eyazaoun/BeeWarm/Progress/Photos/PCB_SCHEMATIC.jpeg

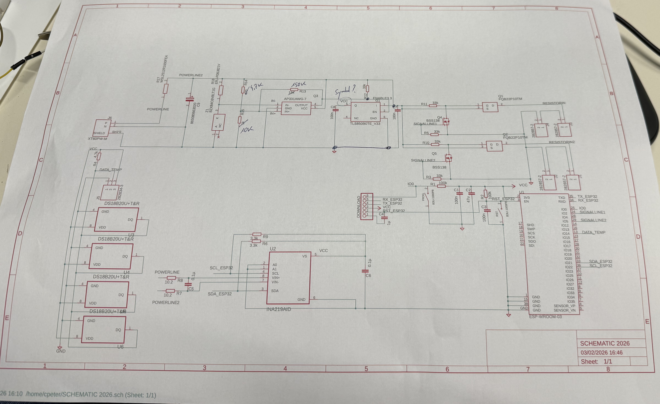
Progress/Photos/PCB_SCHEMATIC.jpeg
