eyazaoun/BeeWarm/Progress/Photos/IMG_8524.jpeg

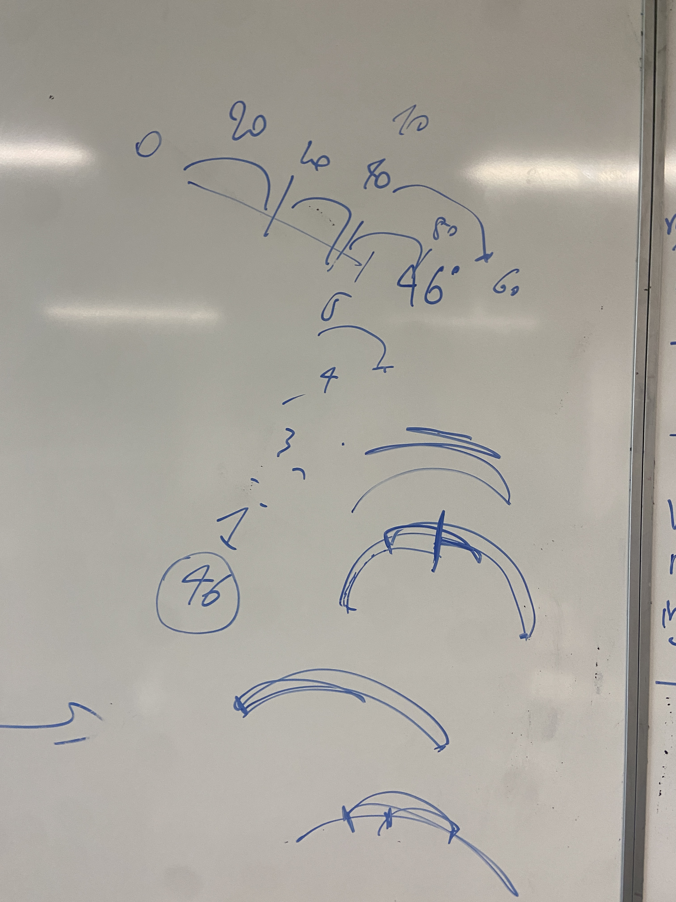
Progress/Photos/IMG_8524.jpeg
