eyazaoun/BeeWarm/doc/SOUTENANCE S7 PROJET ELECTRONIQUE BEEWARM.pptx

## PROJET ELECTRONIQUE :

BEEWARM

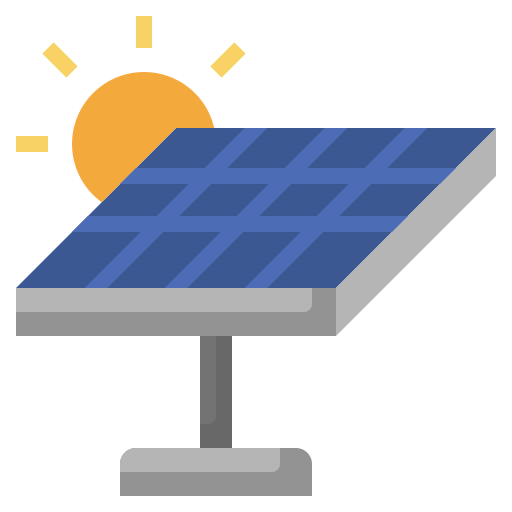
[picture p18: figure]
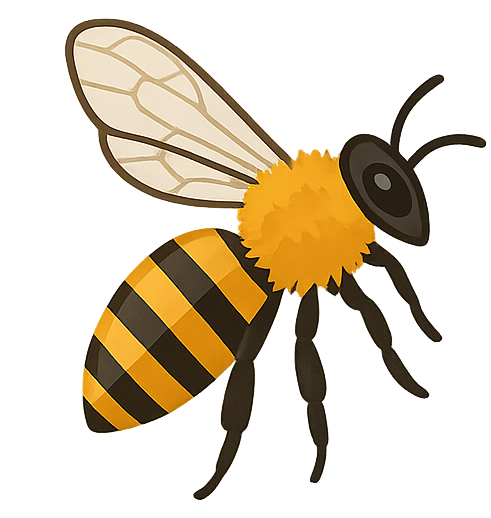
[picture p19: figure]
ChatGPT Image 25 oct. 2025, 20_07_55

Eya ZAOUN
Valentin GIROD-ROUX
Hussein ELSOUDA
Anas ESSALIMI
Électronique et Systèmes Embarqués - 2025/2026

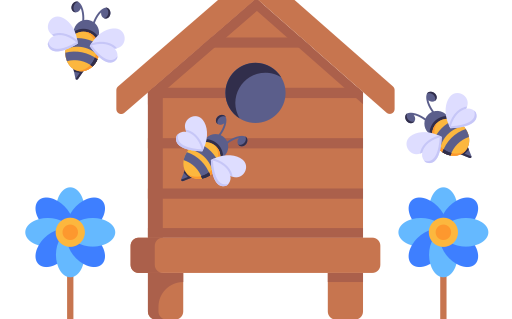
[picture p20: figure]
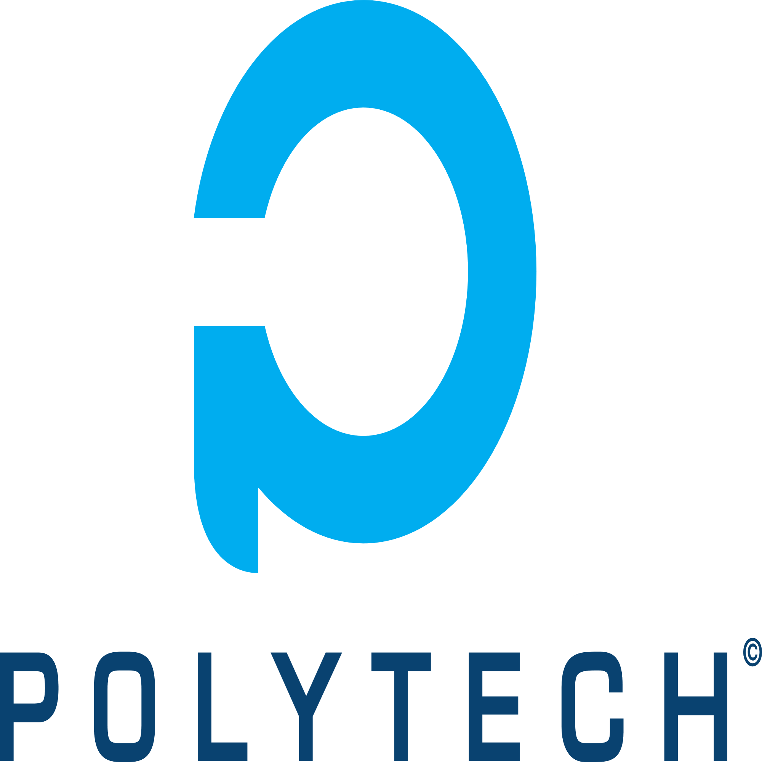
[picture p21: figure]
Logo_Reseau_Polytech
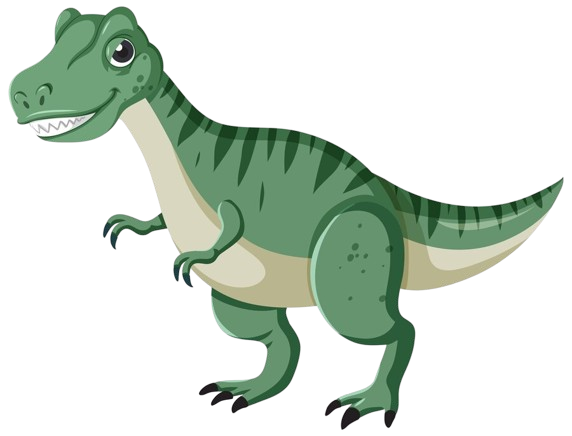
[picture p22: figure]
dino_poly-removebg-preview

## Contexte et problématique

- Système de chauffage utilisant l'énergie solaire facilitant le développement d'essaim
- Sensibilité des abeilles aux variations de température
- Besoin de maintien thermique en hiver
- Système autonome (sans réseau électrique / sans batterie)
- Suivi et réglage à distance

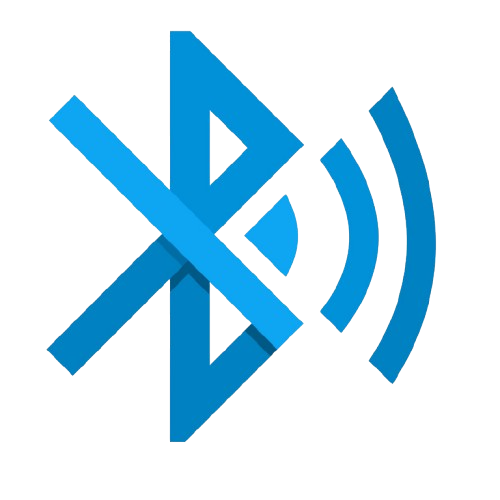
[picture p23: figure]

1

## EXIGENCES DU SYSTèME

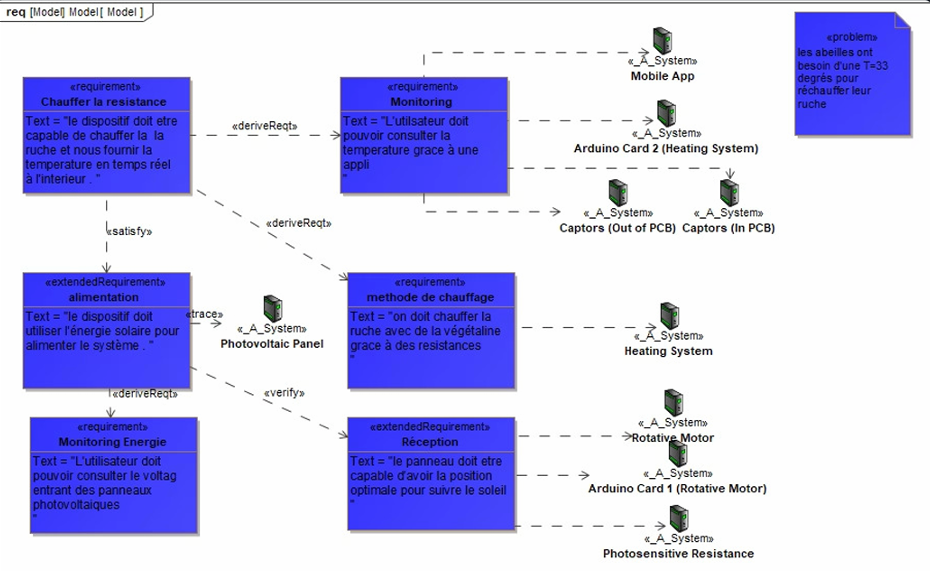
[picture p24: figure]

2

## Suivi solaire et alimentation

- Panneau solaire orientable
- Photo-résistances (détection du soleil)
- Moteur pas à pas

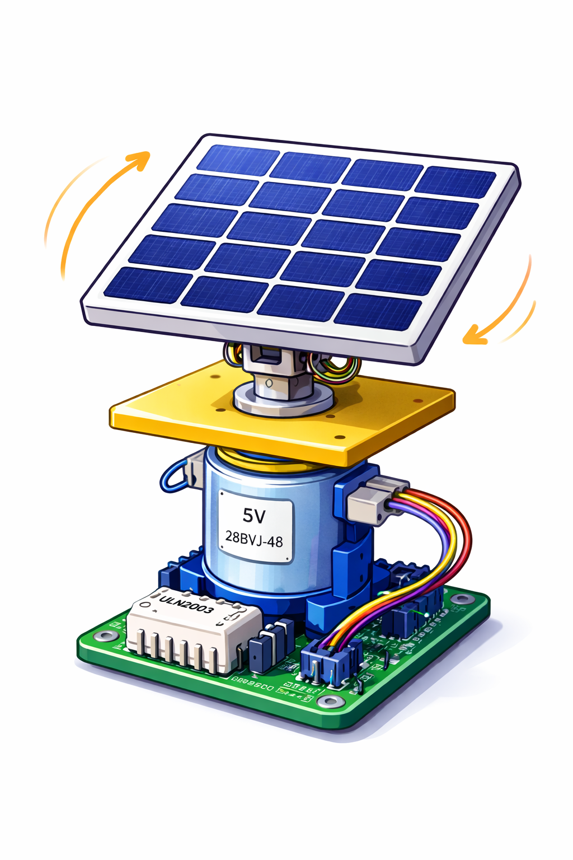
[picture p25: figure]
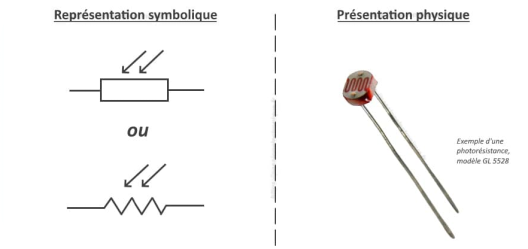
[picture p26: figure]

3

## Fonctionnement d’UNE photorésistance

- Composant créé à partir d’un semi-conducteur
- Résistance diminue lorsque c’est éclairé

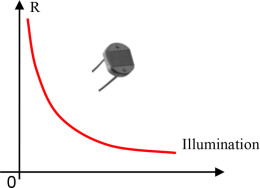
[picture p27: figure]

4

## PILOTAGE AUTOMATIQUE DU MOTEUR

- Moteur pas à pas 28BYJ-48 avec driver ULN2003
- Commande basée sur la différence de tension entre les photorésistances

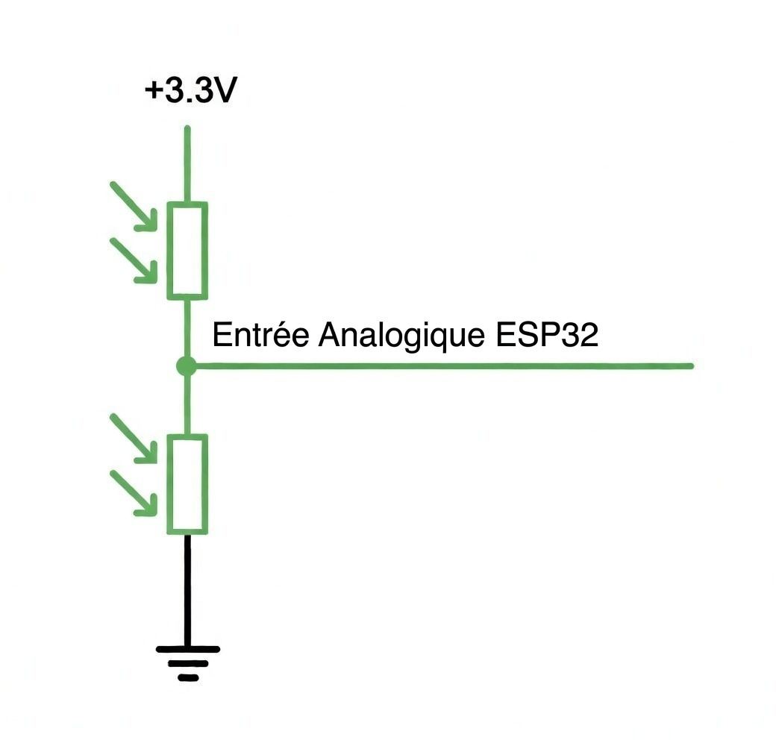
[picture p28: figure]

5

## PILOTAGE AUTOMATIQUE DU MOTEUR

- On peut distinguer trois cas :

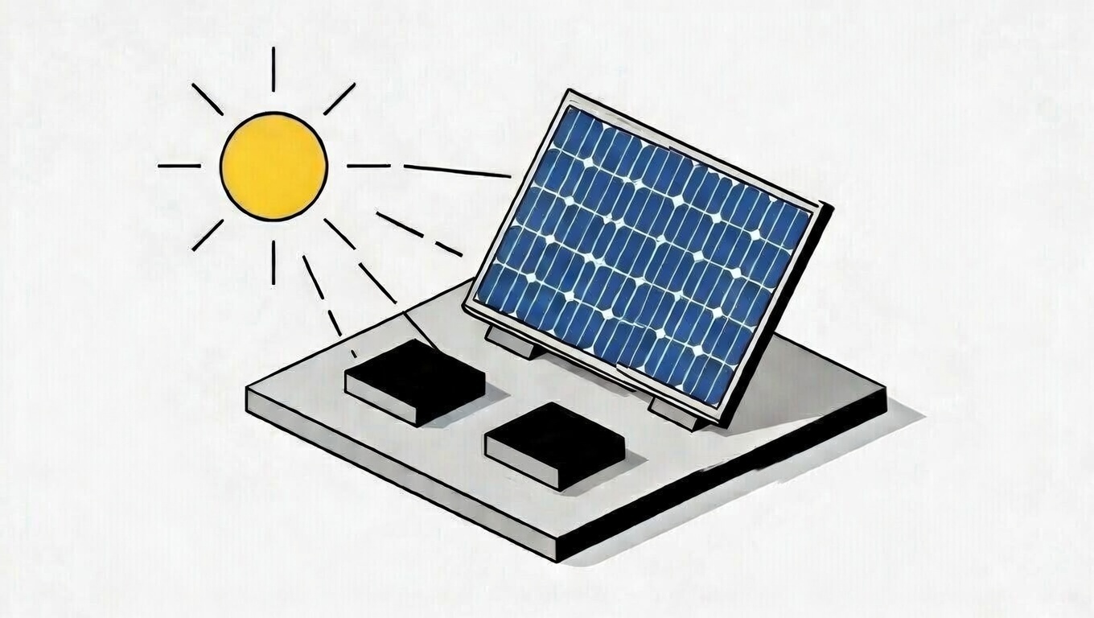
[picture p29: figure]
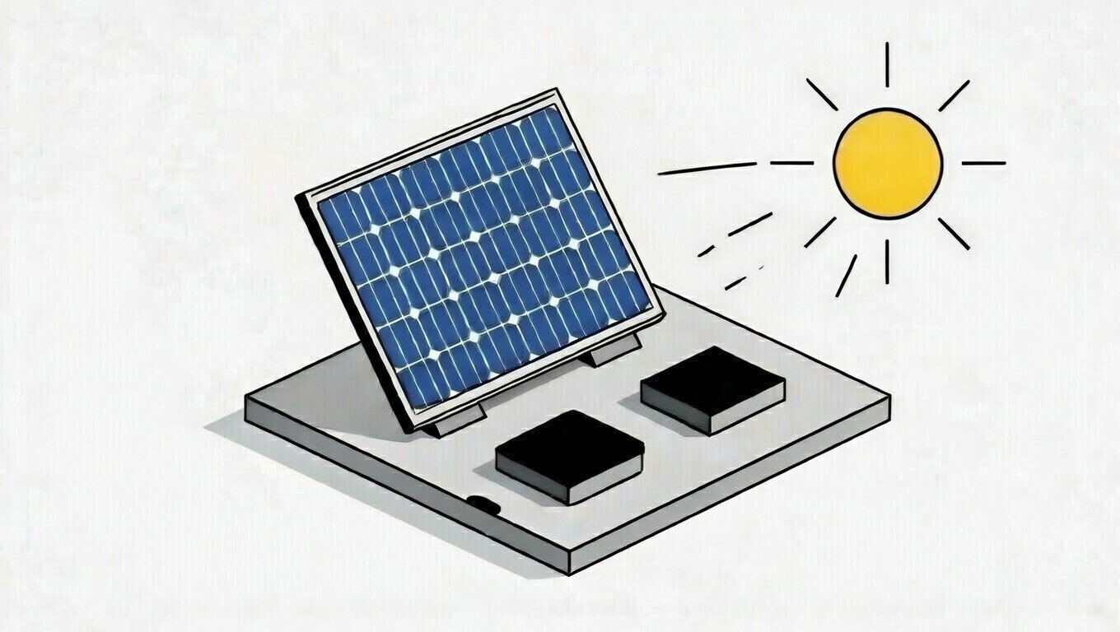
[picture p30: figure]
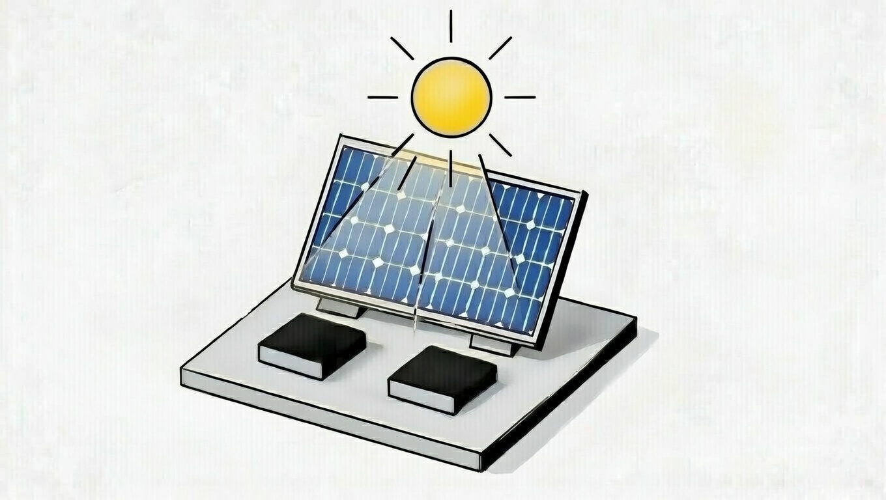
[picture p31: figure]

6

## PILOTAGE AUTOMATIQUE DU MOTEUR

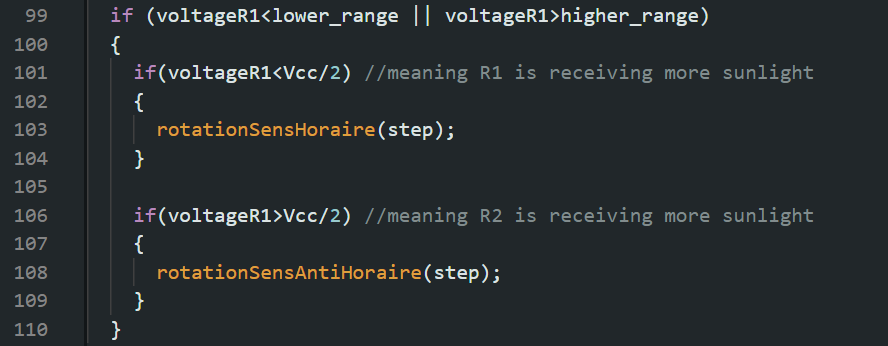
[picture p32: figure]

7

## Chauffage et régulation de température

- Capteurs DS18B20
- Température ruche / végétaline
- Température de consigne
- Chauffage par résistances
- Adaptation de la puissance de chauffe via PWM en fonction de la puissance solaire

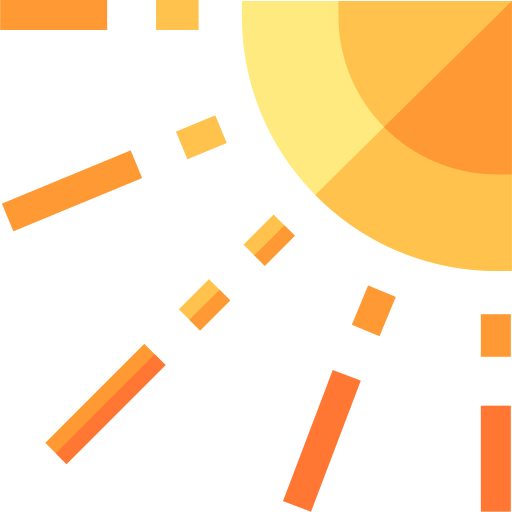
[picture p33: figure]
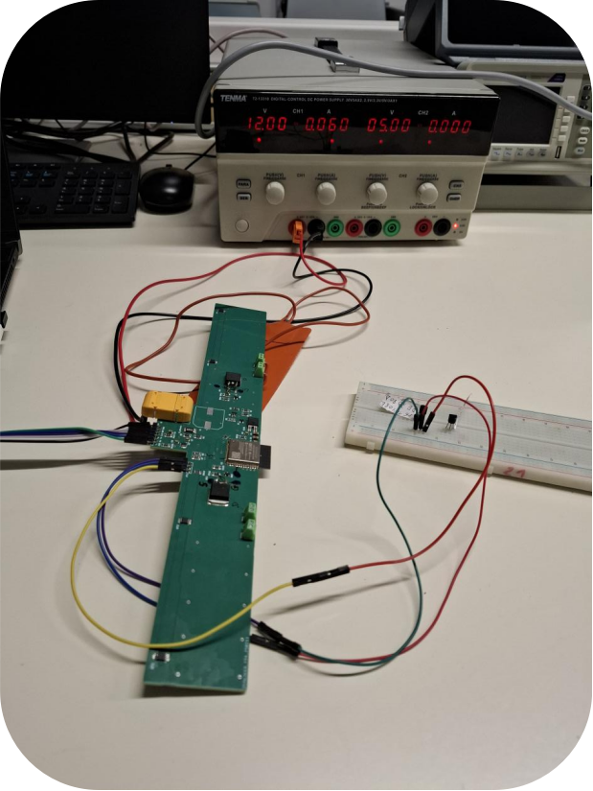
[picture p34: figure]

8

## Communication Bluetooth

- Bluetooth classique ESP32
- Échange de données bidirectionnel
- Monitoring + réglage consigne
- Choix Bluetooth :
  - Faible consommation
  - Pas d’infrastructure réseau

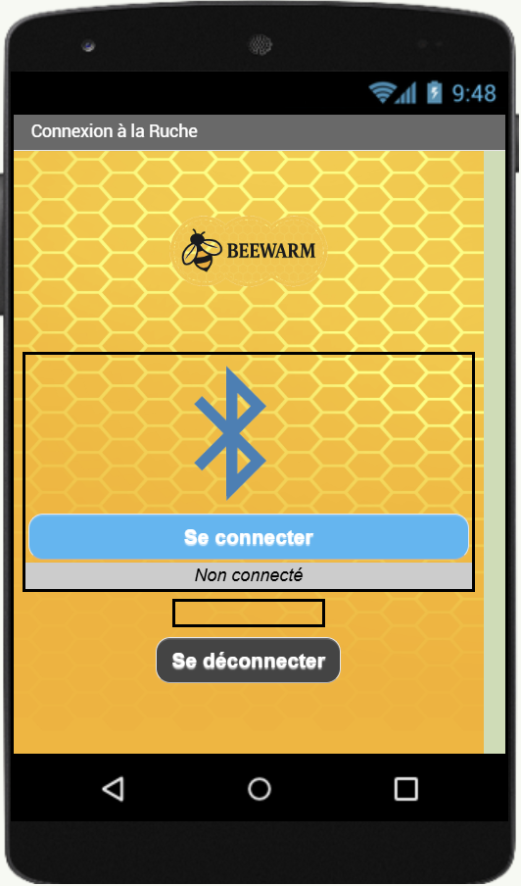
[picture p35: figure]
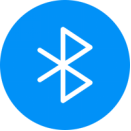
[picture p36: figure]
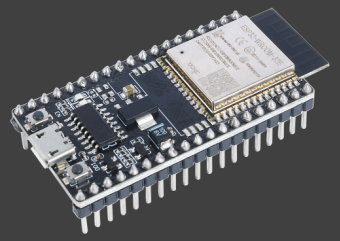
[picture p37: figure]

9

## Protocole de communication

- Message ESP32 → Smartphone :
DATA;tVeg°C;tRuche°C
- Message Smartphone → ESP32 :
SET:SP=32
- Format simple et robuste
- Facile à parser

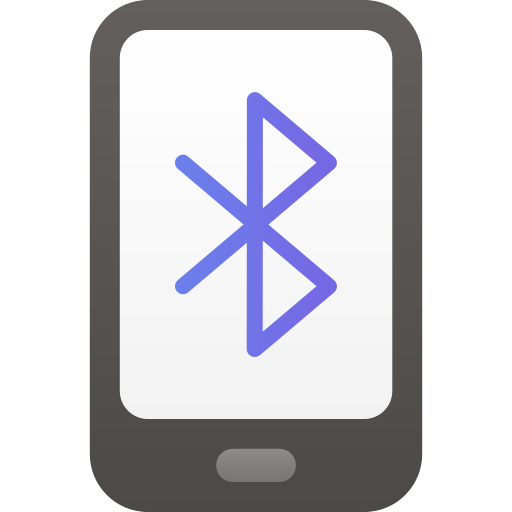
[picture p38: figure]
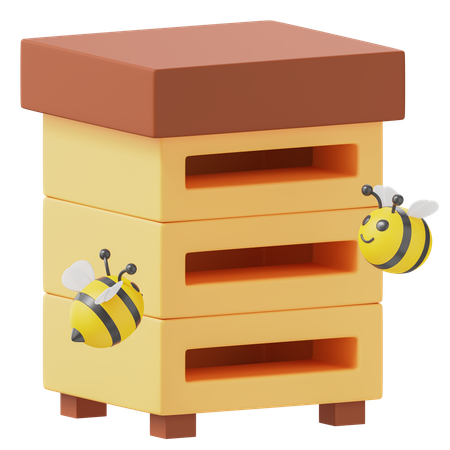
[picture p39: figure]

10

## Slide 12

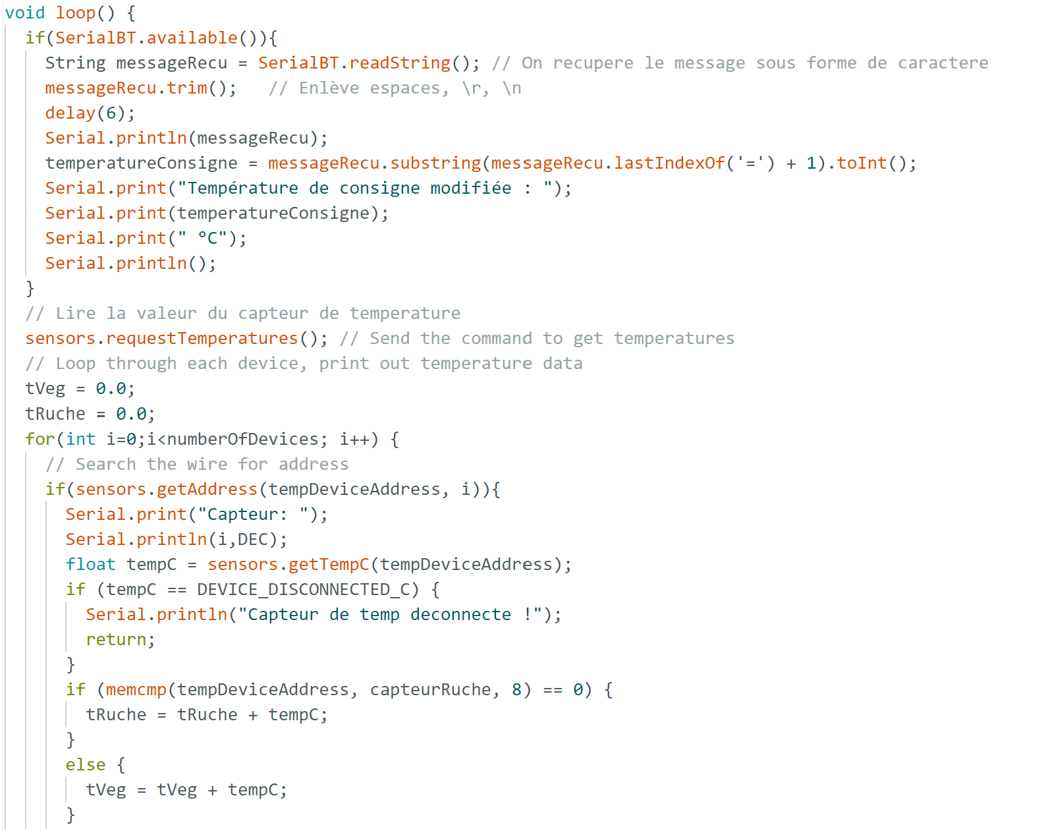
[picture p40: figure]

Détection des Capteurs et mise à jour des températures

Modification de consigne

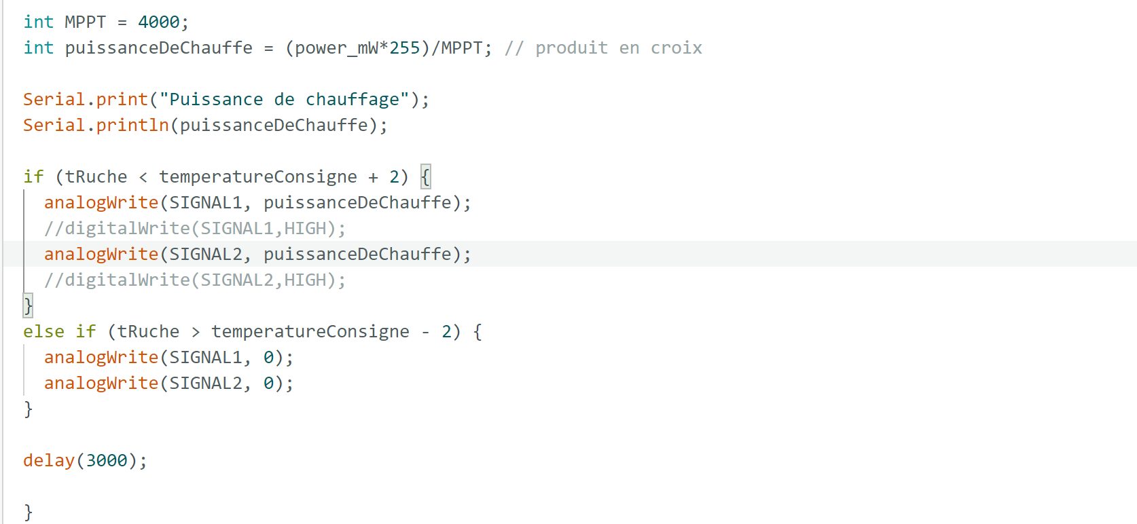
[picture p41: figure]

Control de chauffage

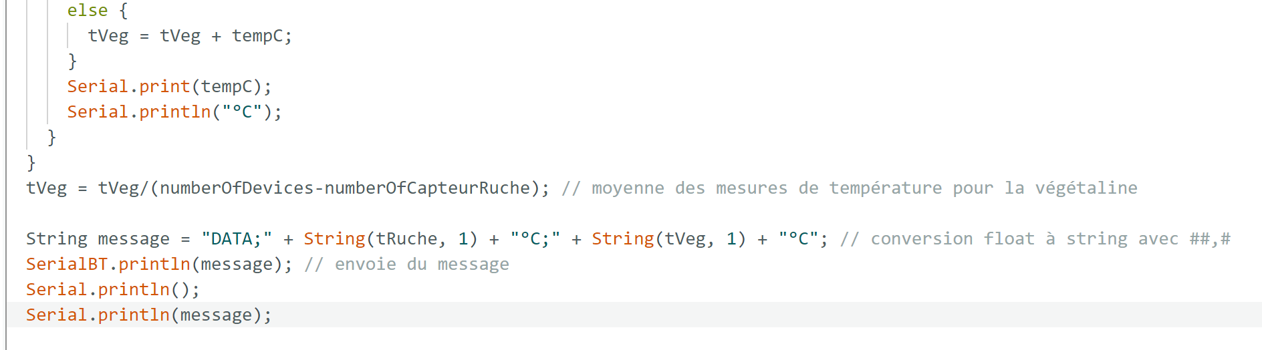
[picture p42: figure]

Affichage et envoie des données

Calcul de tVeg

11

## Application Android

- Développée sous MIT App Inventor
- Plusieurs écrans :
  - Connexion Bluetooth
  - Menu
  - Monitoring température
  - Réglage consigne

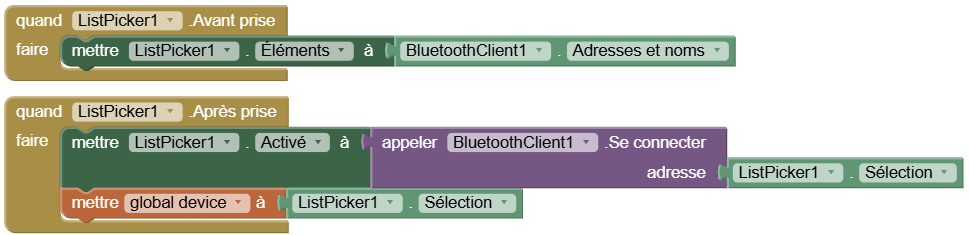
[picture p43: figure]
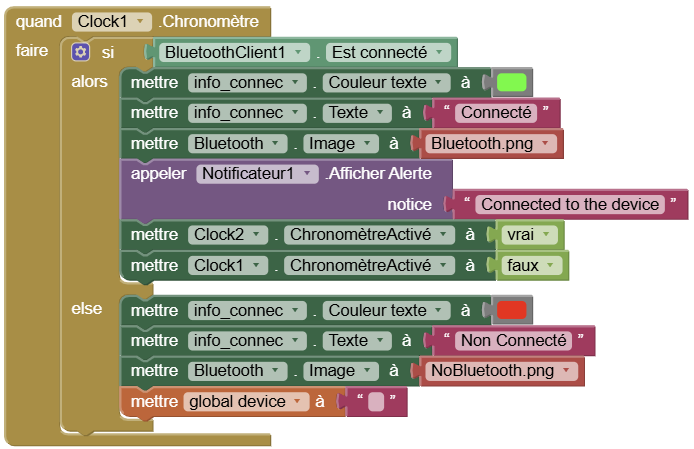
[picture p44: figure]

12

## Application Android

- Développée sous MIT App Inventor
- Plusieurs écrans :
  - Connexion Bluetooth
  - Menu
  - Monitoring température
  - Réglage consigne

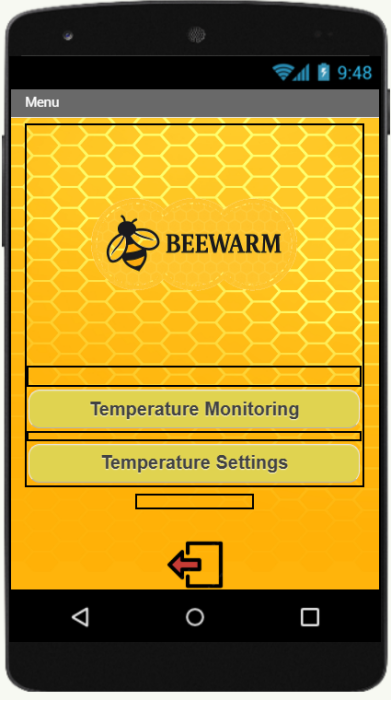
[picture p45: figure]
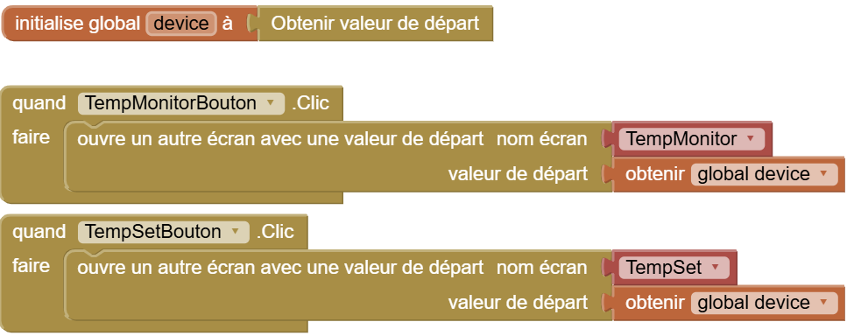
[picture p46: figure]

13

## Application Android

- Développée sous MIT App Inventor
- Plusieurs écrans :
  - Connexion Bluetooth
  - Menu
  - Monitoring température
  - Réglage consigne
- Graphiques en temps réel

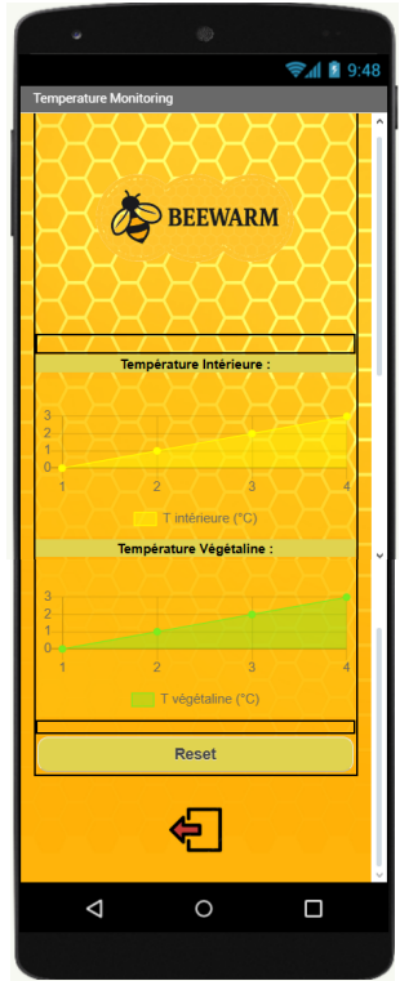
[picture p47: figure]
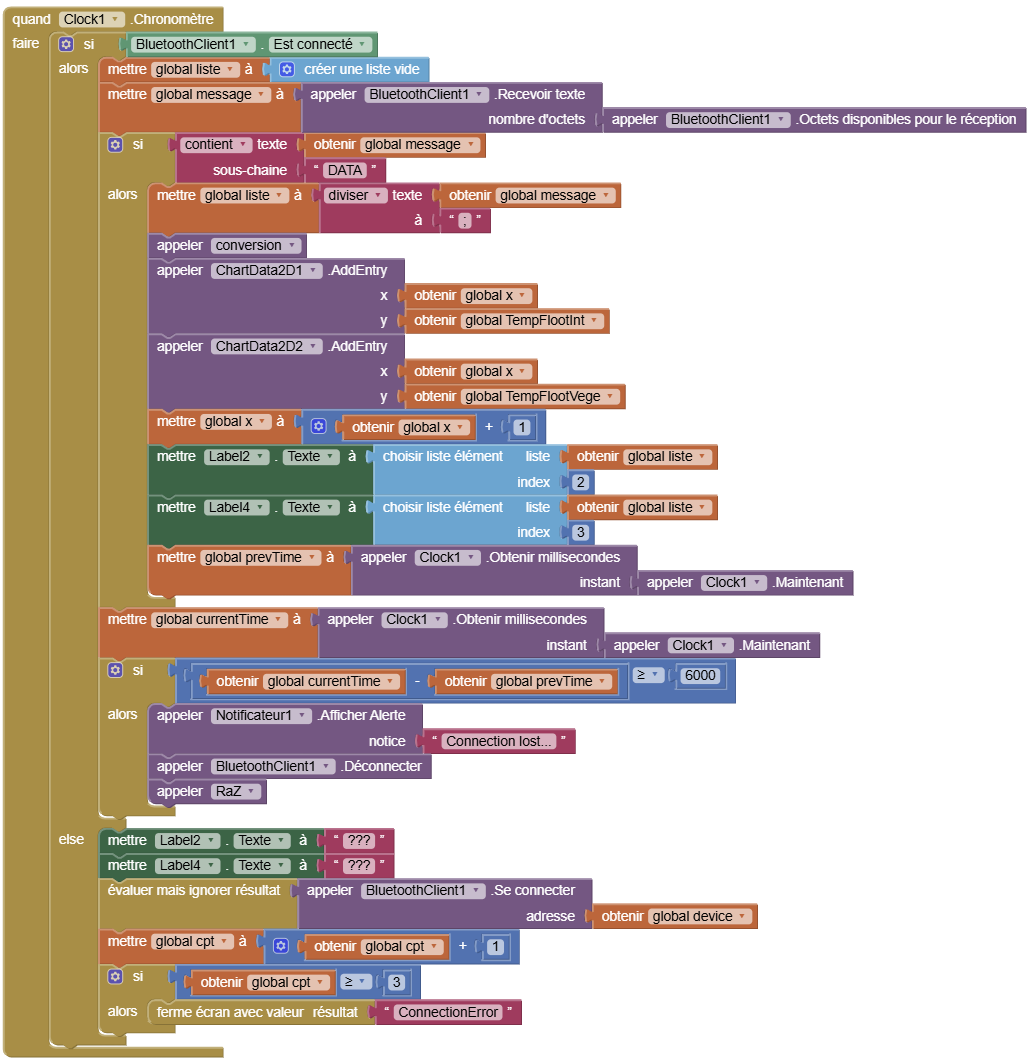
[picture p48: figure]
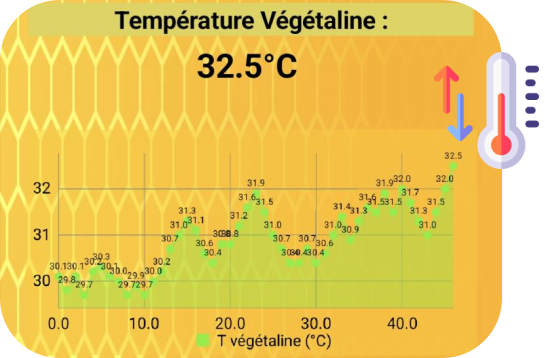
[picture p49: figure]

14

## Application Android

- Développée sous MIT App Inventor
- Plusieurs écrans :
  - Connexion Bluetooth
  - Menu
  - Monitoring température
  - Réglage consigne

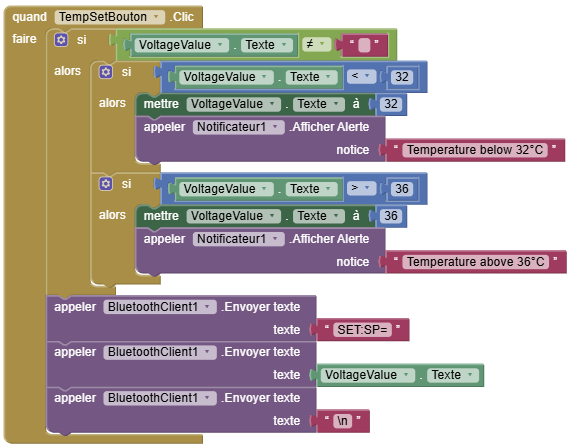
[picture p50: figure]
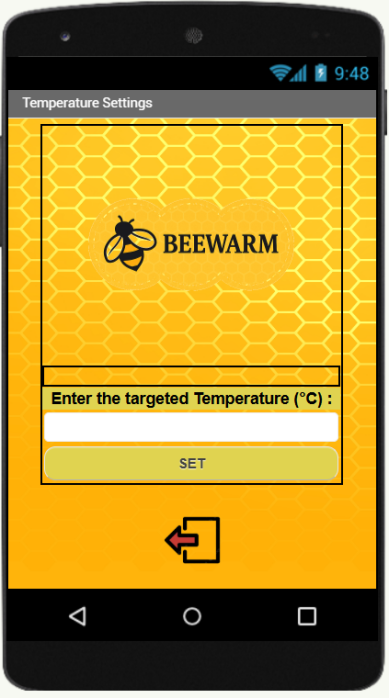
[picture p51: figure]

15

## Robustesse de la communication

- Surveillance du temps entre messages
- Détection de perte Bluetooth (> 5 s)
- Reconnexion automatique (2 tentatives)
- Retour à l’écran de connexion

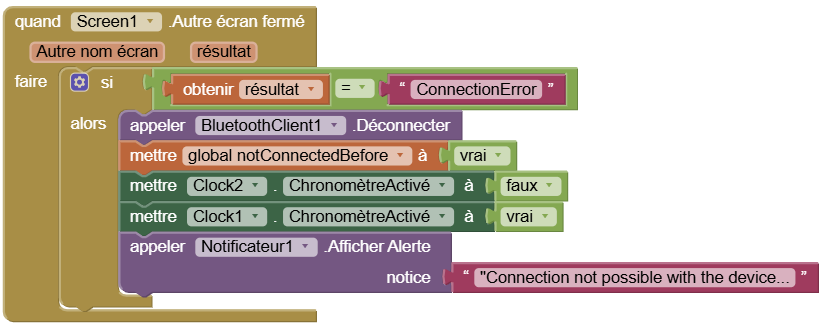
[picture p52: figure]
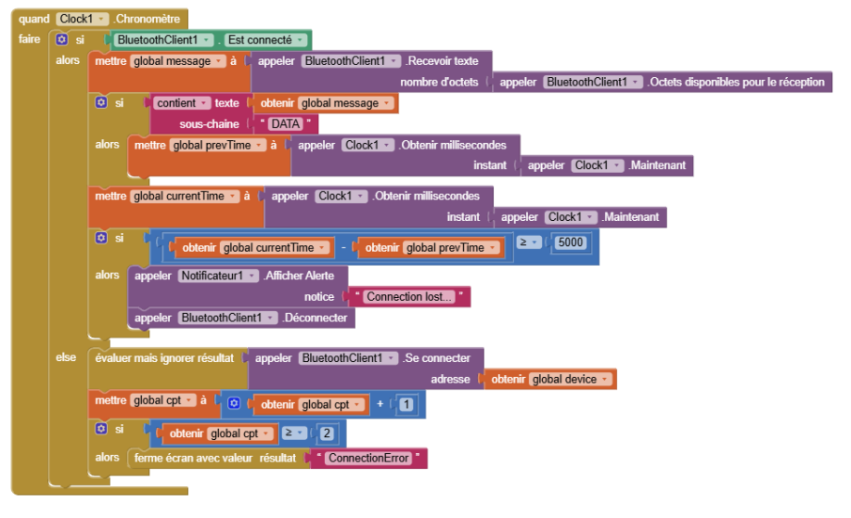
[picture p53: figure]

16

## Architecture du système

- Panneau solaire orientable
- Carte électronique (ESP32)
- Capteurs de température
- Résistances chauffantes
- Communication Bluetooth
→ Smartphone

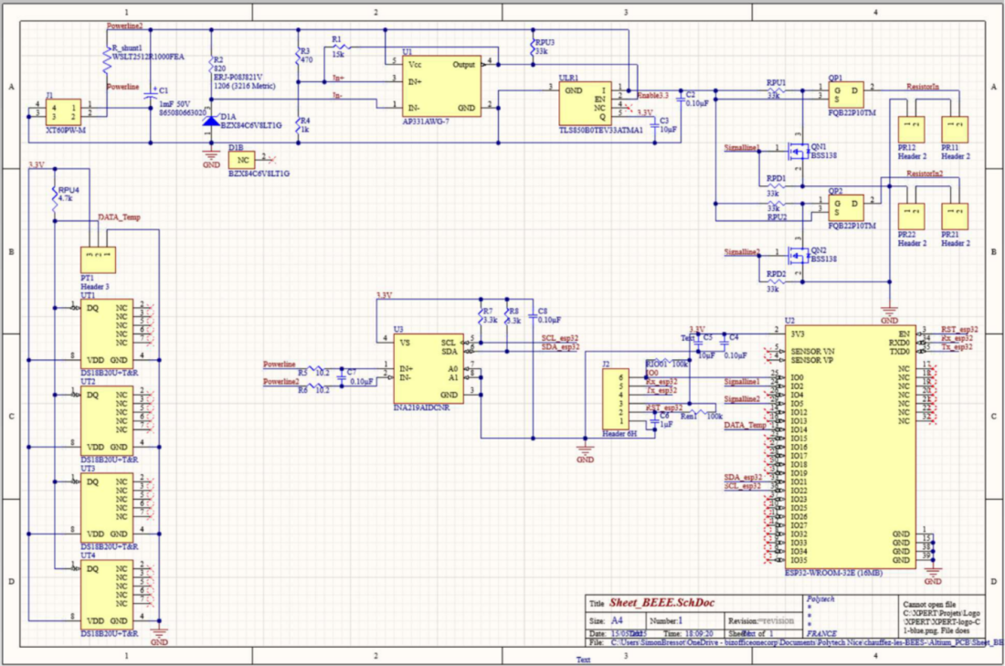
[picture p54: figure]

17

## PARTIE PCB sur eagle

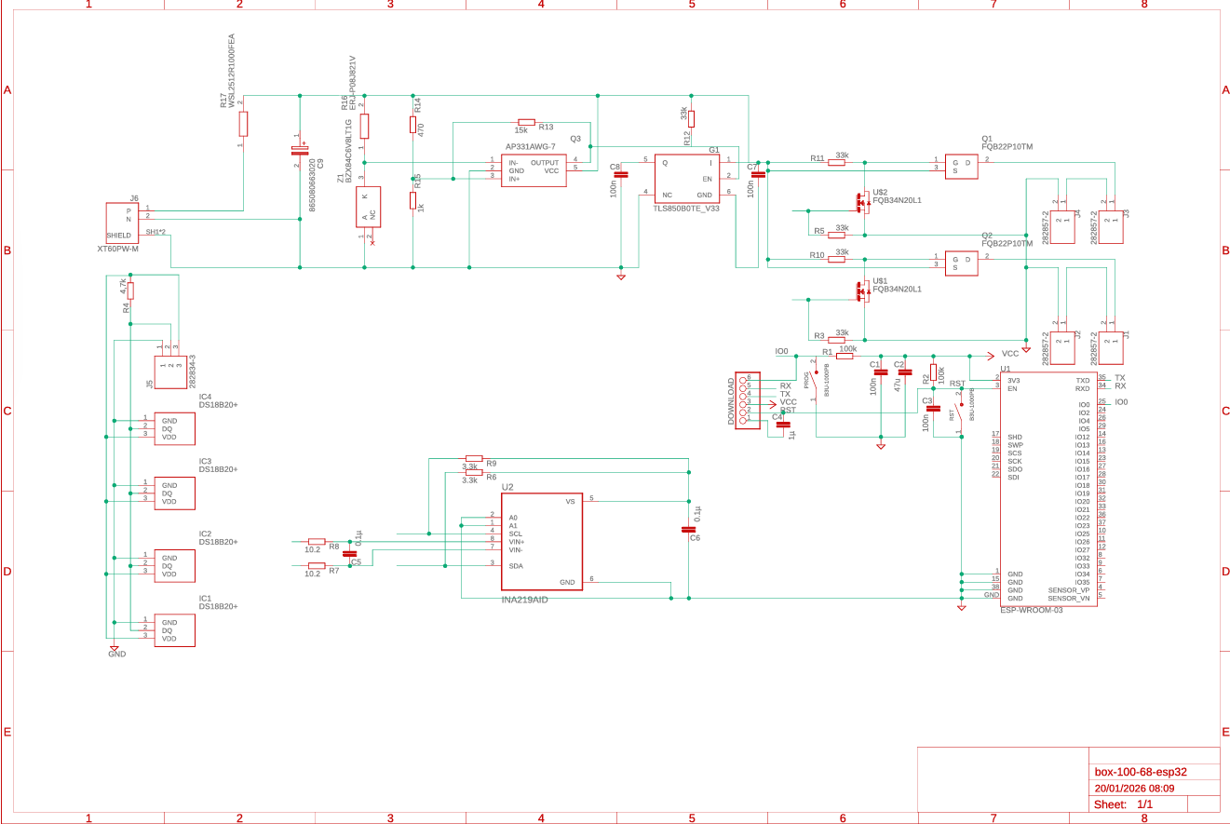
[picture p55: figure]

- Retranscription du PCB de Altium sur EAGLE avec les librairies SnapEDA

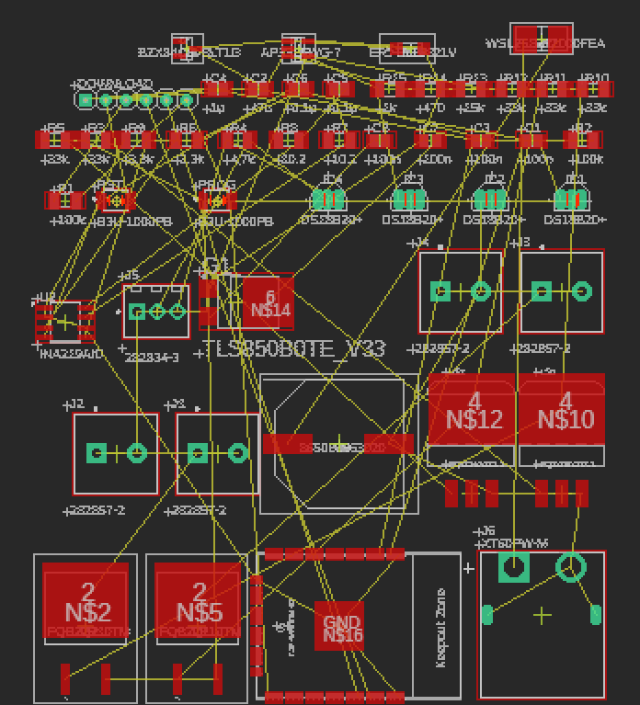
[picture p56: figure]

Layout du PCB

18

8

## PARTIE PCB sur eagle : ALIMENTATION

- PARTIE

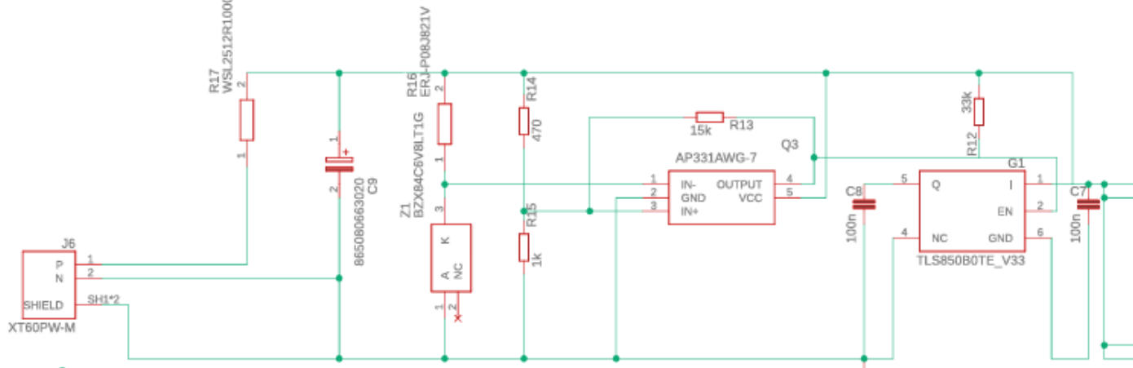
[picture p57: figure]

19

8

## PARTIE PCB sur eagle : BLOC ESP32

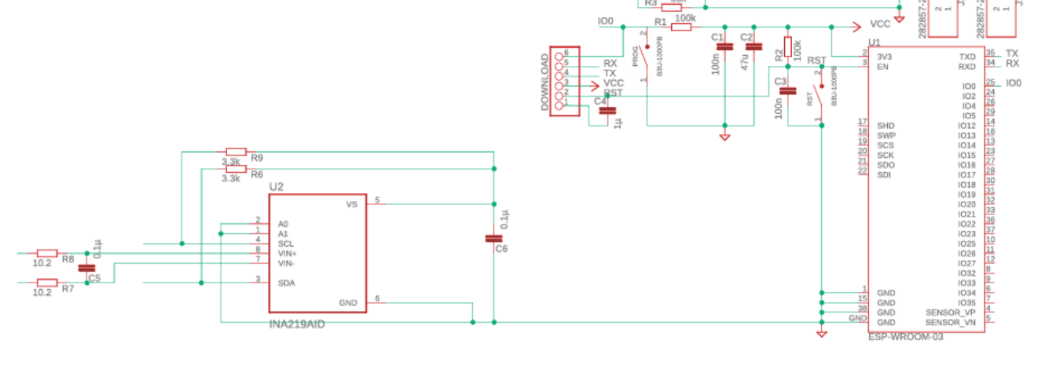
[picture p58: figure]

- PARTIE

20

8

## PARTIE PCB sur eagle

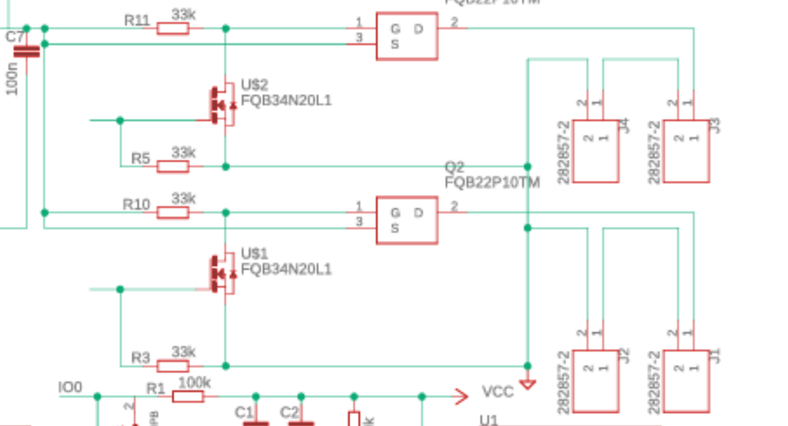
[picture p59: figure]

- PARTIE

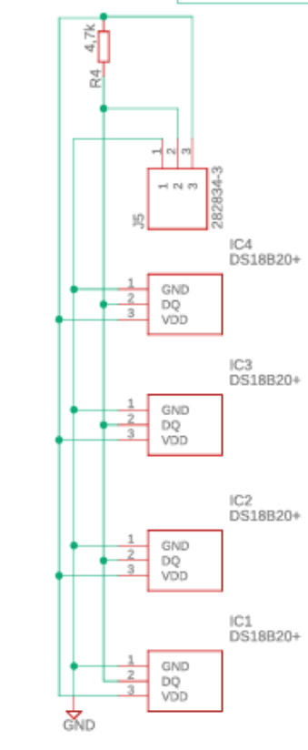
[picture p60: figure]

21

8

## Avancement du projet & Problèmes rencontrés

- Communication Bluetooth fonctionnelle
- Application opérationnelle
- Lecture réelle des capteurs
Mais :
- Problèmes PCB identifiés
- Défaut PCB (ligne SignalLine1)
- Destruction régulateur + ESP32
- Hypothèse : court-circuit de la résistance RPD1 (GND trop près du VCC)

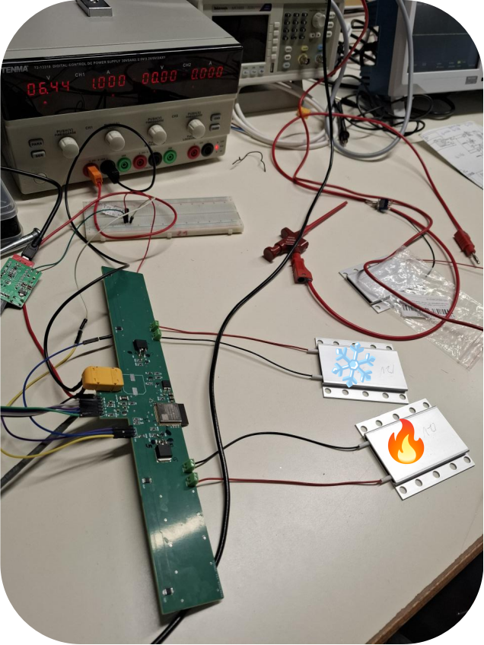
[picture p61: figure]
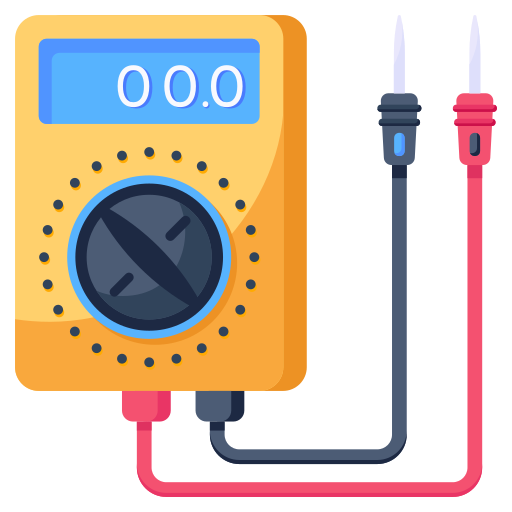
[picture p62: figure]

22

## Conclusion & Perspectives

- Communication entre l’application et l’ESP32 => monitoring et setting opérationnels
- Suivi du soleil par le panneau solaire ok
Mais :
- Layout PCB à faire / commande du PCB
- Validation complète du chauffage à faire
- Tests en conditions réelles

MERCI !

23
