eyazaoun/BeeWarm/doc/SOUTENANCE S8 PROJET ELECTRONIQUE BEEWARM.pptx

## PROJET ELECTRONIQUE :

BEEWARM

ChatGPT Image 25 oct. 2025, 20_07_55

Eya ZAOUN
Valentin GIROD-ROUX
Hussein ELSOUDA
Anas ESSALIMI
Électronique et Systèmes Embarqués - 2025/2026

Logo_Reseau_Polytech
dino_poly-removebg-preview

## SOMMAIRE

1. RAPPEL Contexte et problématique
2. Fonctionnement du PCB
3. Schématique et Layout sur EAGLE
4. Modélisation et impression 3D des pièces mécaniques
5. Assemblage des composants du PCB
6. Algorithme MPPT et optimisation de l’énergie
7. Conclusion et perspectives

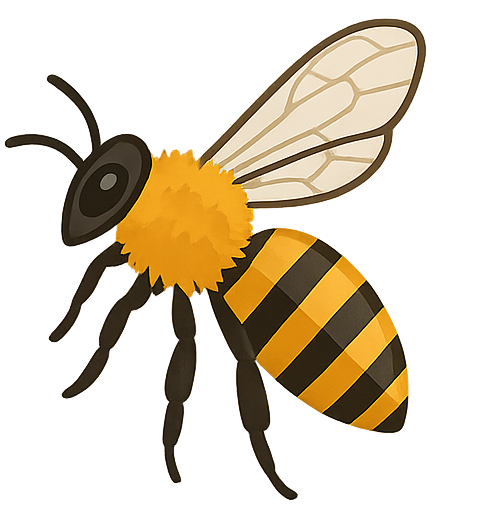
[picture p63: figure]
ChatGPT Image 25 oct. 2025, 20_07_55

1

## Contexte et problématique

-Système de chauffage utilisant l'énergie solaire facilitant le développement d'essaim
-Sensibilité des abeilles aux variations de température
-Besoin de maintien thermique en hiver
-Système autonome (sans réseau électrique / sans batterie)
-Suivi et réglage à distance

2

## FONCTIONNEMENT DU PCB

Quatres parties principales :
-Alimentation
-Contrôle
-Capteurs
-Résistances chauffantes

3

## FONCTIONNEMENT DU PCB

Alimentation :

4

## FONCTIONNEMENT DU PCB

Alimentation + Résistances Chauffantes :

5

## FONCTIONNEMENT DU PCB

Résistances Chauffantes :

6

## FONCTIONNEMENT DU PCB

Alimentation + Résistances Chauffantes + Capteurs :

7

## FONCTIONNEMENT DU PCB

Capteurs :

8

## FONCTIONNEMENT DU PCB

Alimentation + Résistances Chauffantes + Capteurs + Contrôle :

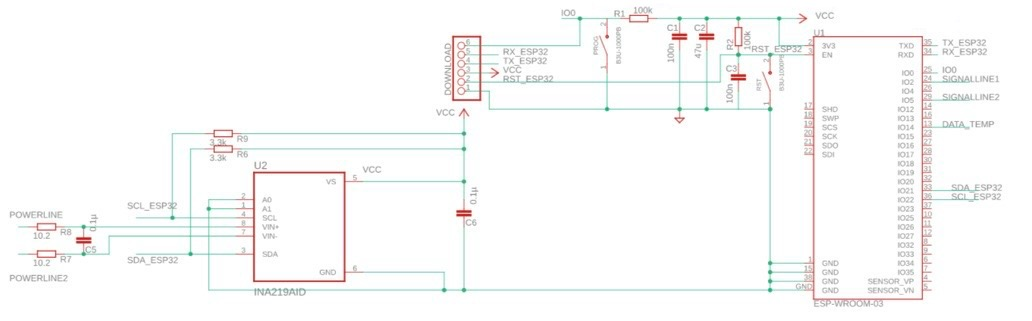
[picture p64: figure]

9

## FONCTIONNEMENT DU PCB

Contrôle :

10

## FONCTIONNEMENT DU PCB

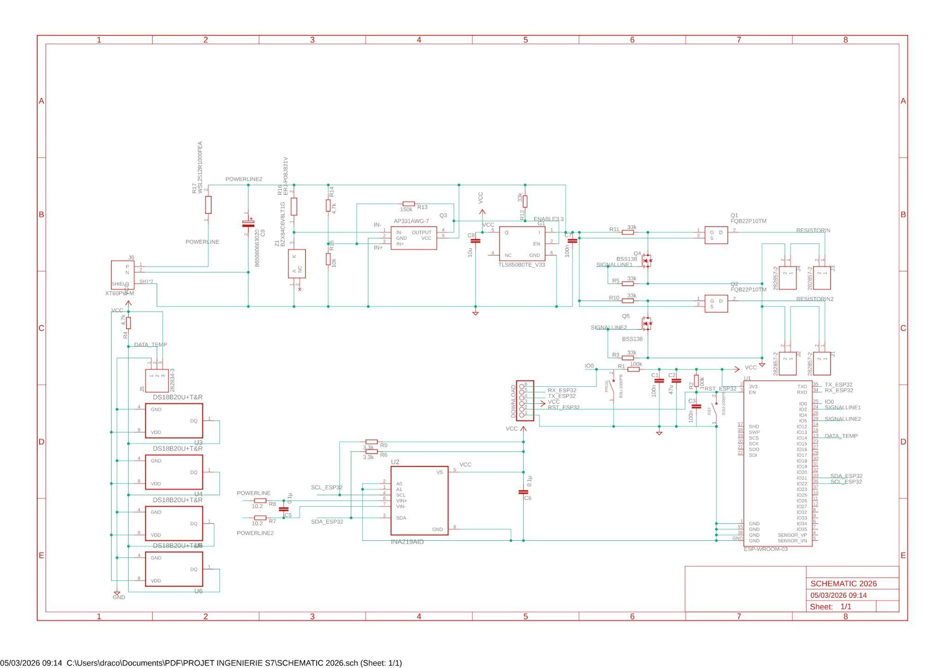
[picture p65: figure]

PCB :

11

## Slide 13

1. SCHÉMATIQUE : SÉCURISER LA BASE

18

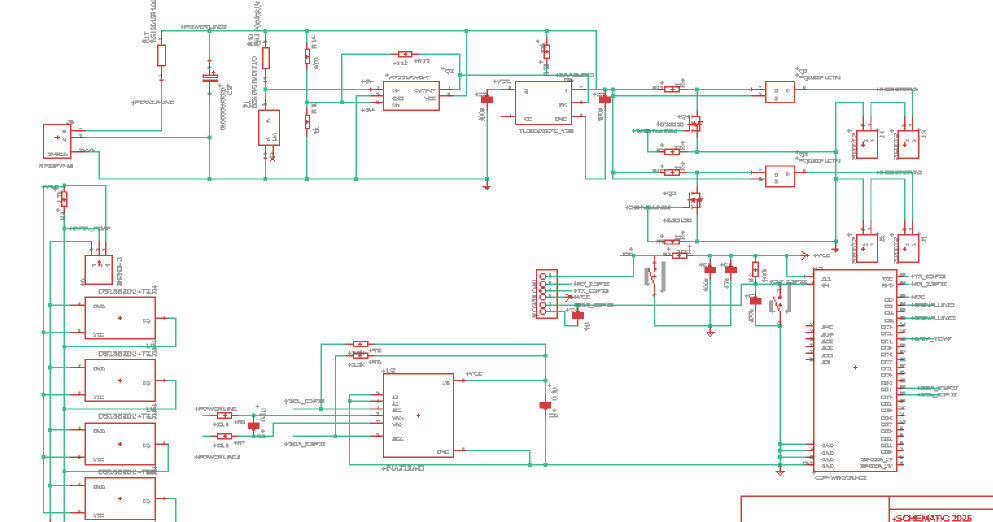
[picture p66: figure]

Schéma Eagle révisé : blocs alimentation, ESP32, capteurs et chauffage

Retranscription Altium vers Eagle.
Contrôle symbole + footprint PCB.
Vérification connectiques et références.

ACTIONS

Composant avec symbole mais sans empreinte exploitable.
Référence proche mais boîtier/pinout différent.

ERREURS À ÉVITER

Toujours valider BOM - symbole - footprint avant le layout.
Comparer avec l’ancienne version validée.

RÉFLEXE

12

Notes: Slide 1 - En soutenance : je commence par le schématique. Avant de router, on a sécurisé la base : chaque symbole doit correspondre à une empreinte PCB réelle. On a aussi comparé avec l’ancienne version Altium pour éviter une erreur de référence ou de pinout dès le départ.

## Slide 14

2. PLACEMENT : PRÉPARER UNE BONNE DISPOSITION

19

Premier placement des composants sur la board

Blocs fonctionnels : alimentation / ESP32 / capteurs / chauffage.
Connecteurs et interfaces gardés en bord de carte.

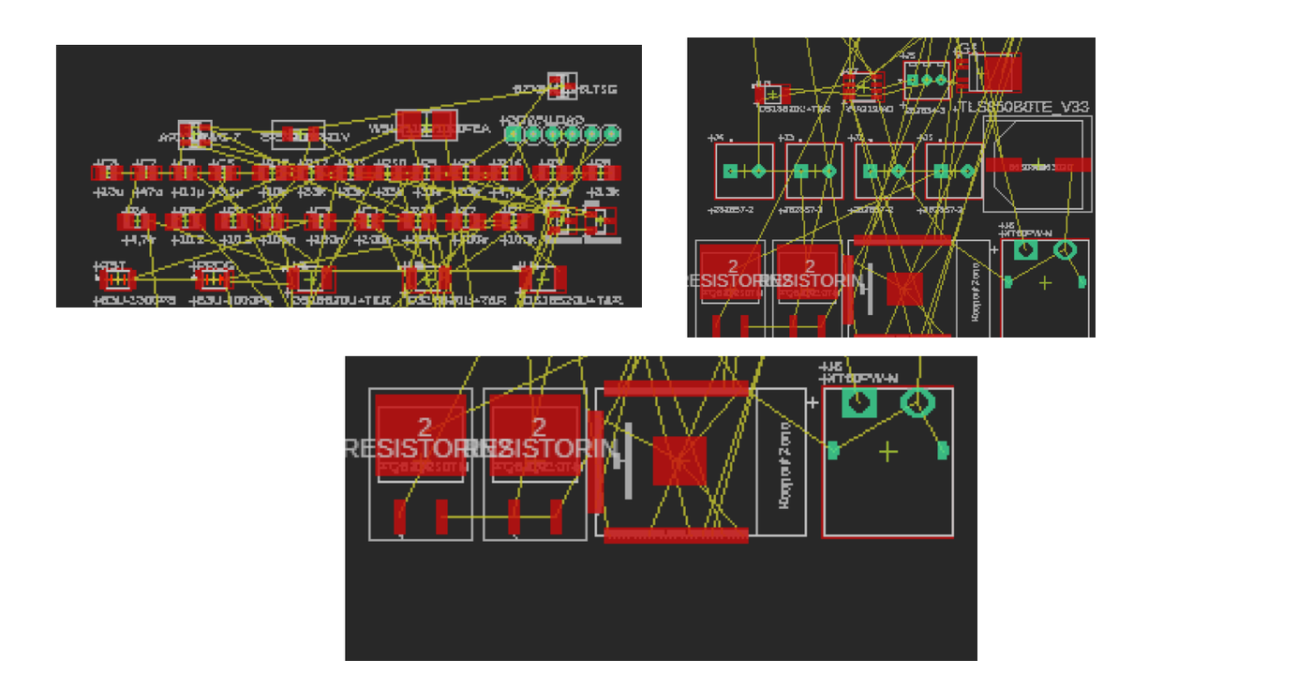
[picture p67: figure]

DÉCOUPAGE

Airwires trop croisés quand les composants sont mal orientés.
Composants trop dispersés => pistes longues et routage dense.
Contraintes mécaniques : éviter les zones exposées à la cire.

ERREURS CONSTATÉES

Tourner avant de router : réduire les croisements dès le placement.
Condensateurs proches des circuits à découpler.
Penser intégration mécanique avant la fabrication.

RÉFLEXES

13

Notes: Slide 2 - Le placement est l’étape où on rend le PCB routable. L’erreur serait de commencer directement à tracer des pistes. Ici, on a regroupé les composants par blocs, placé les interfaces en bord de carte, et utilisé les airwires pour voir ce qui devait être tourné ou déplacé.

## Slide 15

3. ROUTAGE : TRANSFORMER LES AIRWIRES EN PISTES

Carte routée : couches Top et Bottom

20

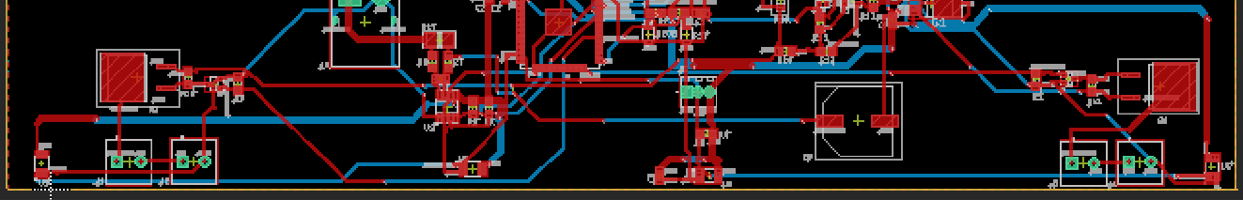
[picture p68: figure]

Routage manuel après un premier essai d’autorouter.
Vias utilisés seulement quand nécessaires.

CE QUI A ÉTÉ FAIT

Pistes visuellement proches mais non connectées au pad.
Espacements insuffisants entre conducteurs.
Largeur VCC à renforcer pour l’alimentation.

ERREURS DÉTECTÉES

Ne jamais se fier uniquement au visuel.
DRC/ERC jusqu’à 0 erreur bloquante.
Interpréter les warnings avant export.

RÉFLEXES

14

Notes: Slide 3 - Ensuite, les airwires deviennent des pistes réelles. On a utilisé les deux couches, avec des vias quand une piste devait changer de face. Après le routage, plusieurs erreurs ont été trouvées : des pistes semblaient connectées mais ne l’étaient pas, certains espacements étaient trop faibles et la piste VCC devait être plus robuste. Le réflexe est donc de vérifier avec les outils Eagle, pas seulement à l’œil.

## Slide 16

4. FABRICATION : VALIDER AVANT D’ALIMENTER

21

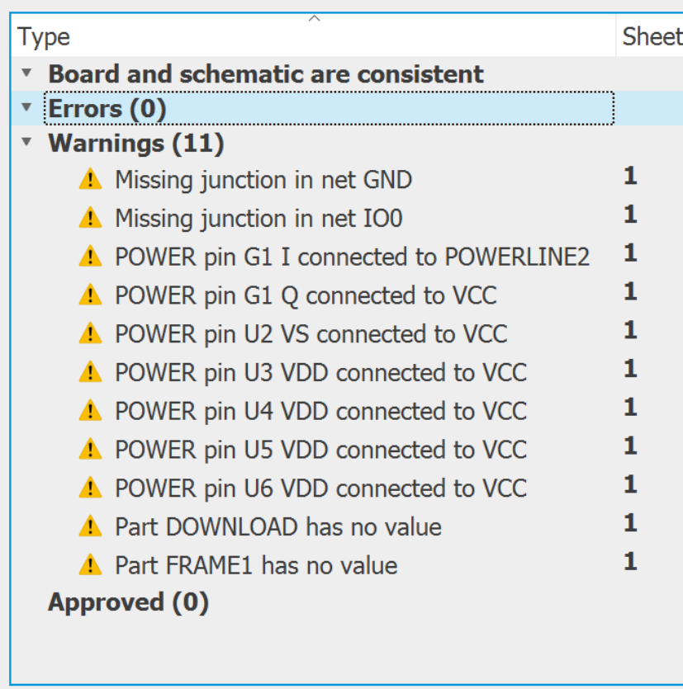
[picture p69: figure]

Vérification : 0 erreur bloquante

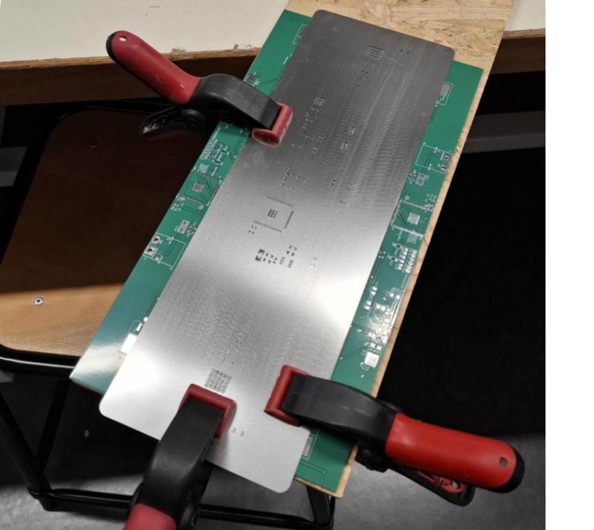
[picture p70: figure]

Pochoir + pâte à braser

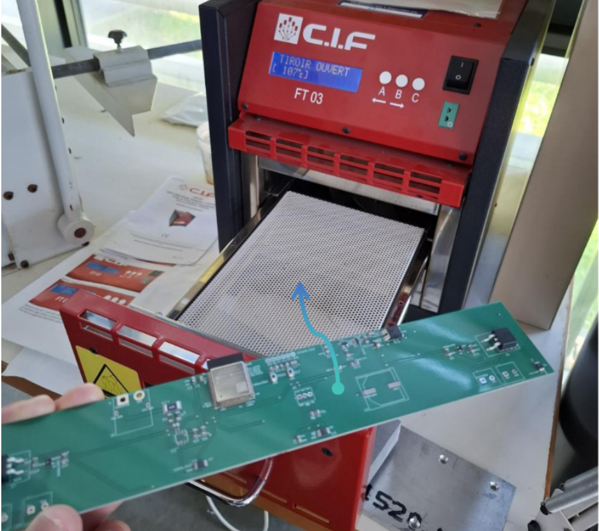
[picture p71: figure]

Four de refusion CMS

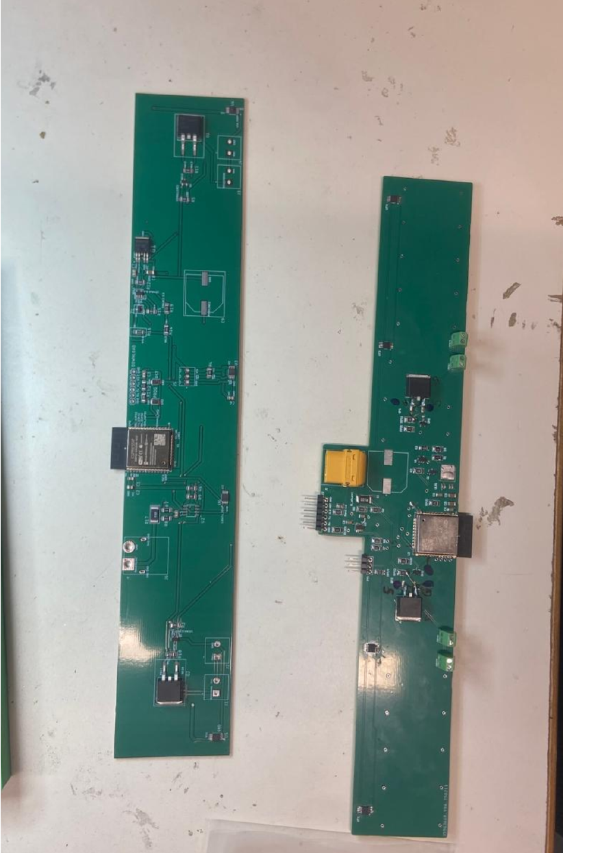
[picture p72: figure]

Cartes assemblées

PROBLÈMES APRÈS TESTS

Défaut PCB : ligne SignalLine1.

ERREUR COMPOSANT

Référence INA différente.
Brochage non compatible avec l’empreinte PCB.
Composant à remplacer avant finalisation.

BOM + footprint vérifiés avant commande.

RÉFLEXES À GARDER

15

Notes: Slide 4 - Une fois les fichiers Gerber exportés, la carte passe à la fabrication : réception de la PCB, pochoir, pâte à braser, placement CMS puis refusion. Mais les tests ont montré que la validation ne s’arrête pas à l’assemblage : on a identifié un problème SignalLine1, la destruction du régulateur et de l’ESP32, probablement liée à une zone GND trop proche du VCC. Le bon réflexe est de faire des tests de continuité et un premier démarrage avec limitation de courant.

## Modélisation 3D des pièces mécaniques

VAL

Conception des pièces sur Onshape :
- Prise de mesures des composants au pied à coulisse
- Réalisation des esquisses des différentes pièces
- Création des volumes par extrusion
- Ajustement des dimensions et assemblages
- Vérification de l’emboîtement des pièces avant impression (assemblage)
- Préparation des fichiers pour l’impression 3D (STL)

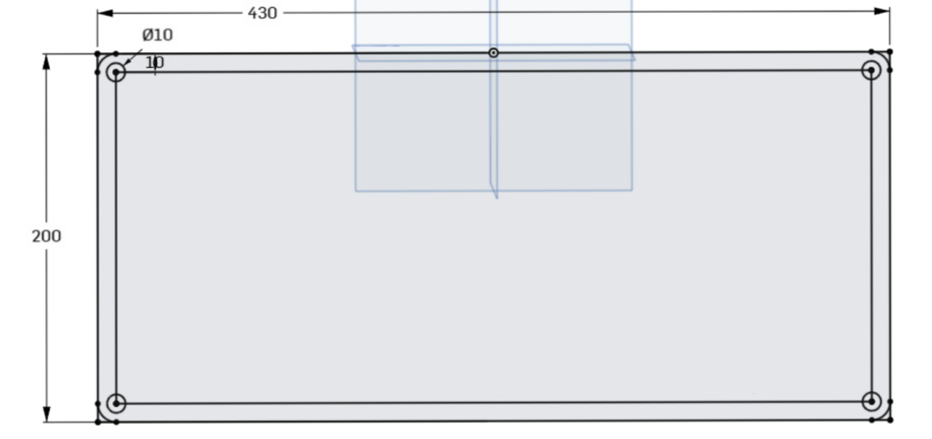
[picture p73: figure]
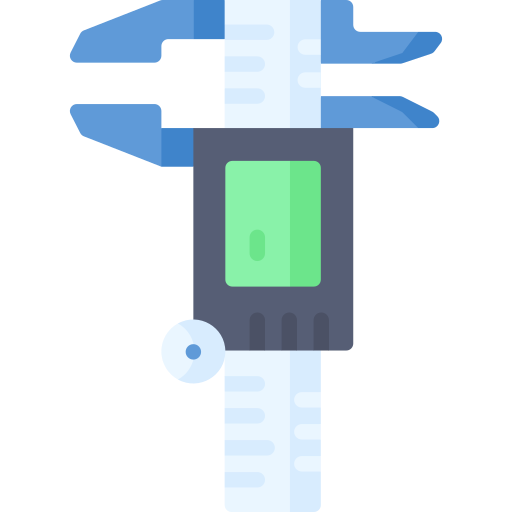
[picture p74: figure]
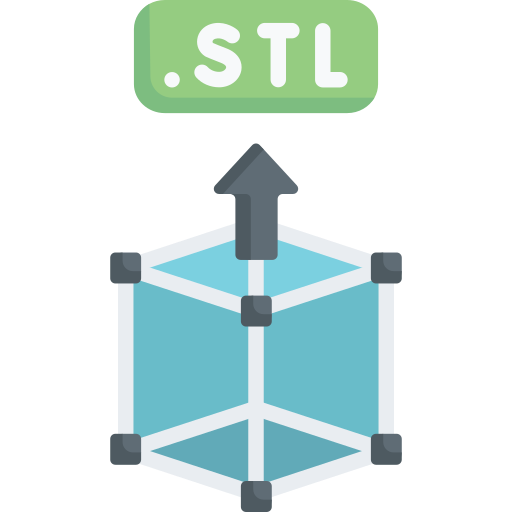
[picture p75: figure]
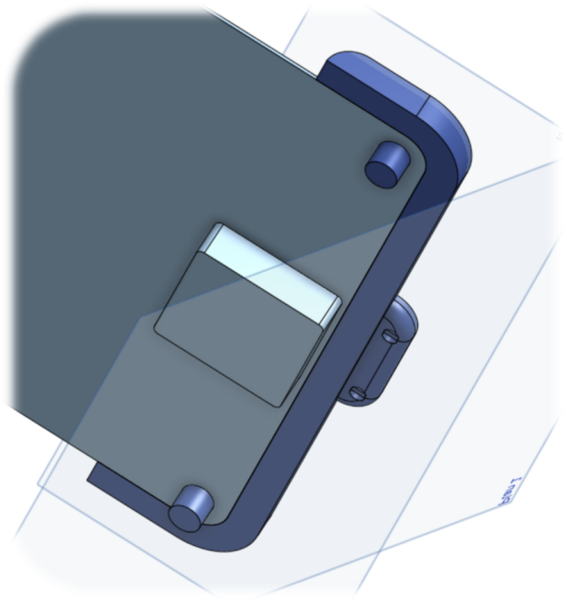
[picture p76: figure]
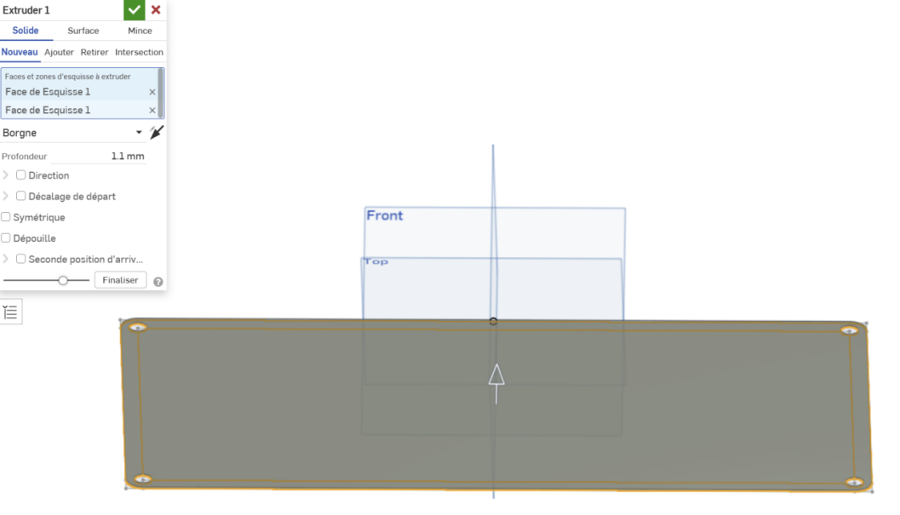
[picture p77: figure]
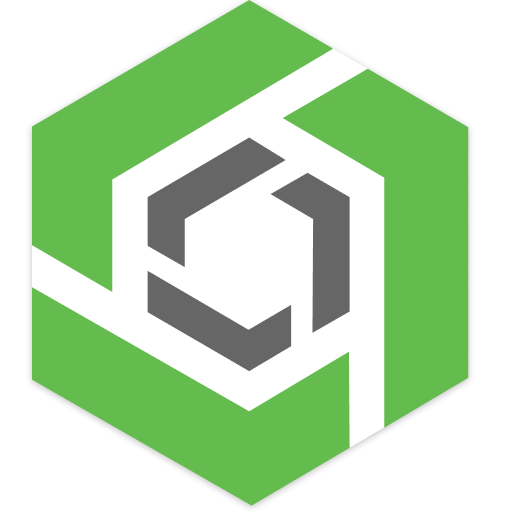
[picture p78: figure]
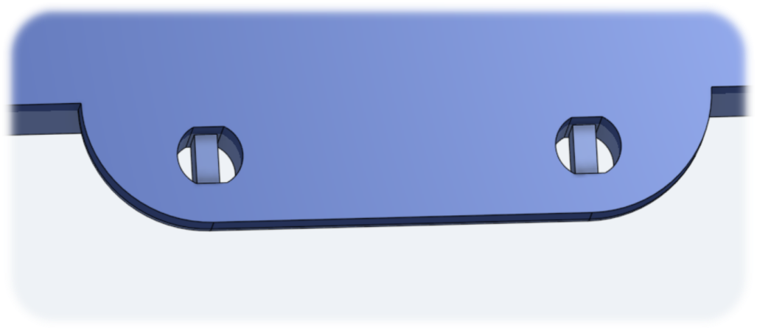
[picture p79: figure]
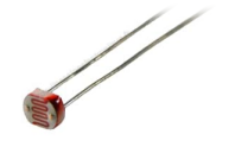
[picture p80: figure]

16

## Impressions 3D – Pièces mécaniques

VAL

Pièces imprimées :
  - Support panneau solaire et photorésistances (2 pièces clipsées)
  - Engrenage panneau solaire (collé avec le support)
  - Engrenage moteur pas à pas
  - Bac principal : logement axe (tige métal et roulements) + moteur
  - Paroi séparatrice des photorésistances (différence d’ensoleillement marquée)
  - Matériau : PETG – Résistance aux UV et intempéries

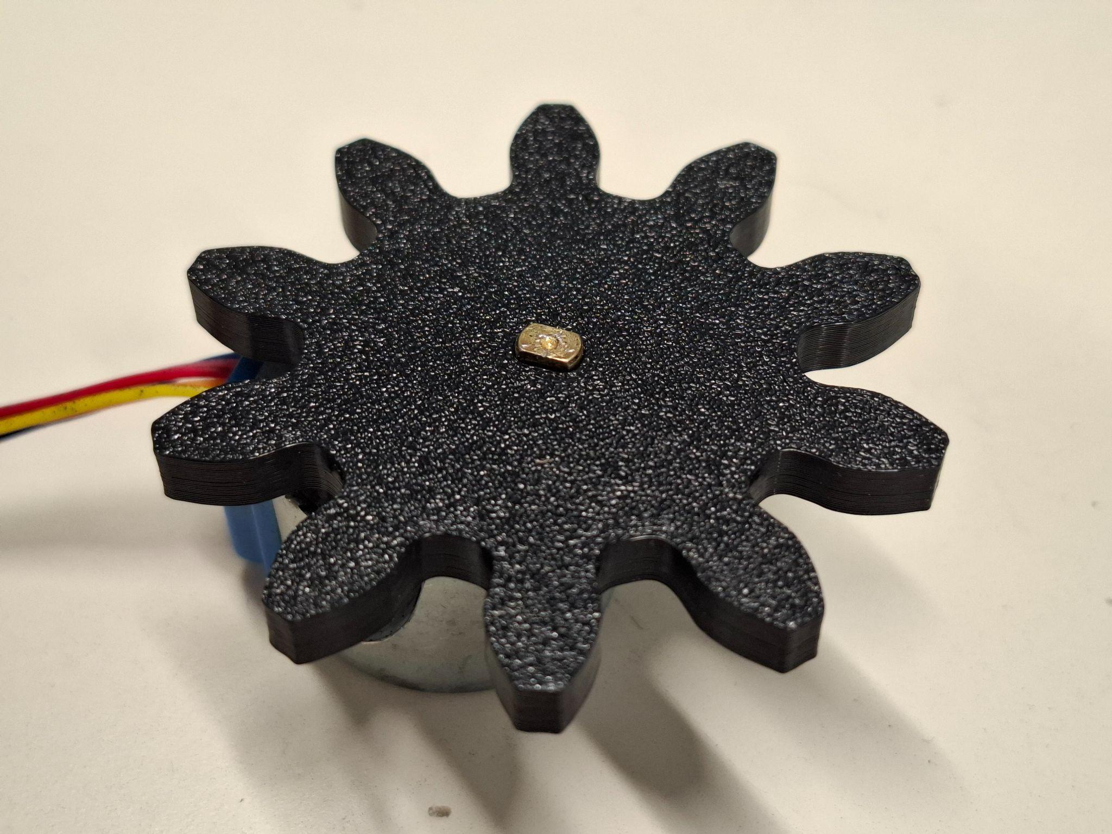
[picture p81: figure]
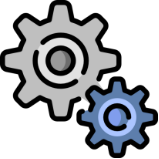
[picture p82: figure]
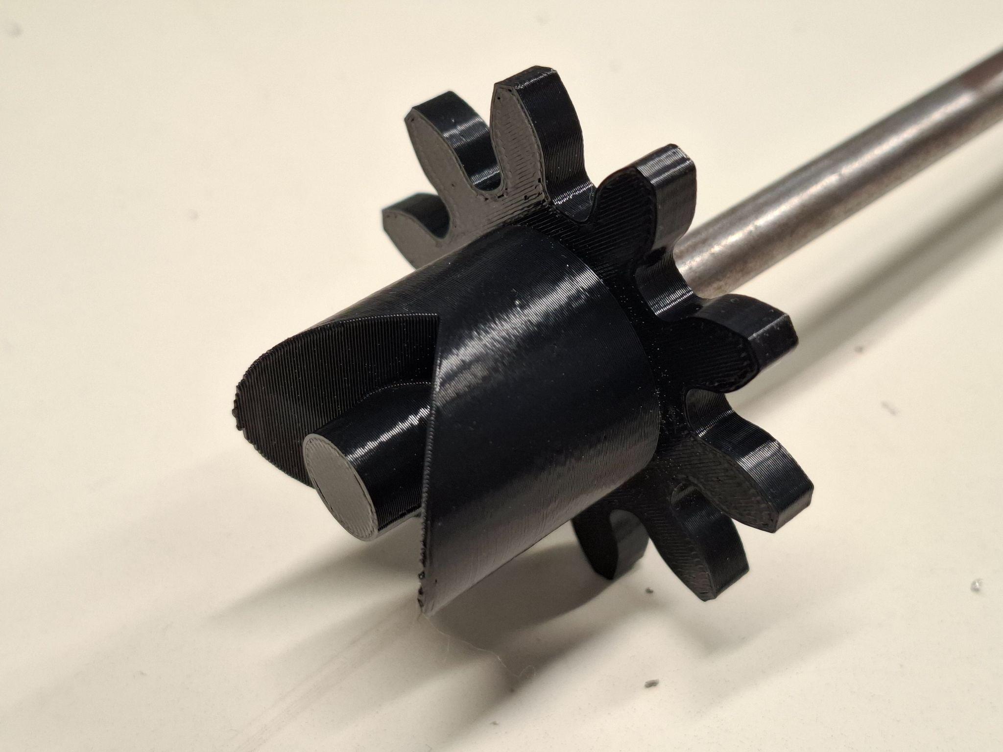
[picture p83: figure]
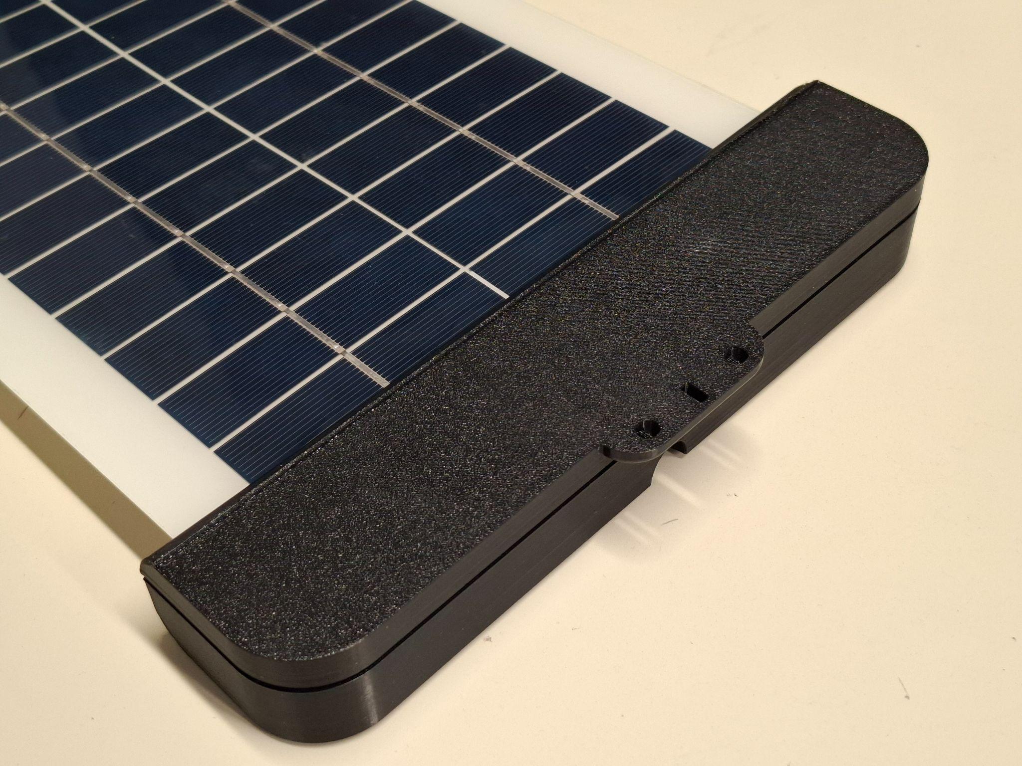
[picture p84: figure]
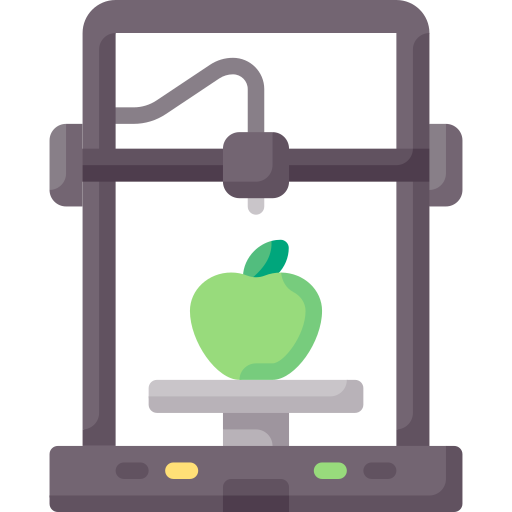
[picture p85: figure]

17

## Impressions 3D – Pièces mécaniques

VAL

Choix du design actuel :
  - Moteur ne pouvant pas supporter le poids et maintenir le panneau solaire avec son support
  - Placement du moteur sur le côté avec des engrenages pour faire tourner
  - Support du panneau solaire situé sur une tige en métal avec des roulements à billes => rotation stable et fiable

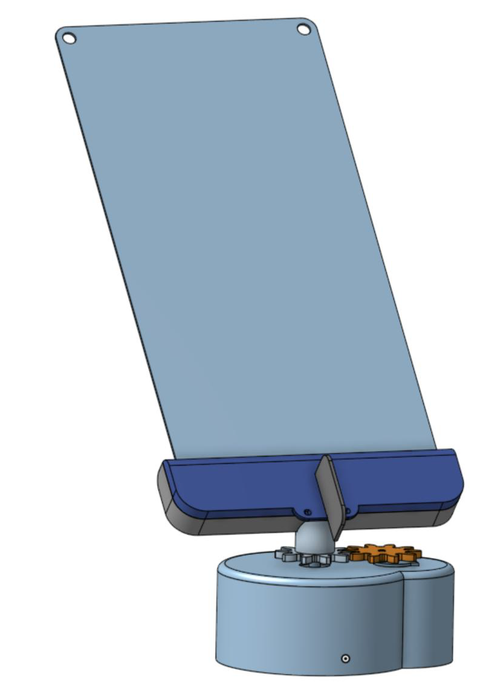
[picture p86: figure]
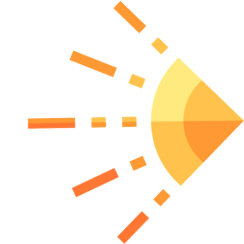
[picture p87: figure]
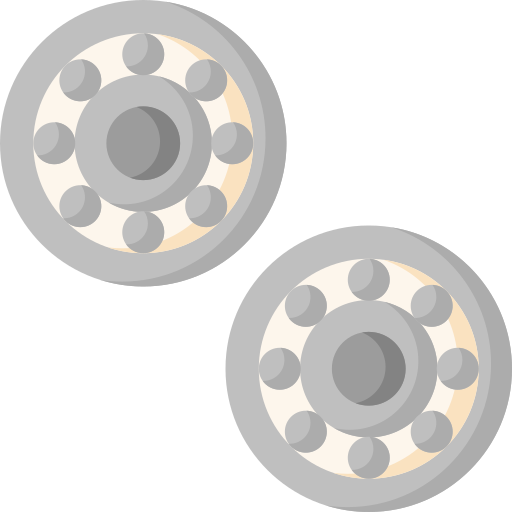
[picture p88: figure]
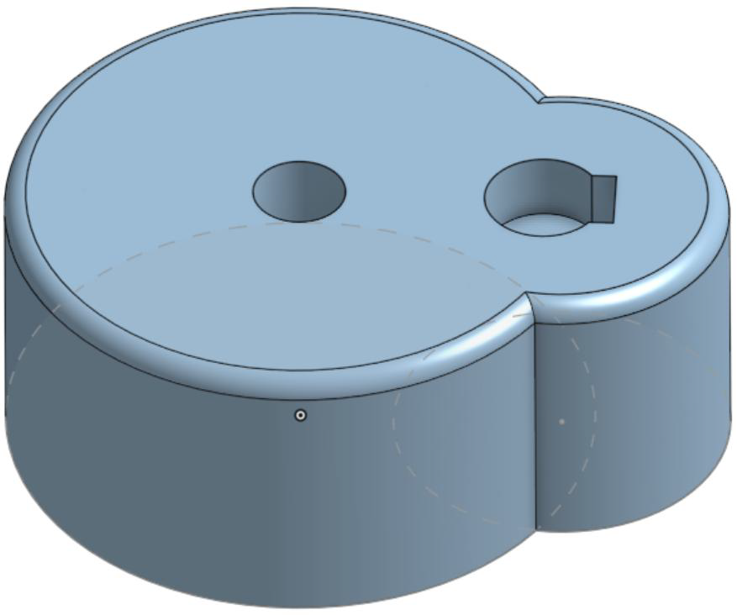
[picture p89: figure]
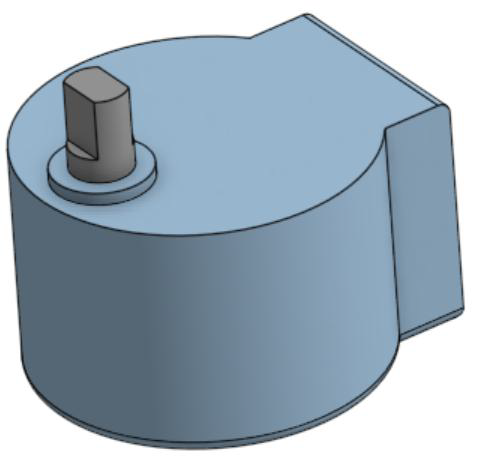
[picture p90: figure]

18

## PCB – assemblage des composants électroniques

VAL

Placement des composants sur la carte :
  - Résistances
  - Capteurs de température (végétaline)
  - Transistors PMOS
  - ESP32

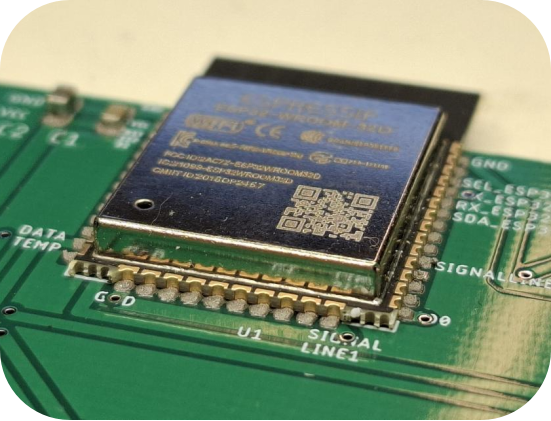
[picture p91: figure]
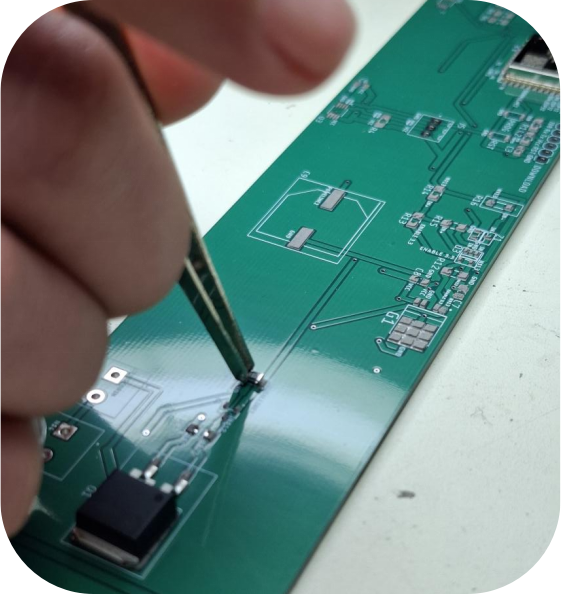
[picture p92: figure]
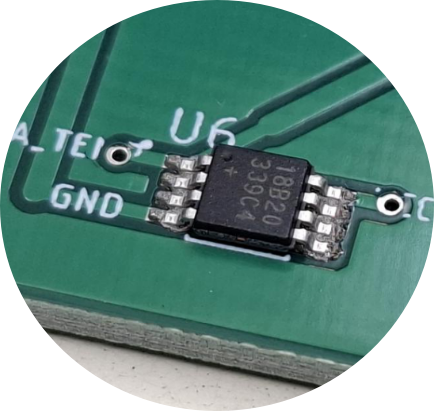
[picture p93: figure]
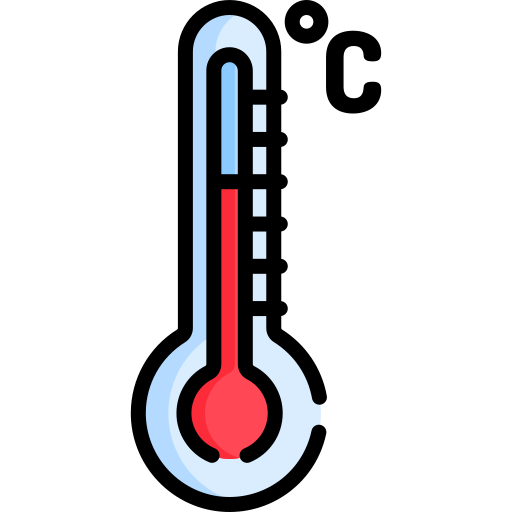
[picture p94: figure]
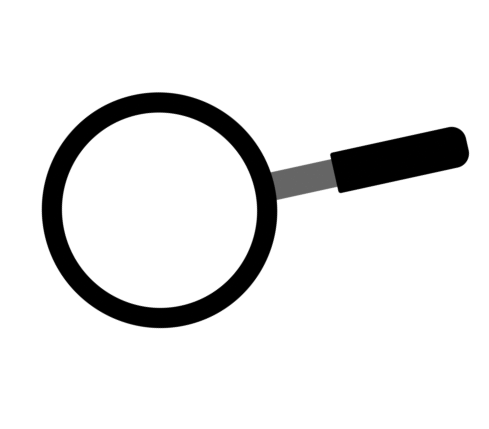
[picture p95: figure]
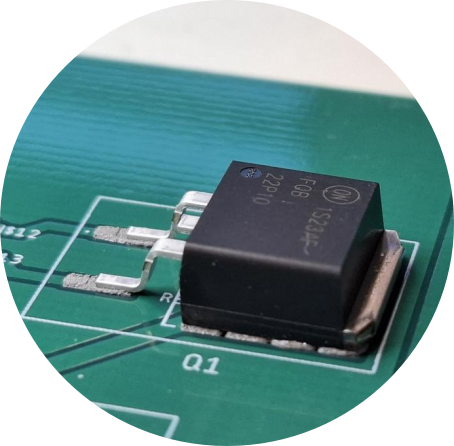
[picture p96: figure]
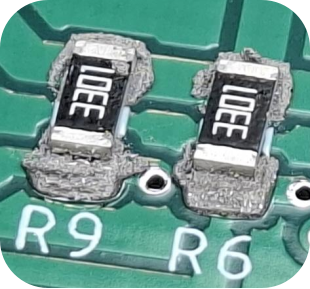
[picture p97: figure]
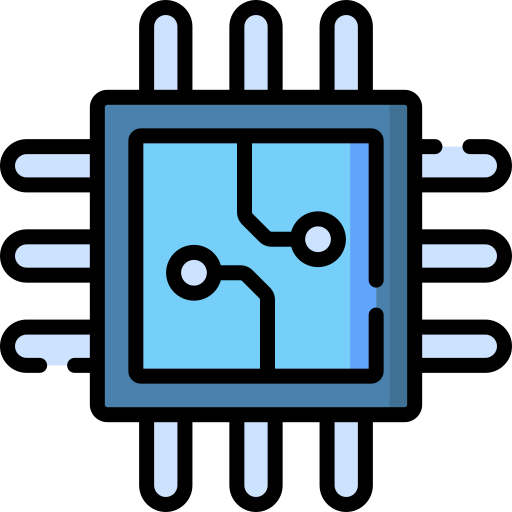
[picture p98: figure]

19

## PCB – assemblage des composants électroniques

VAL

Placement des composants sur la carte :
  - Condensateurs
  - Régulateur de tension
  - Diode Zener
  - Comparateur
  - Boutons programmation & reset
  - INA219 (mesure tension/courant)
  - Connectique du panneau solaire
  - Connectiques des résistances chauffantes

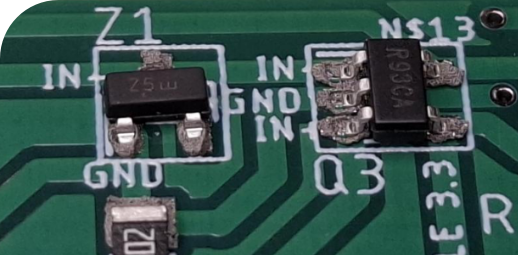
[picture p99: figure]
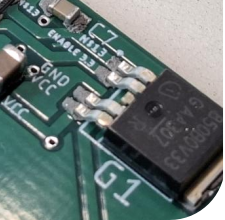
[picture p100: figure]
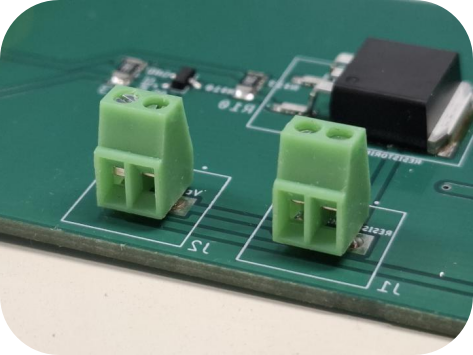
[picture p101: figure]
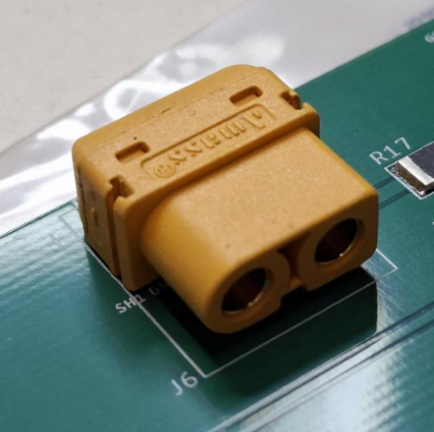
[picture p102: figure]
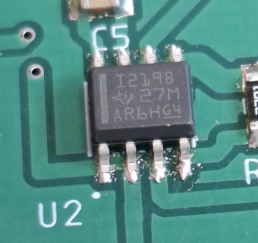
[picture p103: figure]
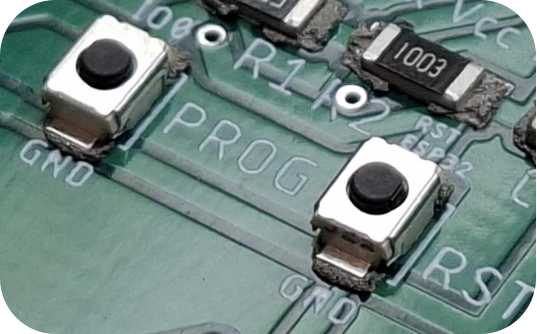
[picture p104: figure]

20

## Optimisation Énergie – MPPT

EYA

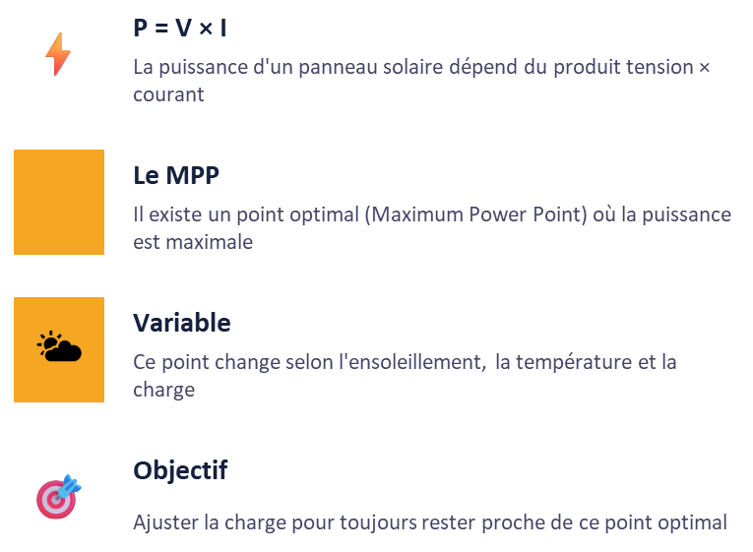
[picture p105: figure]
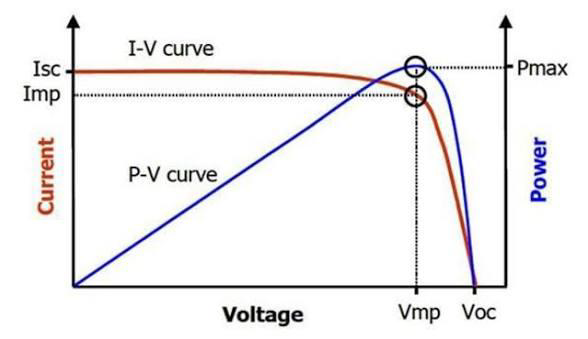
[picture p106: figure]

⚡

📈

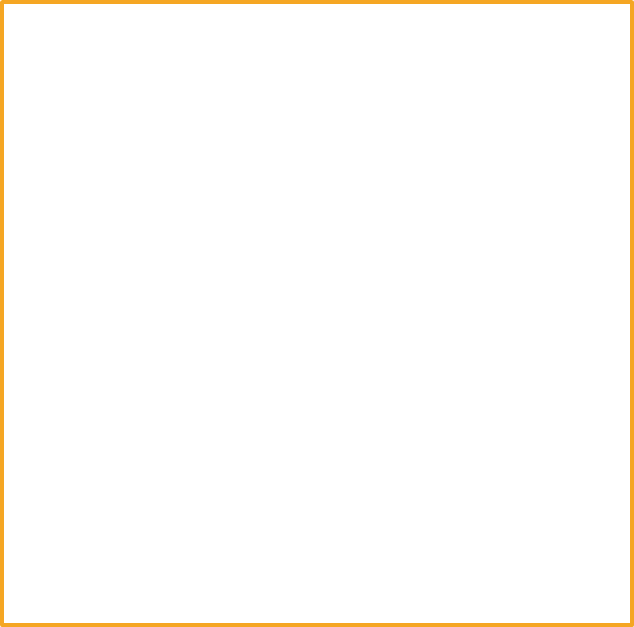
[picture p107: figure]
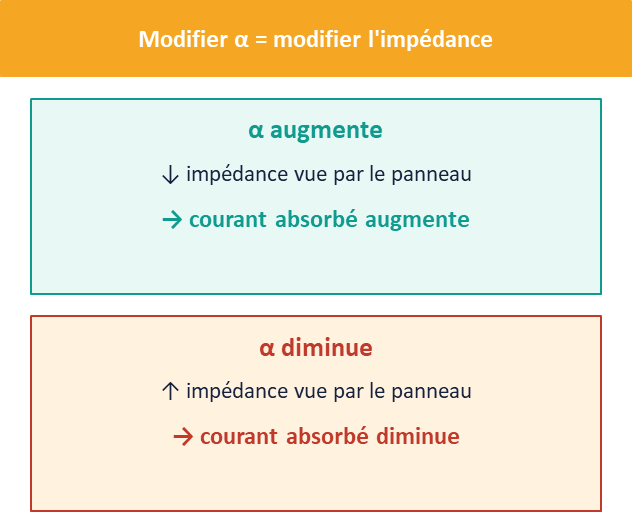
[picture p108: figure]

21

## Optimisation Énergie – MPPT

EYA

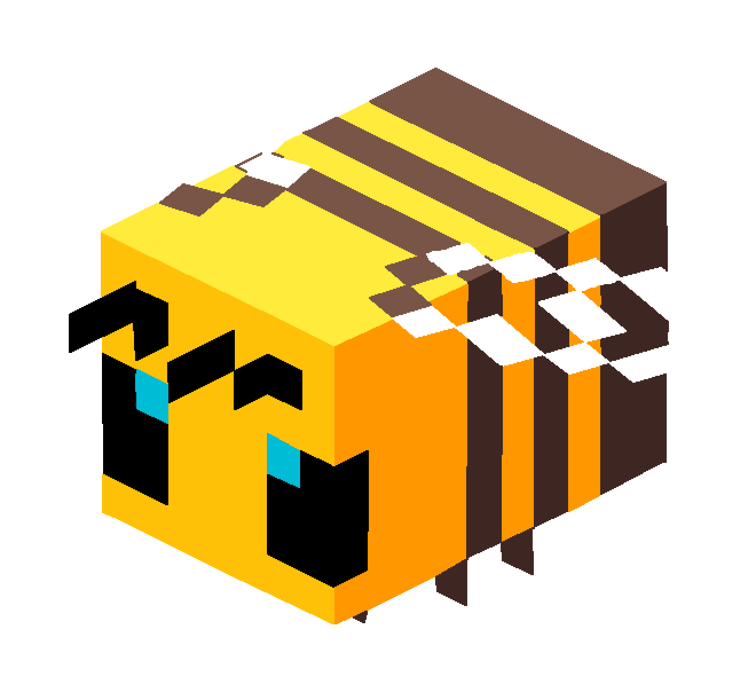
[picture p109: figure]
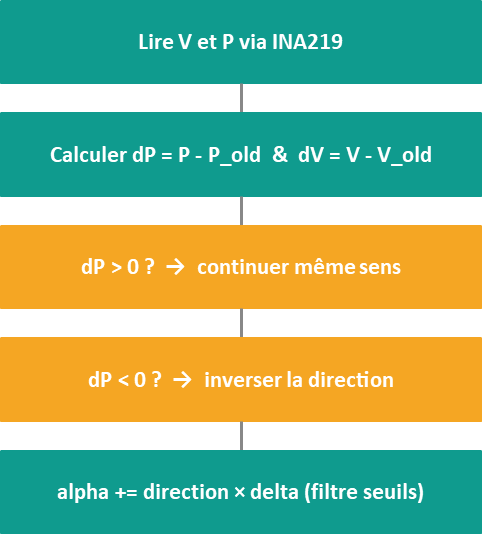
[picture p110: figure]
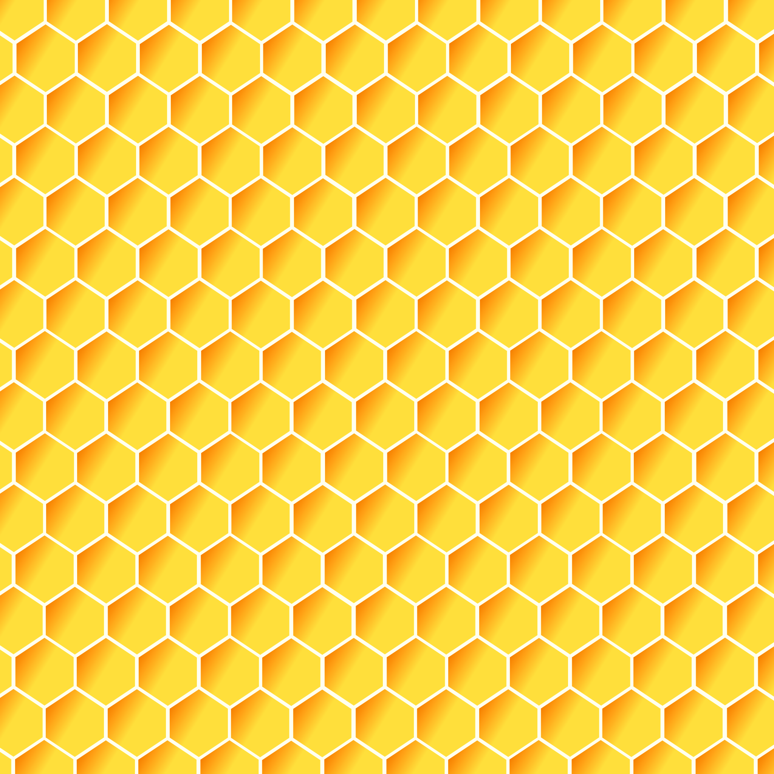
[picture p111: figure]

=> Cycle toutes les 3 secondes
=> Filtre seuils : |dP| > 50 mW ET |dV| > 10 mV
=> alpha limité entre 0.05 et 0.95 (jamais 0% ni 100%)
=> delta = 0.02 → convergence progressive et stable
=> Évite les faux mouvements dus au bruit de mesure

22

## Optimisation Énergie – MPPT

EYA

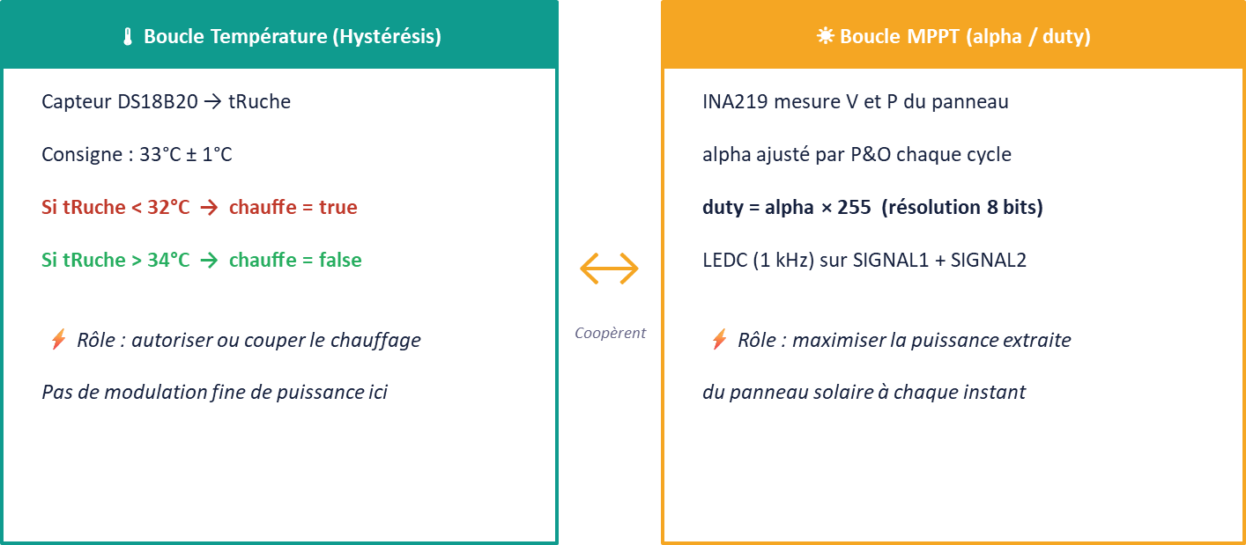
[picture p112: figure]
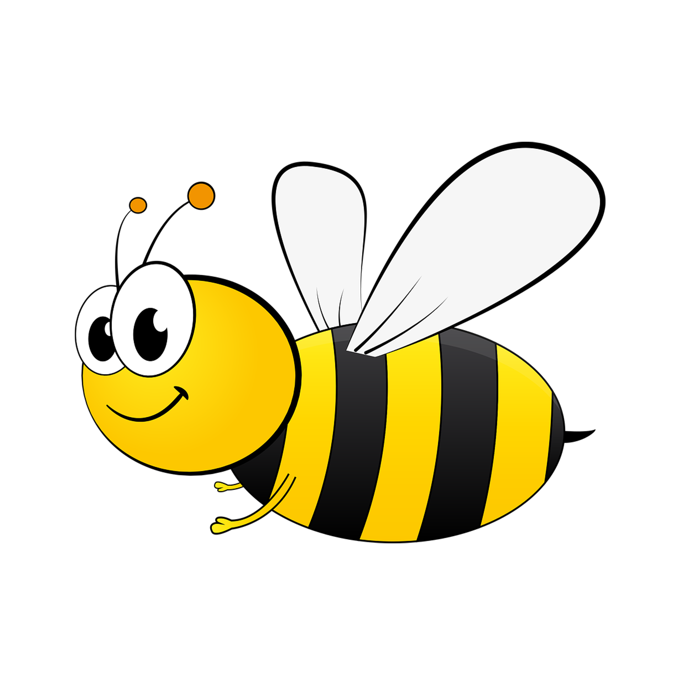
[picture p113: figure]
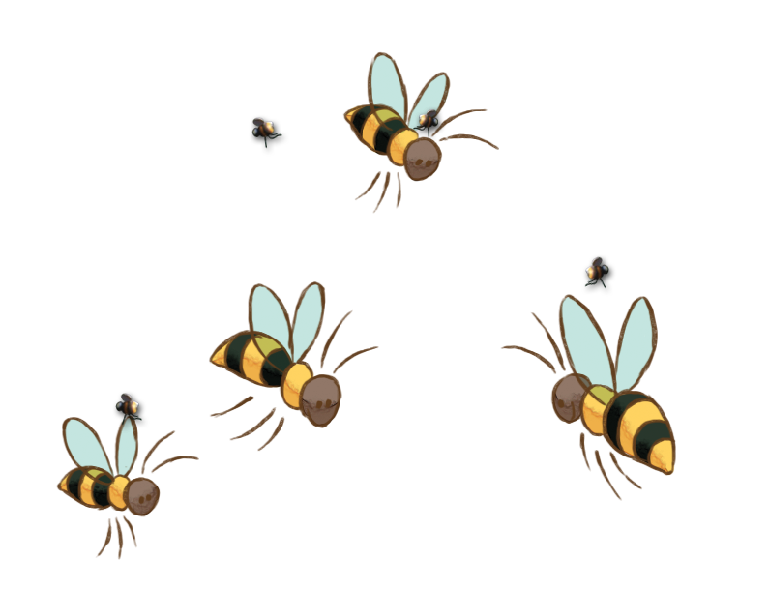
[picture p114: figure]
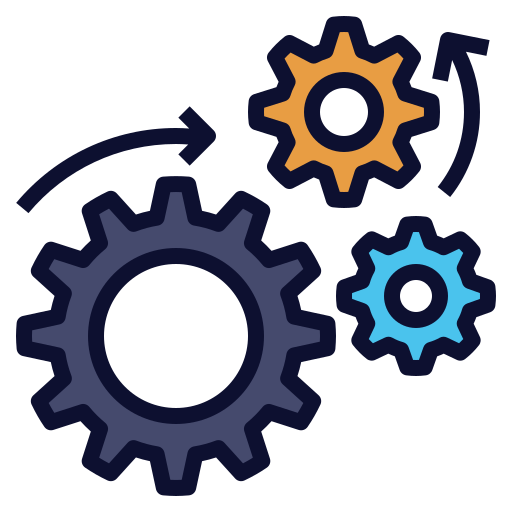
[picture p115: figure]
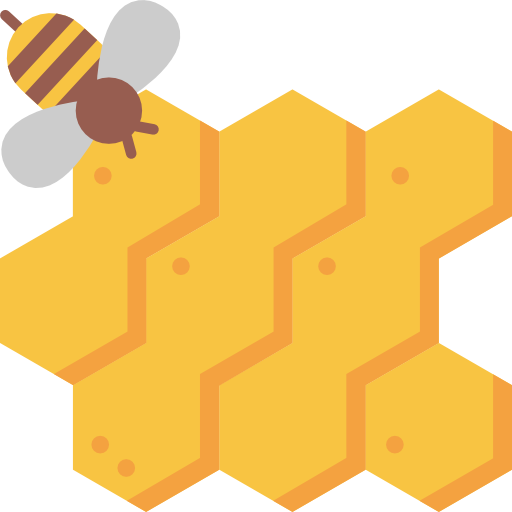
[picture p116: figure]
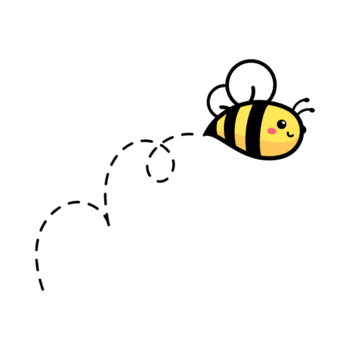
[picture p117: figure]
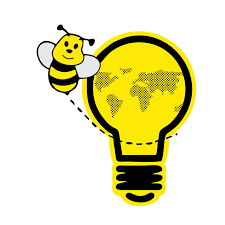
[picture p118: figure]
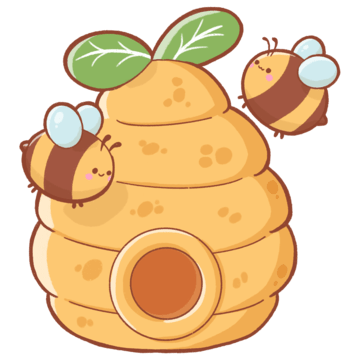
[picture p119: figure]

23

## Optimisation Énergie – MPPT

EYA

- Utilisation des fonctions LEDC (LED Controller) natives du microcontrôleur.

ledcAttach(SIGNAL1, 1000, 8); ledcWrite(SIGNAL1, duty); // duty = alpha × 255

Critère | analogWrite() | ledcWrite() ✓
Disponibilité ESP32 | Limitée / non officielle | Native et officielle
Fréquence | Fixe (non configurable) | 1 000 Hz (choisi)
Résolution | Variable selon core | 8 bits → 0..255
Canaux indépendants | Non | Oui : SIGNAL1 + SIGNAL2
Usage MPPT | Trop imprécis | Idéal

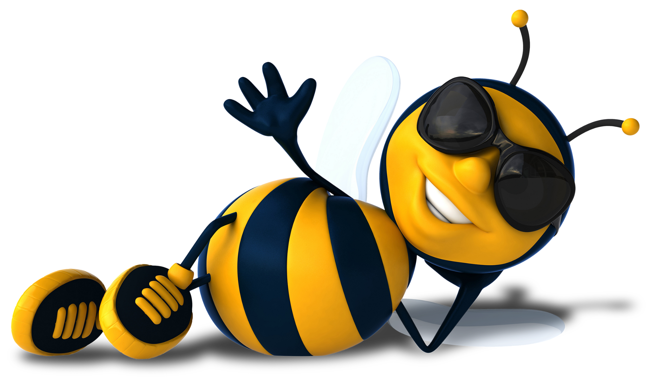
[picture p120: figure]

24

## Conclusion & Perspectives

✅ Réalisations
- Communication entre l’application et l’ESP32 => monitoring et setting opérationnels
- Suivi du soleil par le panneau solaire ok
- PCB assemblée et testée
- Structure imprimé et assemblée
🔧 Prochaines étapes
- Test chauffage + régulation température
- Tests en conditions réelles à effectuer

MERCI !

25
