eyazaoun/BeeWarm/ecoconception/rapport_masses_sources.pdf

## Rapport masses composants - projet écoconception

Tableau trié par source

Ce document reprend les composants du tableau OpenLCA et la source utilisée pour la masse associée. Les lignes sont triées par source pour faciliter la vérification.

Composant | Qté | Masse totale (g) | Source
Capteurs externes LM35 | 2 | 0.3 | Estimation interne / à confirmer
Panneau solaire | 1 | 2250 | Estimation interne / à confirmer
Photoresistor GL5506 | 2 | 1.14 | Estimation interne / à confirmer
Step motor 28BYJ-48 | 1 | 34 | Estimation interne / à confirmer
Support 3D | 1 | 165 | Estimation interne / à confirmer
ULN2003 | 1 | 12 | Estimation interne / à confirmer
Connecteur header 1x6 | 1 | 0.4 | https ://digipurk.ee/en/product/pin-single-row-1x6-2-54-mm
ESP32-WROOM-32E De-velopment Kit | 1 | 25.292 | https ://eu.mouser.com/ProductDetail/Espressif-Systems/ESP32-DevKitC-32E
Diode Zener | 1 | 0.02 | https ://eu.mouser.com/ProductDetail/onsemi/BZX84C6V8LT1G
Condensateurs céramiques CMS C0805 | 7 | 0.056 | https ://ifuturetech.org/product/0-1uf-0805-package/
| | | esp-wroom-32-esp32-wifi-bt-ble-module
Capteurs DS18B20 | 4 | 0.8 | https ://nz.mouser.com/ProductDetail/Analog-Devices-Maxim-Integrated/DS18B20%2BTR
| | | tls850b0te-v33-datasheet-en.pdf | 5-1-2_Rev004s_E2%28MSL1%29.pdf
Résistance shunt de puis-sance 2512 | 1 | 0.0405 | https ://www.mouser.co.uk/ProductDetail/Vishay-Dale/WSL2512R1000FEA
Comparateur analogique | 1 | 0.0506 | https ://www.mouser.com/ProductDetail/Diodes-Incorporated/AP331AWG-7
Boutons poussoirs tactiles | 2 | 0.044 | https ://www.mouser.com/ProductDetail/Omron-Electronics/B3U-1000P-B
Connecteurs bornier 2 voies | 4 | 38.06 | https ://www.mouser.com/ProductDetail/TE-Connectivity/1-282857-2
Connecteur bornier 3 voies | 1 | 1.012 | https ://www.mouser.com/ProductDetail/TE-Connectivity/282834-3
Capteur INA219 | 1 | 0.1 | https ://www.mouser.com/ProductDetail/Texas-Instruments/INA219AID
Condensateur électroly-tique CMS | 1 | 5.359 | https ://www.mouser.com/ProductDetail/Wurth-Elektronik/865080663020
Module ESP-WROOM-03 | 1 | 3 | https ://maldives.desertcart.com/products/49543933-
Régulateur linéaire 3,3 V | 1 | 0.3 | https ://www.infineon.com/assets/row/public/documents/10/49/infineon-
| | | https ://fscdn.rohm.com/en/techdata_basic/ic/package/Jisso_TO252-
MOSFET de puissance | 2 | 7.8998 | https ://www.mouser.com/ProductDetail/onsemi/FQB22P10TM
MOSFET petit signal | 2 | 0.016 | https ://www.mouser.com/datasheet/2/115/ds30144-
| | | 1164515.pdf
Résistances CMS 1206 | 16 | 0.1344 | https ://www.resistor.com/assets/pdf/1206std.pdf
Connecteur XT60 | 1 | 4.104 | https ://www.tme.eu/en/details/xt60pw-m/dc-power-connectors/amass/

1
