eyazaoun/BeeWarm/doc/Hussein ELSOUDA/RapportSéance16_ELSOUDA.pdf

ELSOUDA Hussein
ELSE4-FISA

## Séance du 10/04/2026

1- Introduction
L’objectif de cette séance était d’avancer sur la partie matérielle en soudant les composants restants : les connecteurs, les pins, l’INA219 et le condensateur de 1000 µF. Le but est de finaliser la carte pour pouvoir lancer les tests réels dès la séance suivante.

2- Soudure des connecteurs et de l'INA219
On a réussi à souder les connecteurs ainsi que les pins sur la carte. Pour la partie plus délicate, M. Peter nous a aidés à souder l’INA219. Nous avons également ajouté les câbles d'alimentation rouge et noir, ce qui nous permettra de tester le PCB avec une alimentation externe dans un premier temps, avant de passer aux essais avec le panneau solaire.

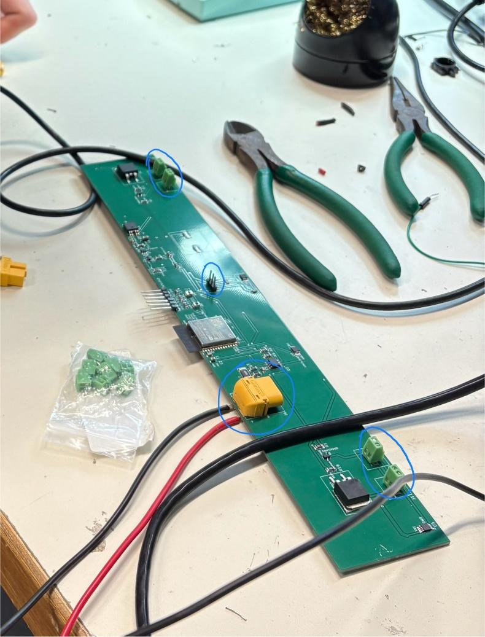
[picture p123: figure]

ELSOUDA Hussein
ELSE4-FISA

3- Conclusion :
Le PCBA est quasiment terminé. Il ne nous reste plus qu’à souder le condensateur de 1000 µF pour finaliser l'assemblage. La séance prochaine sera donc dédiée aux tests de la carte, d'abord sur alimentation externe, puis en conditions réelles avec le panneau solaire.
