eyazaoun/BeeWarm/doc/Hussein ELSOUDA/RapportSéance14_ELSOUDA.pdf

ELSOUDA Hussein
ELSE4-FISA

## Séance du 17/03/2026

1- Introduction
L'objectif de cette séance était de mieux comprendre le fonctionnement et l'intérêt des étages Push-Pull. En parallèle, on a pu vérifier le design de la PCB réalisé par mon collègue avant que l'enseignant ne lance la fabrication.

2- Montage Push-Pull CMOS
Le montage utilise deux transistors : un PMOS en haut (relié à l'alimentation) et un NMOS en bas (relié à la masse).
« Push » : Quand l'entrée est à l'état bas ('0'), le transistor PMOS devient passant et pousse la sortie vers le haut (VDD).
« Pull » : Quand l'entrée est à l'état haut ('1'), le transistor NMOS devient passant et tire la sortie vers le bas (masse).

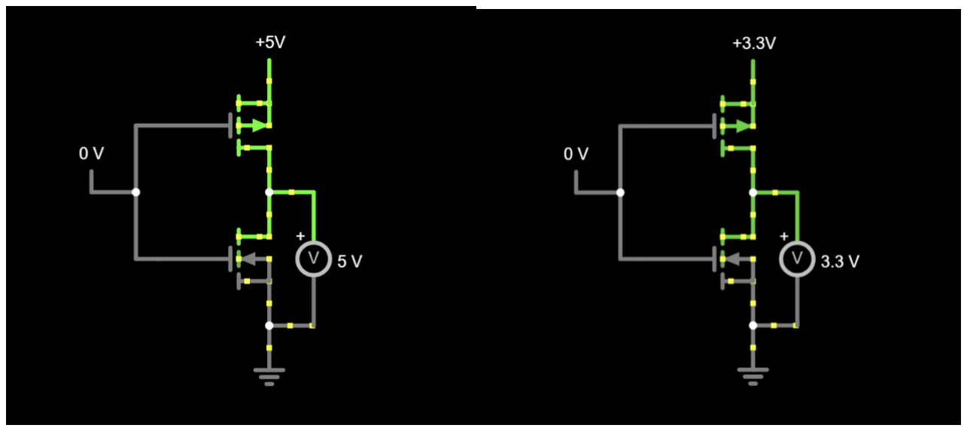
[picture p128: figure]

Intérêts du montage:
Adaptation de tension : C'est très utile pour faire communiquer des composants qui n'ont pas les mêmes plages de tension. Par exemple, un capteur qui sort du 5V ne peut pas être branché directement sur un microcontrôleur limité à 3.3V sous peine de le détruire. En alimentant l'étage Push-Pull en 3.3V, on convertit le signal proprement avec une commutation rapide.

Impédance d'entrée : Le montage a une impédance d'entrée infinie. Cela signifie qu'il ne tire pas de courant sur la source de tension, ce qui est parfait pour ne pas perturber des capteurs sensibles.
Comparaison avec le Drain Ouvert : Contrairement au montage à drain ouvert, le Push-Pull pilote activement l'état haut. Le drain ouvert a besoin d'une résistance de pull-up qui est souvent lente et consomme de l'énergie, alors que le Push-Pull offre une faible impédance de sortie. Ce type de montage se retrouve aussi bien sur PCB que directement dans les circuits intégrés.

3- Vérification de la PCB :
La deuxième partie de la séance a servi à vérifier le travail fait sur le logiciel Autodesk Eagle par mon collègue. Voici donc le schéma fait par mon collègue sur lequel on a travailler :

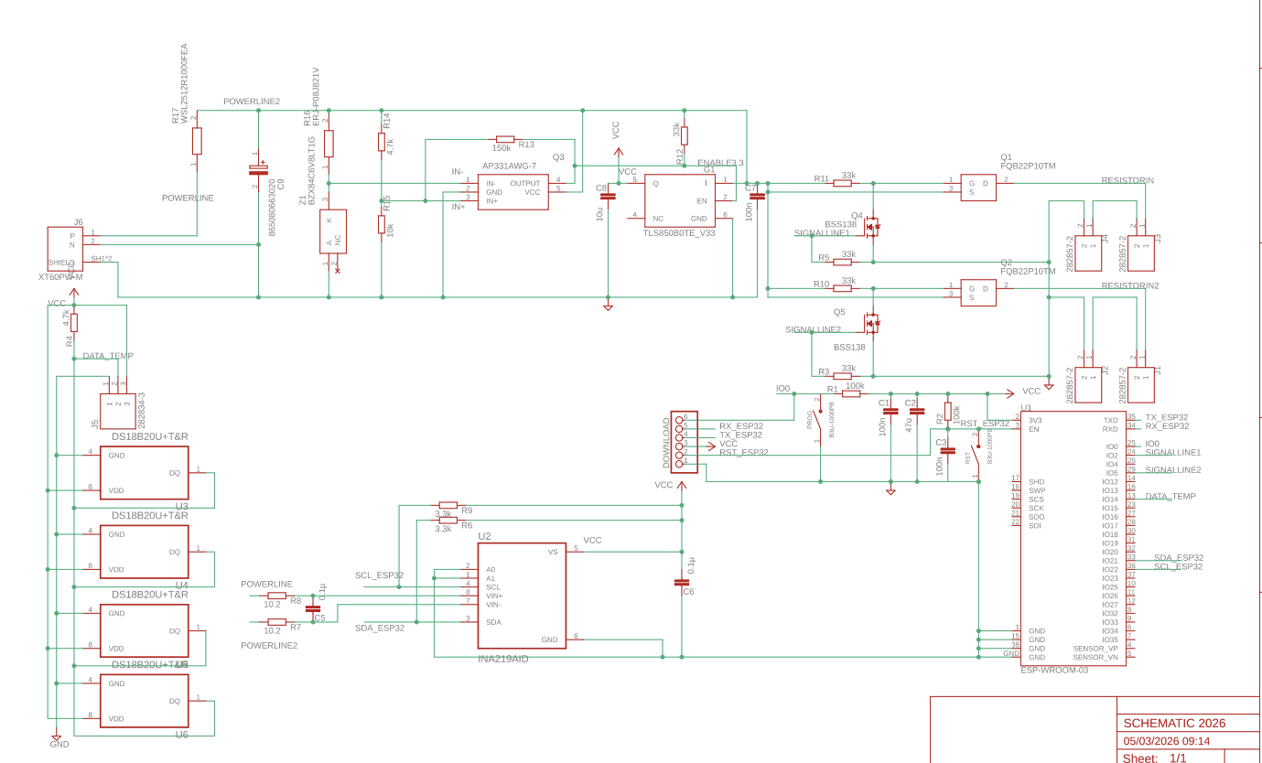
[picture p129: figure]

4- Conclusion :
Cette séance a permis de valider le fonctionnement des structures Push-Pull. Après la validation de l'enseignant, la PCB a été commandée. La prochaine étape sera de souder les composants et de passer aux tests fonctionnels dès qu'on aura la PCBA.
