eyazaoun/BeeWarm/doc/Eya ZAOUN/Séance3/Rapport_Séance_3.pdf

Eya ZAOUN – ELSE 4 FISA | Projet Electronique – Christian PETER

## Séance 3 : Chauffage d’appoint pour les abeilles

| « BeeWarm »

Introduction :
Pendant cette séance, l’objectif était de mettre en service la PCB du système de chauffage et de la rendre autonome, sans dépendre du port USB du PC. J’ai d’abord configuré la communication entre l’ESP32 et le PC en installant le driver FTDI232, puis écrit un programme de test Bluetooth pour envoyer des températures simulées vers l’application. Ensuite, nous avons travaillé sur l’alimentation externe en soudant de nouveaux fils. Enfin, nous avons alimenté le système et vérifié la bonne transmission des données.
1) Mise en place de la communication Bluetooth :
La première étape que j’ai réalisée a été l’installation du driver FTDI. Ce driver est essentiel pour assurer la communication entre l’ordinateur et le module ESP32 via le port USB. Une fois le driver correctement installé, j’ai pu établir une liaison série stable avec le microcontrôleur.
Pour vérifier que l’ESP32 répond bien, j’ai écrit un code de test qui envoie régulièrement des données simulant les températures dans la ruche et dans le corps de chauffe.

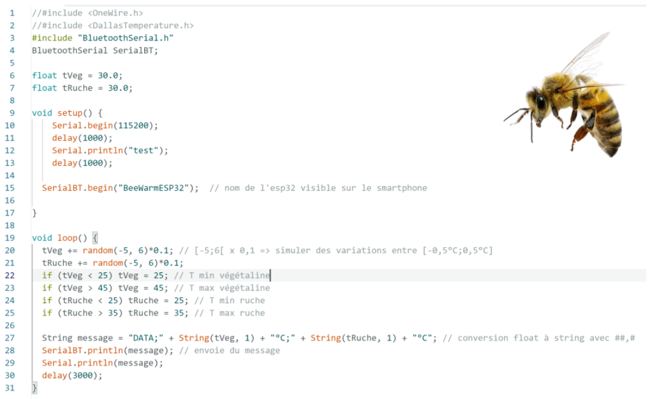
[picture p143: figure]

2) Modification de l’alimentation du circuit :
La prise normalement prévue sur la carte pour l’alimentation par panneau solaire devait initialement servir à brancher la source à une tension entre 0V et 25V.
Dans un premier temps, le système était alimenté uniquement par le port USB, ce qui n’est pas tout le temps adapté à une utilisation sur le terrain.
Et donc pour autonomiser l’alimentation du circuit, on a soudé deux fils directement sur la PCB, l’un pour l’alimentation et l’autre pour la masse. J’ai ensuite ajouté des connecteurs Wago. Et finalement, pour protéger l’ensemble, j’ai utilisé de la gaine thermorétractable, ce qui assure l’isolation thermique et électrique des contacts.

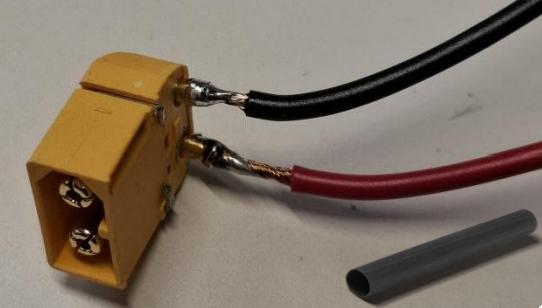
[picture p144: figure]

3) Programme de validation du fonctionnement global de l’ESP32 (à vérifier) :

J’ai écrit un programme de test permettant de simuler le comportement du système avant l’intégration des capteurs réels :

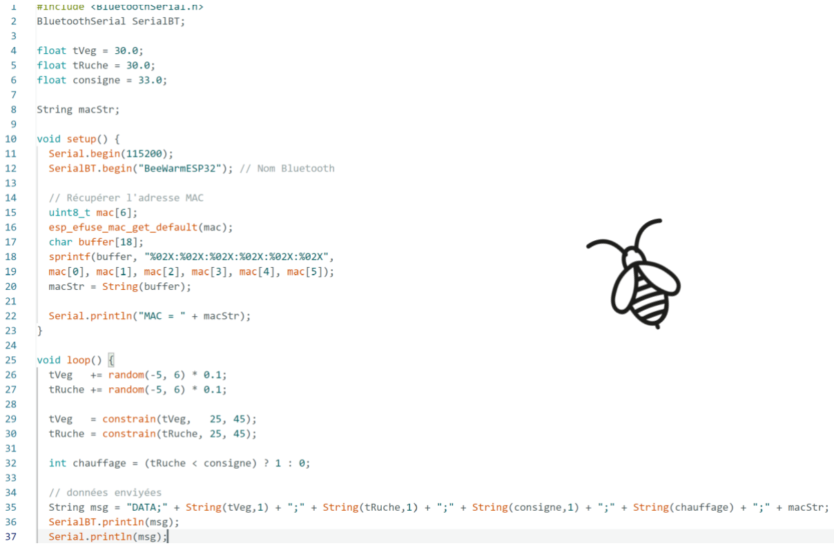
[picture p145: figure]
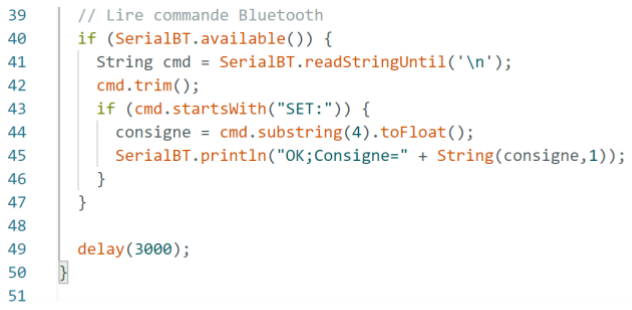
[picture p146: figure]

Ici, ce code sert principalement de version de test. Il simule deux températures : celle de la ruche et celle de l’élément chauffant, en leur faisant subir de petites variations pour imiter un fonctionnement réel. L’ESP32 active le Bluetooth et envoie régulièrement ces valeurs vers l’application, sous la forme d’un message simple à interpréter. L’adresse MAC du module est également transmise, ce qui facilite son identification lors du couplage.
Une commande envoyée depuis l’application permet aussi de modifier la température de consigne, ce qui prépare déjà le contrôle du chauffage dans la version finale.

Conclusion :

Cette séance a permis de rendre le système autonome et communicant : l’ESP32 est maintenant alimenté en tension réglable, fonctionne en Bluetooth et envoie correctement les données vers l’application. Les bases matérielles et logicielles sont donc en place.

La suite consistera à remplacer les valeurs simulées par de vrais capteurs et à intégrer le chauffage réel pour tester le système directement en conditions de ruche.
