eyazaoun/BeeWarm/doc/Valentin GIROD ROUX/11_ValentinGIROD-ROUX.pdf

## RAPPORT DE SÉANCE 11 :

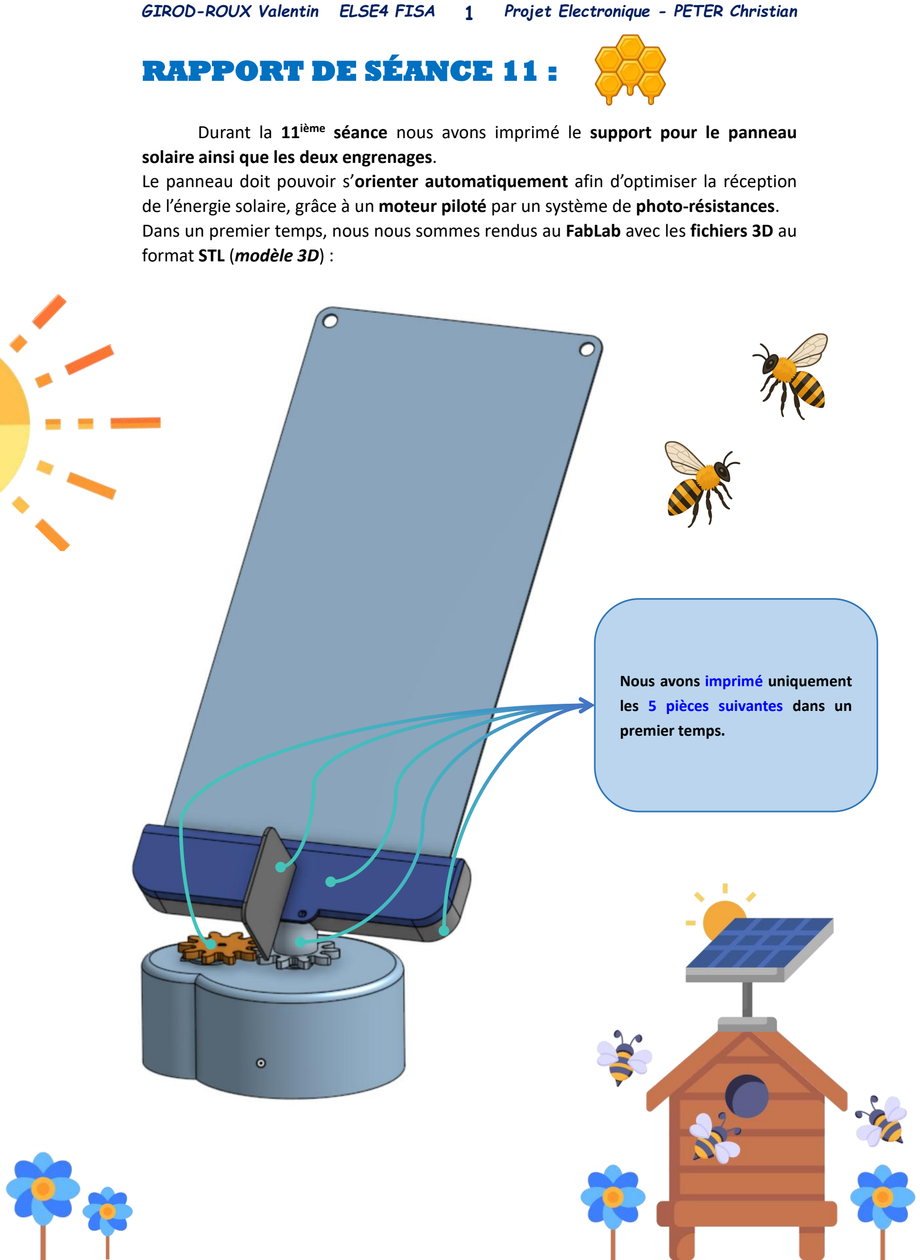
[picture p163: page 1]

GIROD-ROUX Valentin ELSE4 FISA 1 Projet Electronique - PETER Christian

Durant la 11

ième séance nous avons imprimé le support pour le panneau solaire ainsi que les deux engrenages. Le panneau doit pouvoir s’orienter automatiquement afin d’optimiser la réception

de l’énergie solaire, grâce à un moteur piloté par un système de photo-résistances. Dans un premier temps, nous nous sommes rendus au FabLab avec les fichiers 3D au

format STL (modèle 3D) :

Nous avons imprimé uniquement les 5 pièces suivantes dans un premier temps.

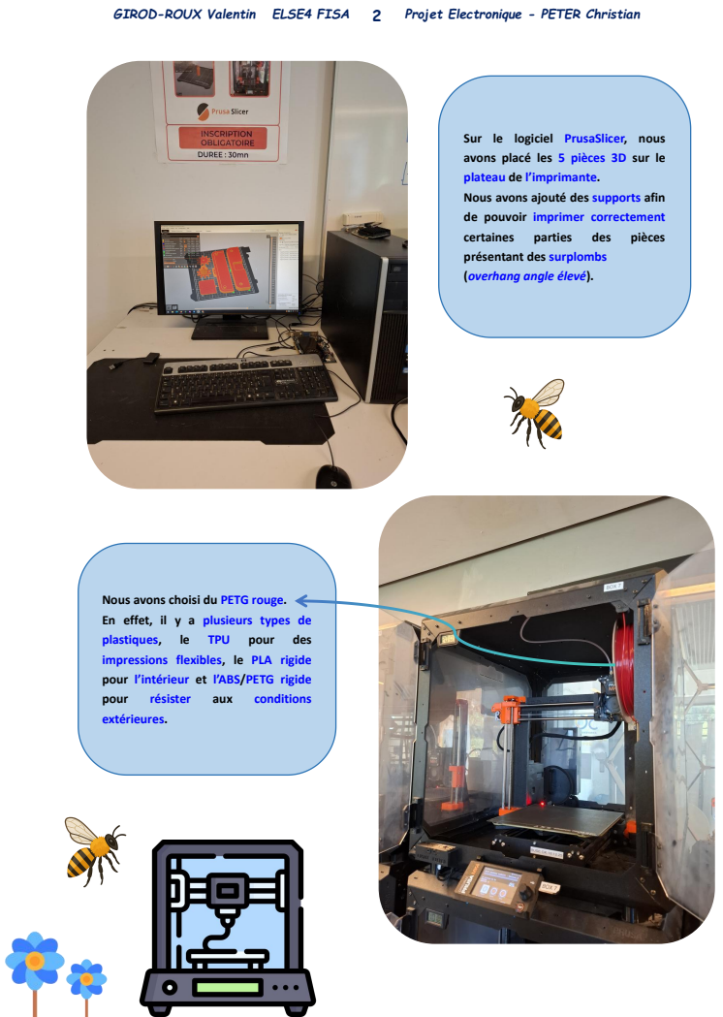
[picture p164: page 2]
GIROD-ROUX Valentin ELSE4 FISA; 2 Projet Electronique - PETER Christian

Sur le logiciel PrusaSlicer, nous
avons placé les 5 pièces 3D sur le
plateau de l’imprimante. Nous avons ajouté des supports afin

de pouvoir imprimer correctement
certaines parties des pièces
présentant des surplombs
(overhang angle élevé).

Nous avons choisi du PETG rouge. En effet, il y a plusieurs types de

plastiques, le TPU pour des
impressions flexibles, le PLA rigide
pour l’intérieur et l’ABS/PETG rigide
pour résister aux conditions
extérieures.

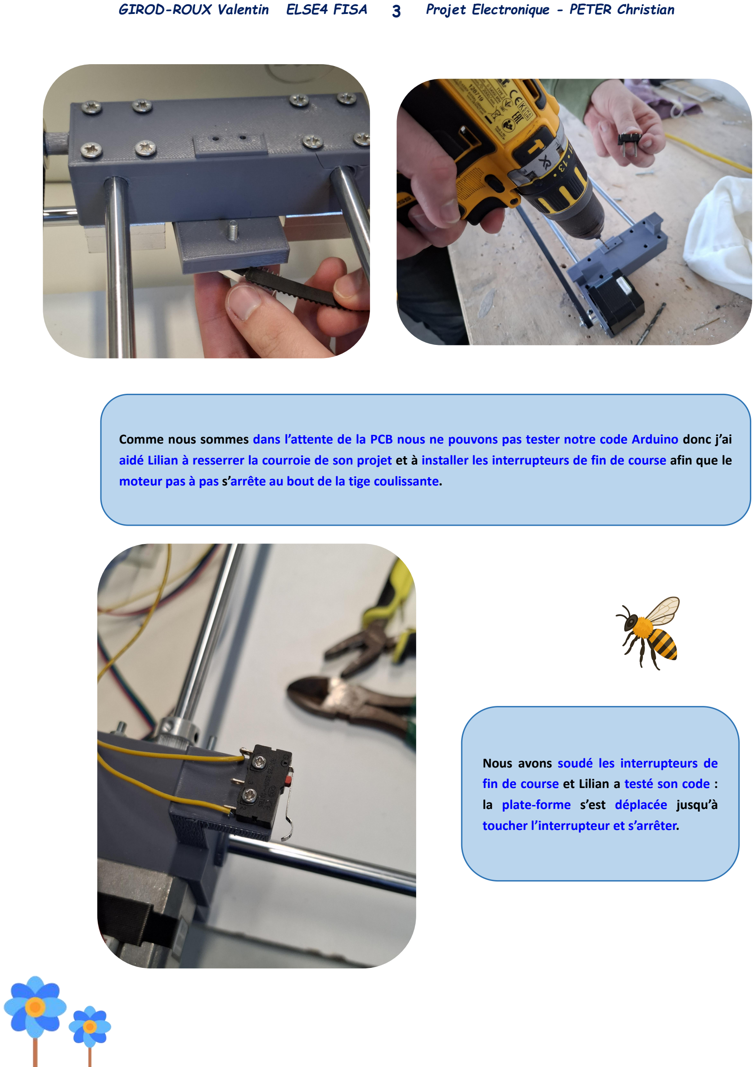
[picture p165: page 3]

GIROD-ROUX Valentin ELSE4 FISA 3 Projet Electronique - PETER Christian

Comme nous sommes dans l’attente de la PCB nous ne pouvons pas tester notre code Arduino donc j’ai aidé Lilian à resserrer la courroie de son projet et à installer les interrupteurs de fin de course afin que le moteur pas à pas s’arrête au bout de la tige coulissante.

Nous avons soudé les interrupteurs de fin de course et Lilian a testé son code : la plate-forme s’est déplacée jusqu’à toucher l’interrupteur et s’arrêter.
