eyazaoun/BeeWarm/doc/Eya ZAOUN/Séances5+6/Séances_5_et_6.pdf

Eya ZAOUN – ELSE 4 FISA | Projet Electronique – Christian PETER

## Séances 5 et 6 : Chauffage d’appoint pour les abeilles

| « BeeWarm »

Introduction :
La 5

ème et 6ème séances avaient pour objectif de remplacer les valeurs de température simulées par des mesures réelles issues des capteurs installés sur la carte électronique. Après avoir validé lors des séances précédentes la communication Bluetooth entre l’ESP32 et l’application mobile à l’aide de données fictives, il était nécessaire de mettre en œuvre la lecture effective des capteurs de température afin de rendre le système pleinement fonctionnel, ainsi que de pouvoir travailler véritablement avec la consigne modifiée.

## 1) Mise en place des capteurs de température :

La PCB intègre 4 capteurs de température DS18B20, dédiés à la mesure de la température de la végétaline, ainsi qu’un 5ème capteur spécifiquement destiné à la mesure de la température au cœur de la ruche.
Les capteurs de végétaline sont connectés entre eux sur un bus OneWire commun, ce qui leur permet de partager une ligne de données tout en conservant chacun une adresse propre. Cette ligne est reliée à l’ESP32 via la broche GPIO 14, avec une alimentation VCC en 3,3 V et une masse GND commune. Pour les tests, la carte est alimentée en 12 V, une alimentation solaire étant prévue par la suite.
Le capteur de température de la ruche est quant à lui
déporté à l’extérieur de la PCB afin de pouvoir être
placé directement dans l’environnement interne de la
ruche. Il est connecté via un connecteur à trois broches comprenant l’alimentation VCC, la ligne de données OneWire et la masse GND. L’identification des broches a été facilitée par la présence de la résistance de tirage de 4,7 kΩ caractéristique du bus OneWire.

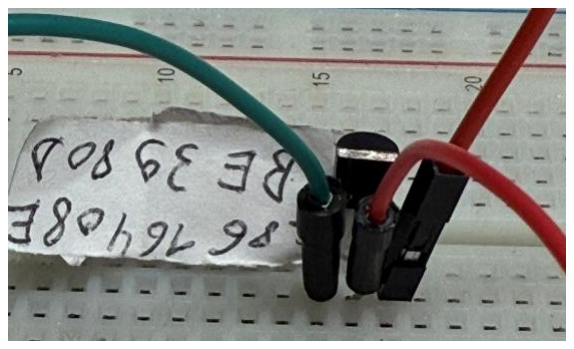
[picture p240: figure]

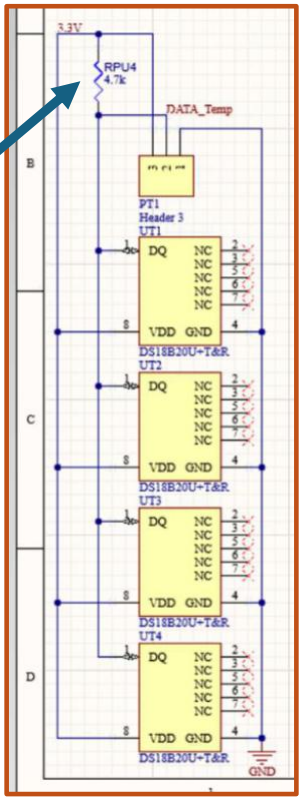
[picture p241: figure]
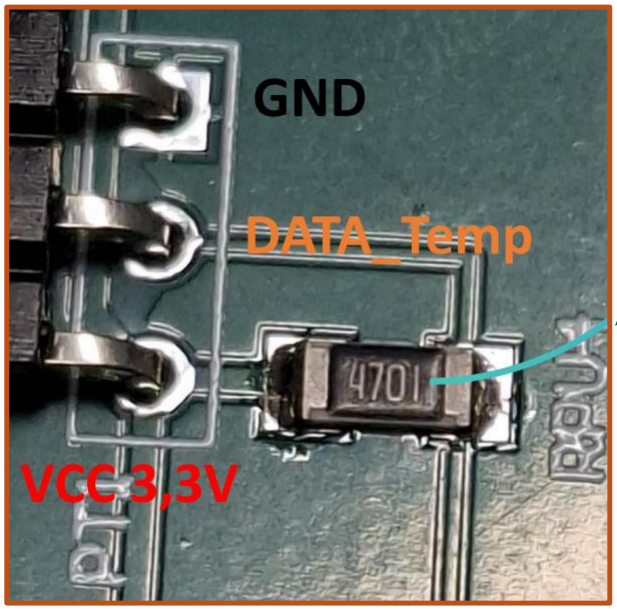
[picture p242: figure]

Le protocole OneWire permet à chaque capteur DS18B20 de disposer d’une adresse unique codée sur 8 octets. Et donc, lors du démarrage de l’ESP32, l’ensemble des capteurs présents sur le bus est automatiquement détecté.

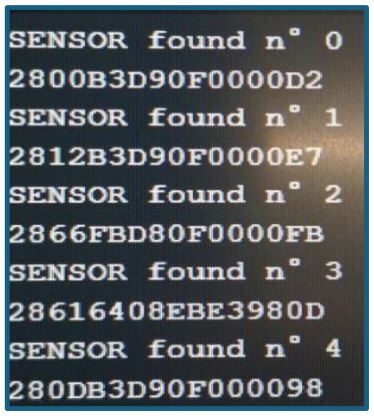
[picture p243: figure]

## 2) Adaptation du code Arduino :

Les bibliothèques OneWire et DallasTemperature ont été utilisées pour assurer la communication avec les capteurs DS18B20.
Tout d’abord, le programme commence par inclure toutes les bibliothèques nécessaires :
- OneWire et DallasTemperature : communication avec les sondes de température DS18B20 (bus OneWire).
- Wire : gestion du bus I2C, utilisé notamment pour le capteur de courant/tension de la ruche.
- BluetoothSerial : permet de créer un port série Bluetooth pour échanger des données avec l’application dans le smartphone.

- Adafruit_INA219 : bibliothèque dédiée au capteur de puissance INA219. L’objet SerialBT représente la liaison série Bluetooth de l’ESP32.

Ensuite, on définit des constantes matérielles et variables globales :
- ONE_WIRE_BUS : broche utilisée par les capteurs DS18B20 (ligne DATA du bus OneWire).
- TEMP_SENSOR_PIN : alias pour clarifier le rôle de la broche.
- tempDeviceAddress : tableau qui sert à stocker l’adresse d’un capteur détecté sur le bus.
- tVeg et tRuche : températures mesurées pour la végétaline et la ruche.
- temperatureConsigne : température cible pour le chauffage de la ruche (modifiable par Bluetooth).
- oneWire et sensors : objets qui encapsulent la communication avec les DS18B20.
- numberOfDevices : nombre total de capteurs de température présents sur le bus.
- numberOfCapteurRuche : nombre de capteurs dédiés à la ruche (ici 1).
- ina219 : objet représentant le capteur de courant/tension INA219.
- SIGNAL1 et SIGNAL2 : broches qui pilotent les résistances de chauffage via PWM.
- SDA_PIN et SCL_PIN : broches I²C pour le capteur INA219.
- capteurRuche : adresse unique (8 octets) du capteur placé dans la ruche. Elle permet de le distinguer des capteurs de végétaline.

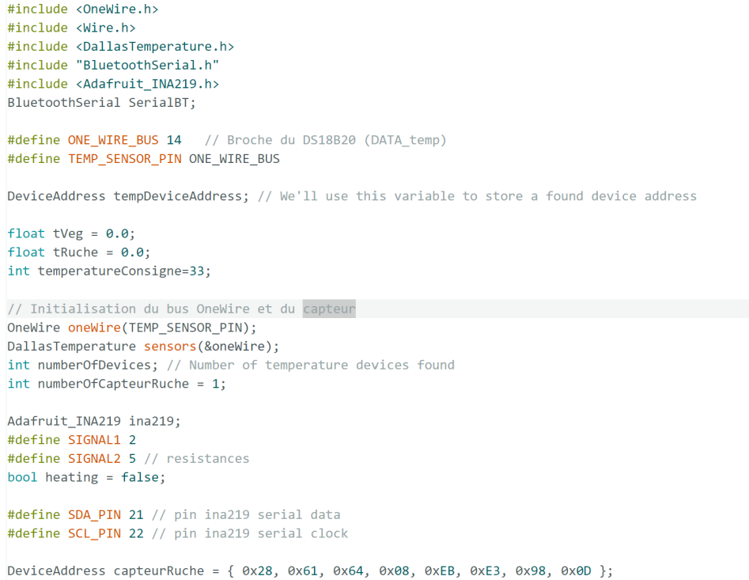
[picture p244: figure]

Lors de l’initialisation (fonction setup()), on démarre les communications série (Serial.begin(115200)) et Bluetooth (SerialBT.begin("BeeWarmESP32")) afin de permettre le débogage et les échanges avec l’application mobile. Les capteurs de température DS18B20 sont ensuite initialisés à l’aide des bibliothèques OneWire et DallasTemperature (sensors.begin()), puis le nombre de capteurs est détecté avec getDeviceCount().

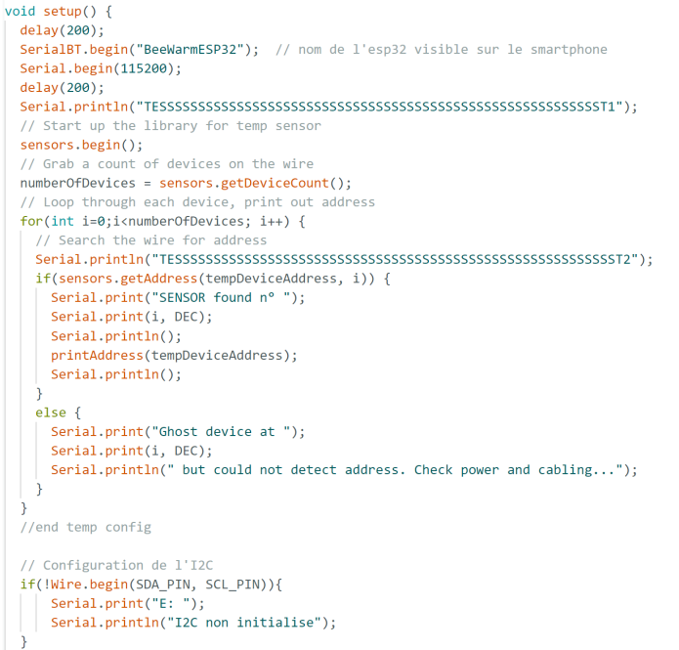
[picture p245: figure]

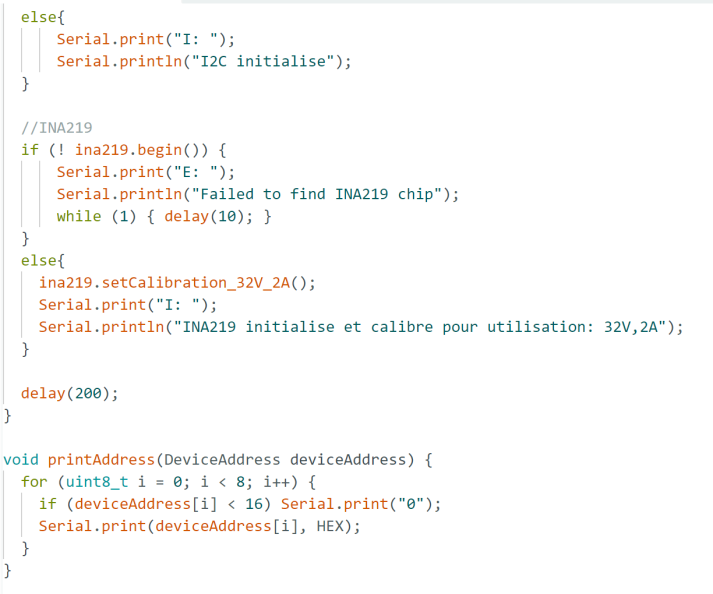
[picture p246: figure]

Chaque capteur est parcouru afin d’afficher son DeviceAddress, ce qui permet d’identifier le capteur spécifique de la ruche (capteurRuche). Enfin, le bus I²C est configuré via Wire.begin(SDA_PIN, SCL_PIN) et le capteur de puissance INA219 est initialisé et calibré (ina219.begin(), setCalibration_32V_2A()), garantissant des mesures fiables de courant et de puissance.

La fonction loop() regroupe, quant à elle, les tâches principales exécutées en continu. Elle commence par la réception d’une consigne de température via SerialBT.available(), permettant de modifier la variable temperatureConsigne à distance.
Elle est extraite du message sous la forme SET:SP=XX, la valeur numérique étant isolée après le caractère = puis convertie en entier. Cette nouvelle consigne est
immédiatement prise en compte par l’algorithme de régulation thermique, permettant un ajustement rapide et flexible du comportement du système
Les températures sont ensuite acquises avec sensors.requestTemperatures(). Grâce à la comparaison des adresses (memcmp()), la température du capteur de la ruche est stockée dans tRuche, tandis que les mesures des autres capteurs sont moyennées pour obtenir tVeg. Ces données sont ensuite envoyées au smartphone sous forme de message Bluetooth (SerialBT.println()).
Enfin, la puissance disponible est mesurée par le capteur INA219 (getPower_mW()), puis les résistances de chauffage sont pilotées en PWM via analogWrite(SIGNAL1, SIGNAL2) en fonction de l’écart entre tRuche et temperatureConsigne. Une temporisation (delay(3000)) stabilise le cycle de fonctionnement.

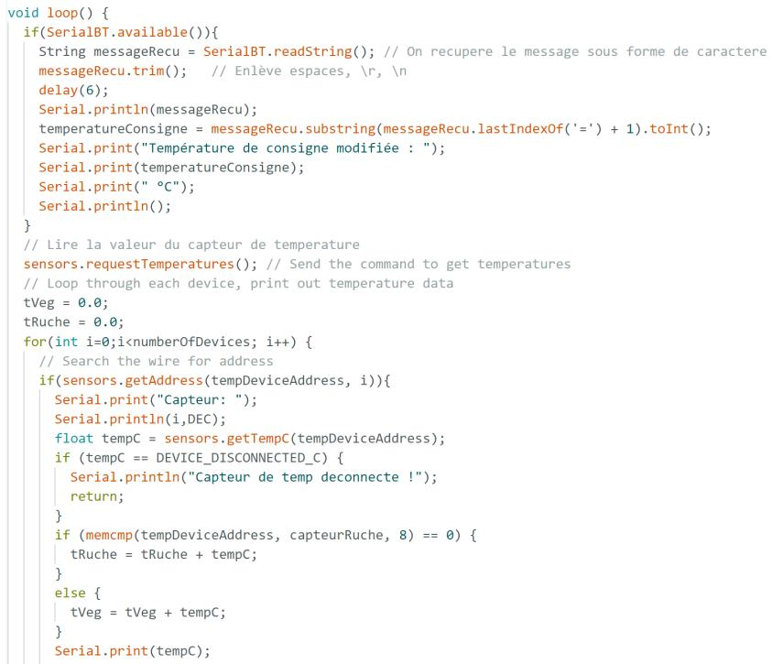
[picture p247: figure]
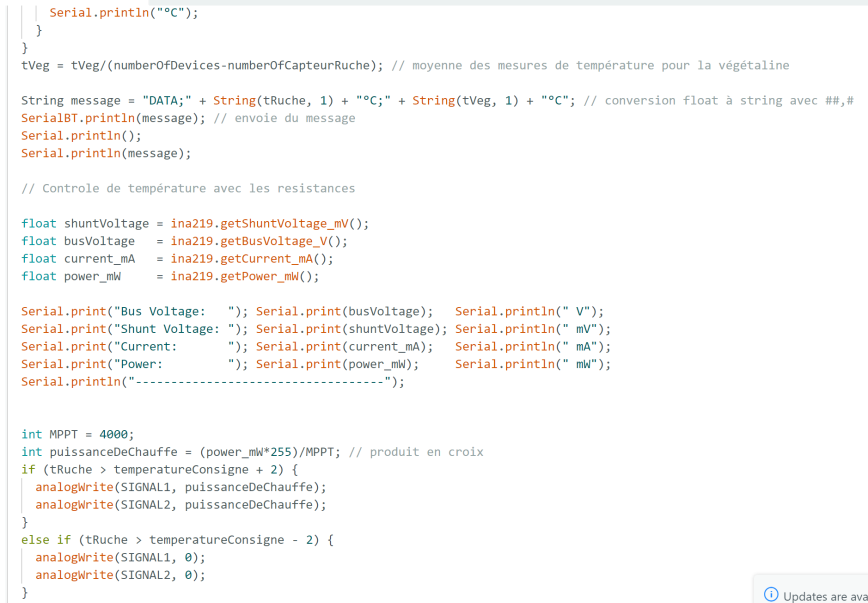
[picture p248: figure]

## 3) Interaction améliorée avec l’application :

Côté application, deux pages principales ont été mises en œuvre : la page de Monitoring permettant d’afficher les valeurs envoyées par l’ESP32, et la page SET, dédiée à la modification de la consigne de température. Sur cette page, la réception des messages Bluetooth sert principalement à vérifier que la connexion reste active. En l’absence de données reçues pendant un certain temps, l’application considère que la connexion est perdue et tente automatiquement de se reconnecter.

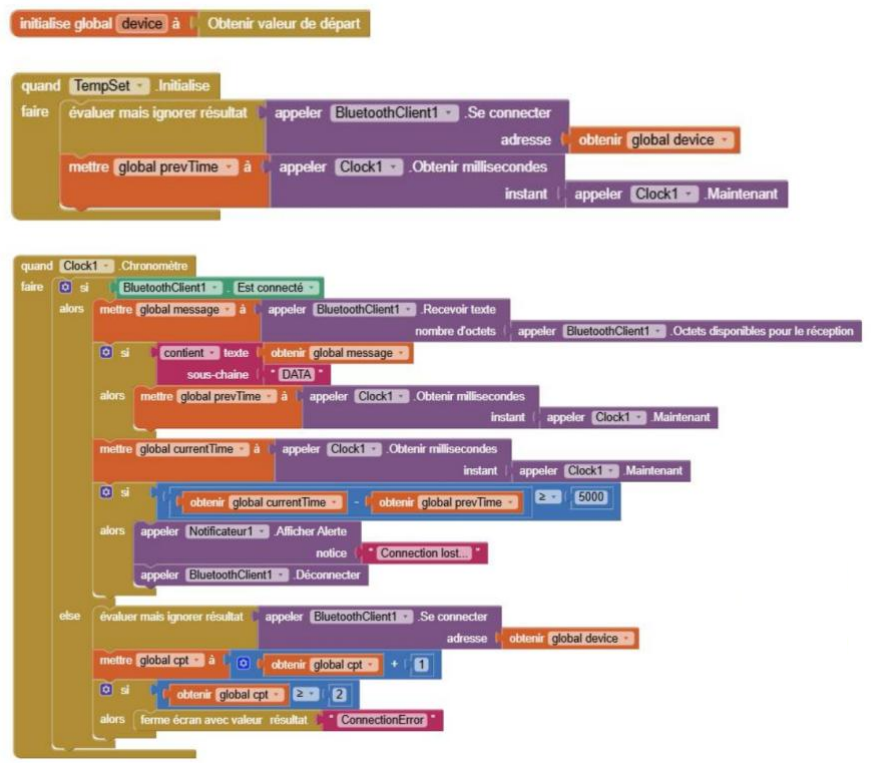
[picture p249: figure]

Lors de la saisie d’une nouvelle consigne, une vérification logicielle est effectuée : si la
température entrée est inférieure à 32 °C ou supérieure à 36 °C, elle est automatiquement corrigée et une alerte est affichée à l’utilisateur. Une fois la valeur validée, la commande Bluetooth correspondante est envoyée à l’ESP32, garantissant une transmission fiable et sécurisée de la consigne.

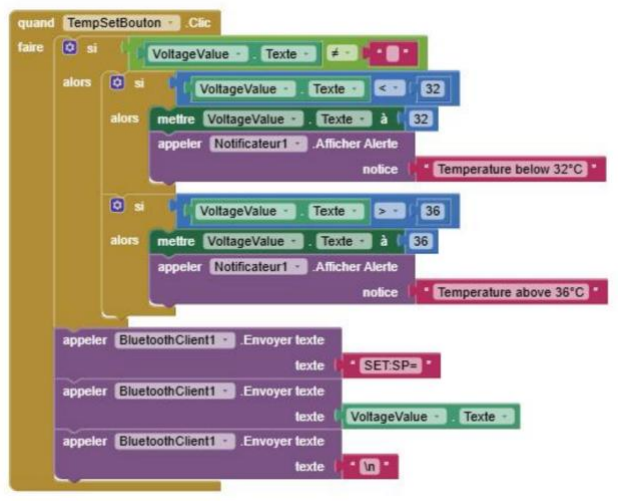
[picture p250: figure]

## 4) Rotation dans les deux sens du moteur :

Pour faire touner le panneau, un second
ESP32 est dédié au pilotage d’un moteur pas
à pas. Le contrôle est assuré par une
fonction développée en bas niveau, qui active successivement les bobines du moteur à l’aide de digitalWrite() selon une
séquence définie, intégrée dans une boucle
for allant de 0 à 511. Ce nombre de 512 pas

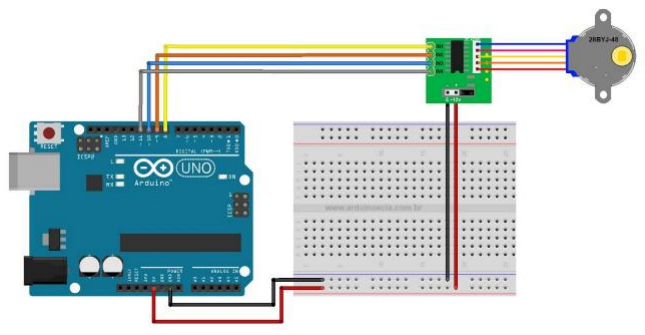
[picture p251: figure]

correspond au fonctionnement interne du moteur et de son réducteur, et permet d’obtenir un tour complet de l’axe de sortie, garantissant une rotation précise du panneau.
Lors du développement, in a utilisé la bibliothèque Stepper pour simplifier le pilotage du moteur. Cependant, lors des tests, la fonction Stepper.step() provoquait une rotation en sens antihoraire sulement. J’ai participé au débogage de cette partie du système. Il a alors été décidé d’abandonner la fonction de la bibliothèque au profit d’une fonction personnalisée, permettant de forcer une rotation dans le sens horaire simplement en modifiant l’ordre d’activation des bobines.

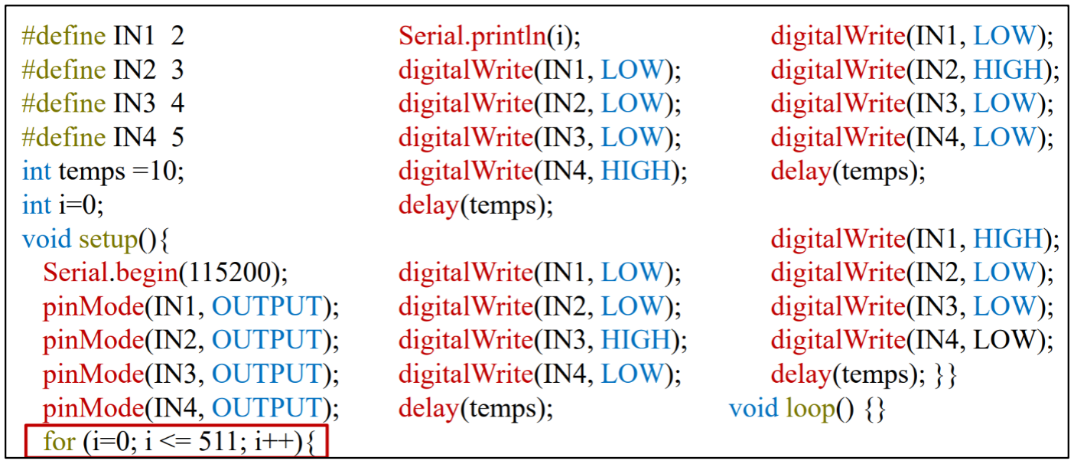
[picture p252: figure]
