eyazaoun/BeeWarm/doc/Anas ESSALIMI/SEANCE 13.pdf

## Séance 13 – Finalisation du layout et préparation à la fabrication

ESSALIMI Anas

Objectif de la séance

L’objectif de cette séance était de finaliser complètement le layout de la carte sous Eagle afin d’obtenir une version prête à être envoyée en fabrication. Après les séances précédentes consacrées au placement des composants puis au routage, le travail a porté ici sur la correction des dernières erreurs, la vérification du design, puis l’export des fichiers nécessaires à l’impression du PCB.

Corrections et vérifications du layout

En début de séance, la carte n’était pas encore exploitable telle quelle. Le routage était globalement terminé, mais il restait de nombreuses erreurs de détail : pistes mal reliées, connexions visuellement proches mais non connectées électriquement, et quelques problèmes d’espacement entre conducteurs. Au total, cela représentait environ une soixantaine de petites erreurs à reprendre.

Cette phase a montré qu’un layout visuellement propre n’est pas forcément correct du point de vue électrique. Une piste peut sembler arriver au bon pad sans être réellement connectée, et un écart trop faible entre deux pistes peut créer un problème au moment de la fabrication. Il a donc fallu reprendre le routage localement, vérifier les jonctions, ajuster certains segments et corriger plusieurs points un par un.

La validation a ensuite été faite avec les outils de vérification d’Eagle. Le contrôle permet de repérer les erreurs bloquantes et les avertissements à examiner avant l’export final. La capture de la figure 1 montre une situation cohérente du projet : le schéma et la carte sont bien synchronisés, aucune erreur bloquante n’est signalée, et les avertissements restants doivent être interprétés avant validation définitive.

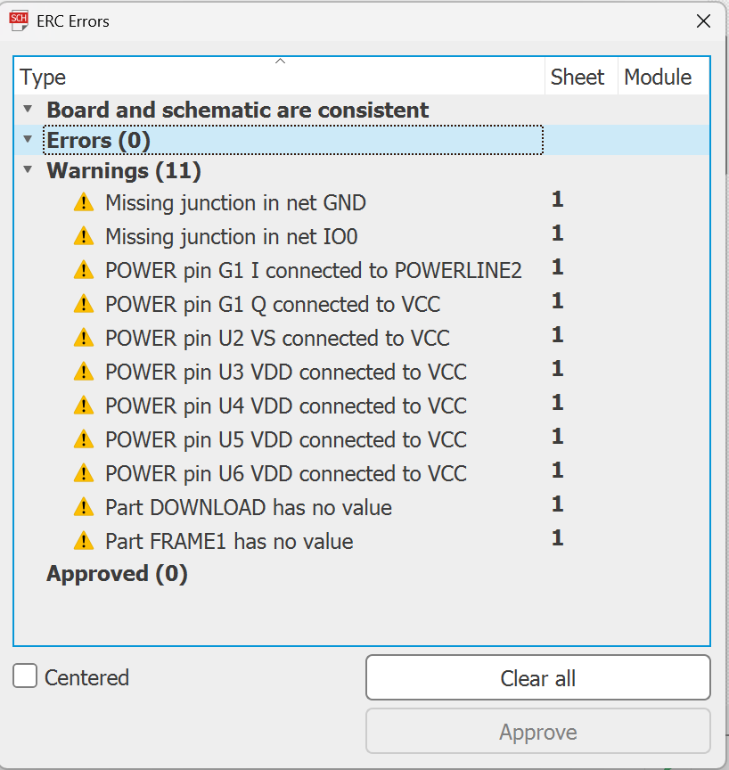
[picture p268: figure]

Figure 1 – Fenêtre de vérification sous Eagle : cohérence entre schéma et carte, avec absence d’erreur bloquante au moment de la validation finale.

Carte finale obtenue

Après correction, la carte a atteint une version finalisée, suffisamment propre pour passer à la fabrication. Le routage exploite les deux couches du PCB et présente une structure maintenant stabilisée. La vue d’ensemble de la figure 2 correspond à l’état final du design retenu pour l’export.

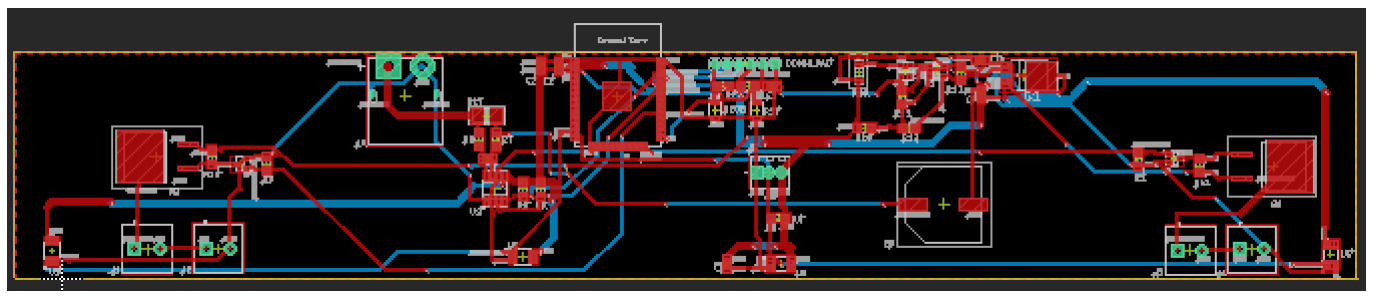
[picture p269: figure]

Figure 2 – Vue générale de la carte finalisée après corrections et validation.

Pour mieux visualiser le résultat, plusieurs zones de la carte peuvent être observées séparément. Ces vues montrent la densité du routage au centre et les connexions ramenées vers les extrémités de la carte.

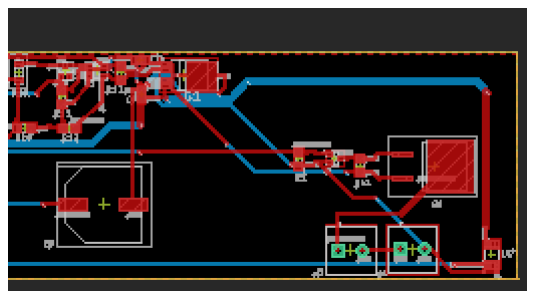
[picture p270: figure]
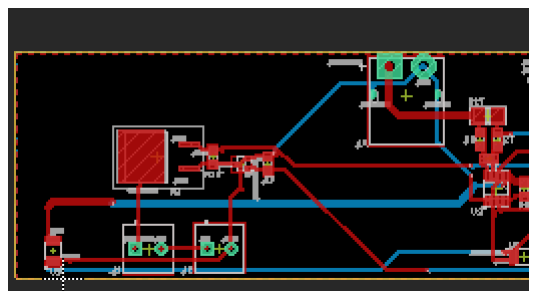
[picture p271: figure]
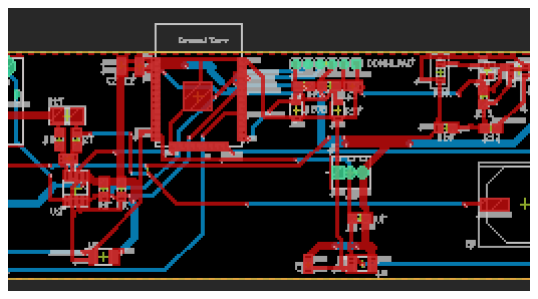
[picture p272: figure]

Figure 3 – Zooms sur la partie gauche, la zone centrale et la partie droite de la carte.

Export des fichiers de fabrication

Une fois la vérification terminée et le layout jugé correct, l’étape suivante a consisté à générer les fichiers de fabrication. Dans un flux de conception PCB classique, cela correspond à l’export des fichiers Gerber, qui décrivent les différentes couches nécessaires à l’impression de la carte.

Ces fichiers ont ensuite été regroupés dans une archive compressée afin de pouvoir être envoyés au service de fabrication. Cette étape marque concrètement la fin de la phase de conception du PCB : à partir de ce moment, le travail n’est plus seulement un design logiciel, mais un dossier technique prêt à être produit.

Figure 4 – Archive des fichiers Gerber générée pour l’envoi en fabrication.

Bilan de la séance

Cette séance a clôturé la partie layout du projet. Le travail principal n’a pas consisté à ajouter de nouvelles fonctions, mais à fiabiliser la carte : corriger les erreurs résiduelles, confirmer la validité du design et produire les fichiers nécessaires à la fabrication.

Le point important retenu est que la phase de vérification est indispensable. Même après un routage terminé en apparence, de nombreuses petites erreurs peuvent subsister. La validation finale sous Eagle permet donc d’éviter l’envoi d’une carte incorrecte en production.

Pendant le temps restant, la séance a aussi permis de mieux comprendre l’organisation interne du circuit et de prendre davantage de recul sur certaines parties réalisées par les autres membres du groupe. Cela a aidé à replacer mon travail dans l’ensemble du projet et à mieux comprendre la structure complète de la carte.
