eyazaoun/BeeWarm/Progress/Photos/20260505_113538.jpg

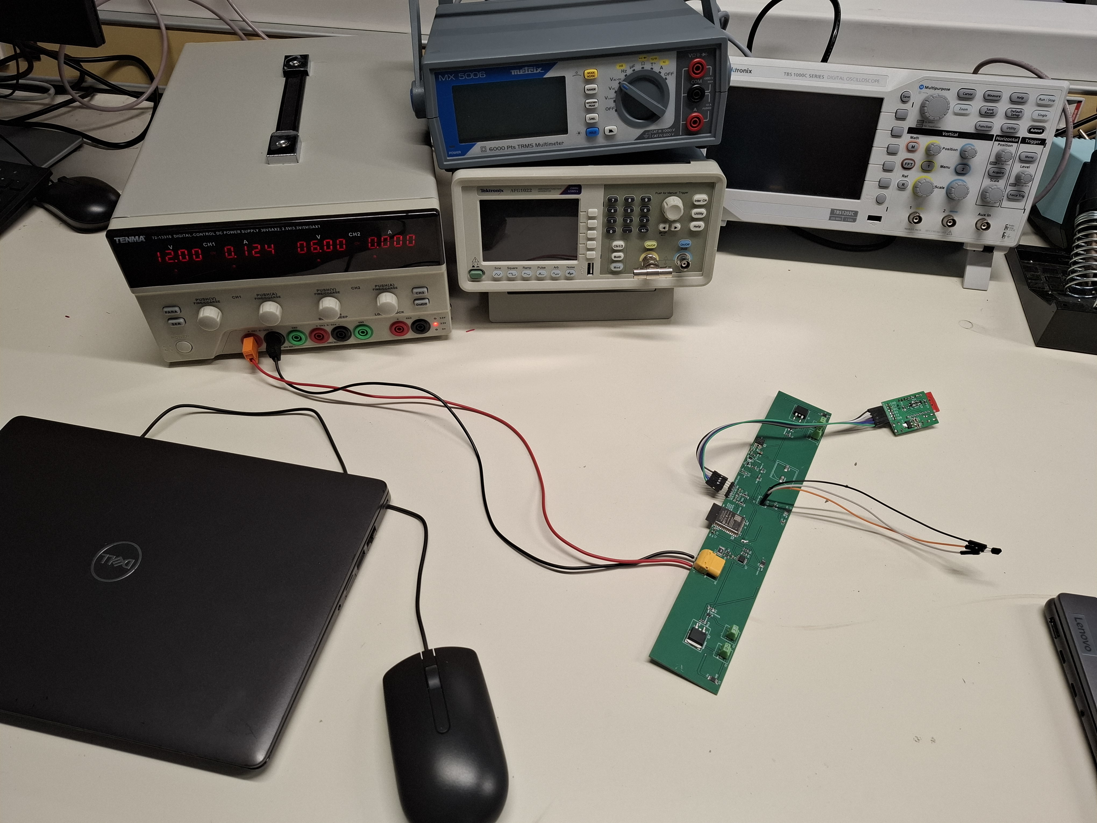
Progress/Photos/20260505_113538.jpg
