eyazaoun/BeeWarm/Progress/Photos/20260505_113546.jpg

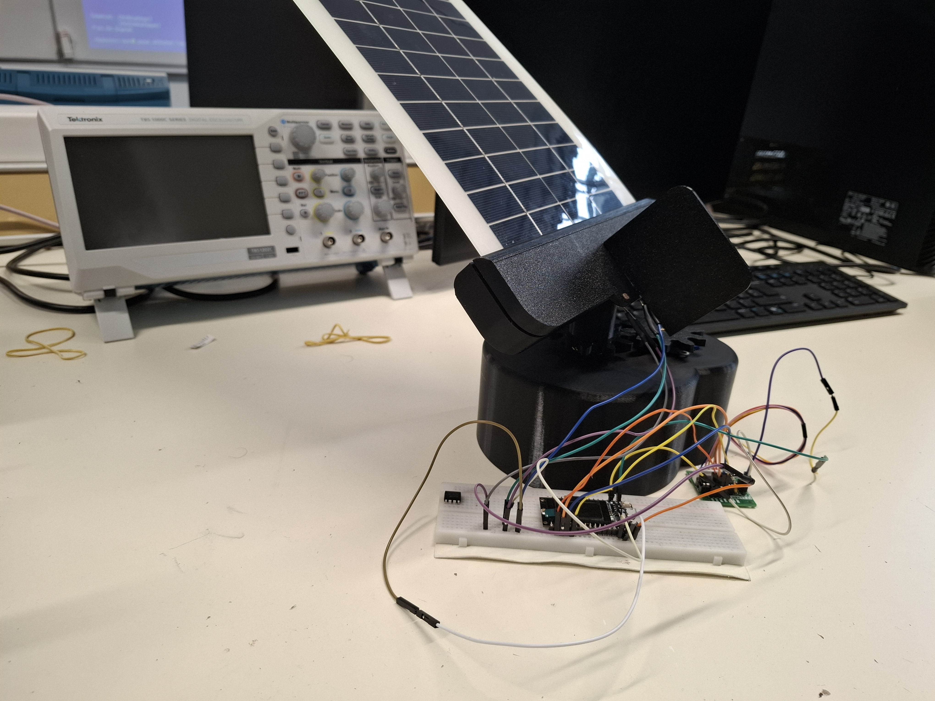
Progress/Photos/20260505_113546.jpg
