eyazaoun/BeeWarm/Progress/Photos/20260505_113549.jpg

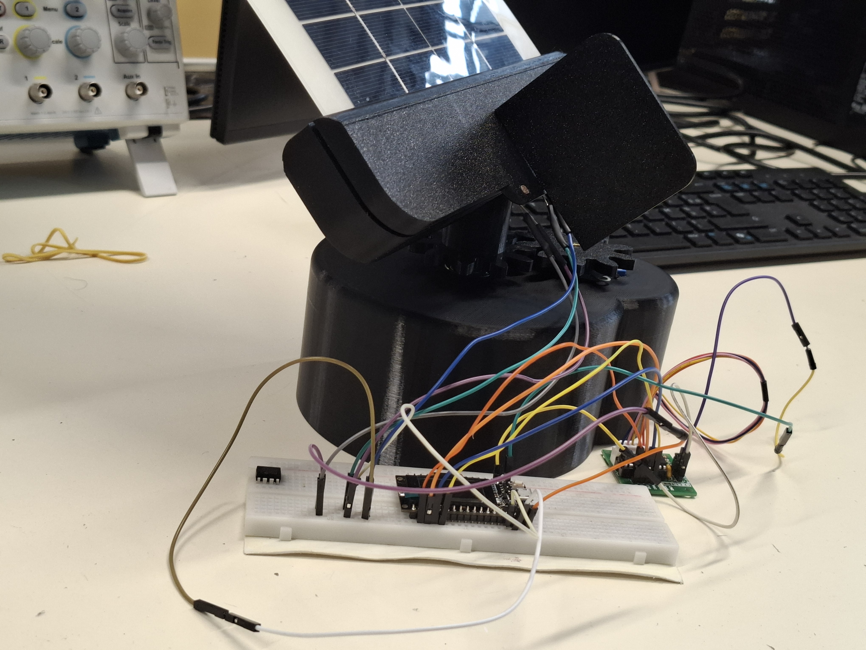
Progress/Photos/20260505_113549.jpg
