eyazaoun/BeeWarm/Progress/Photos/IMG_8516.jpeg

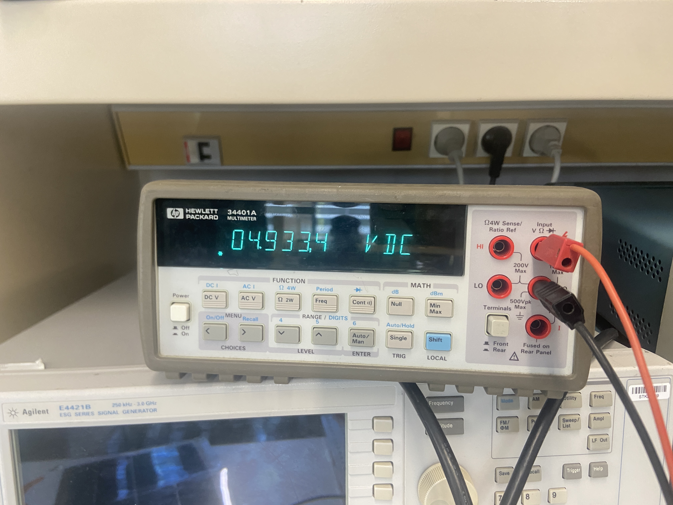
Progress/Photos/IMG_8516.jpeg
