eyazaoun/BeeWarm/Progress/Photos/IMG_8518.jpeg

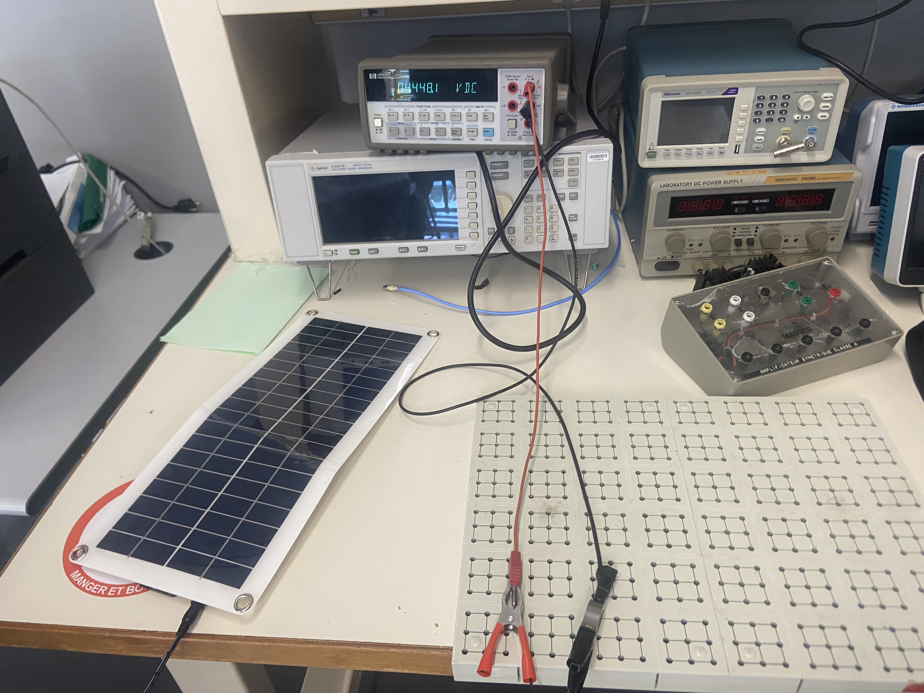
Progress/Photos/IMG_8518.jpeg
