eyazaoun/BeeWarm/Progress/Photos/IMG_8519.jpeg

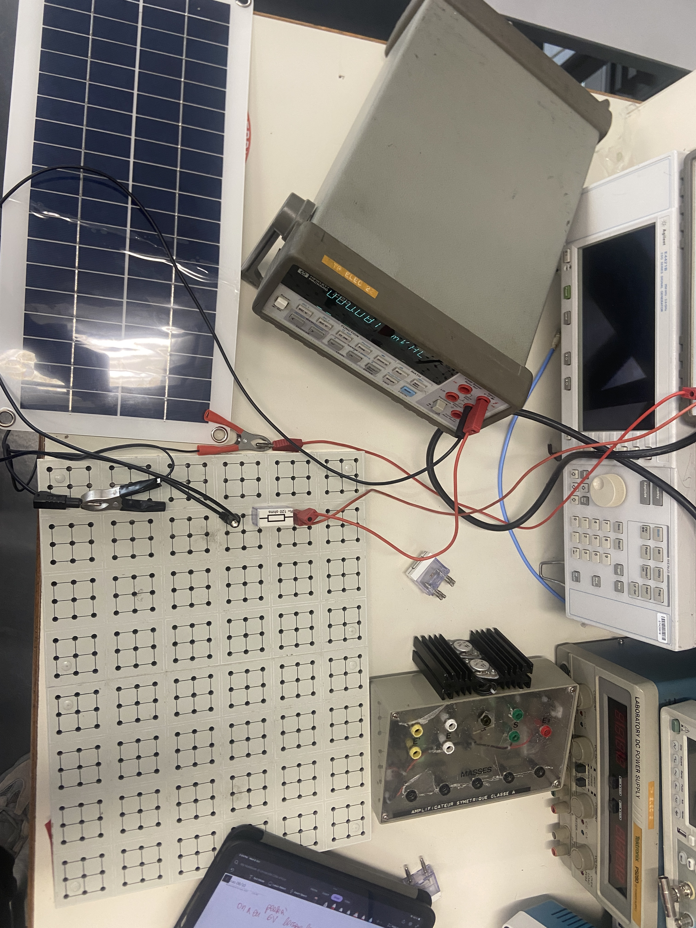
Progress/Photos/IMG_8519.jpeg
