eyazaoun/BeeWarm/Progress/Photos/IMG_8520.jpeg

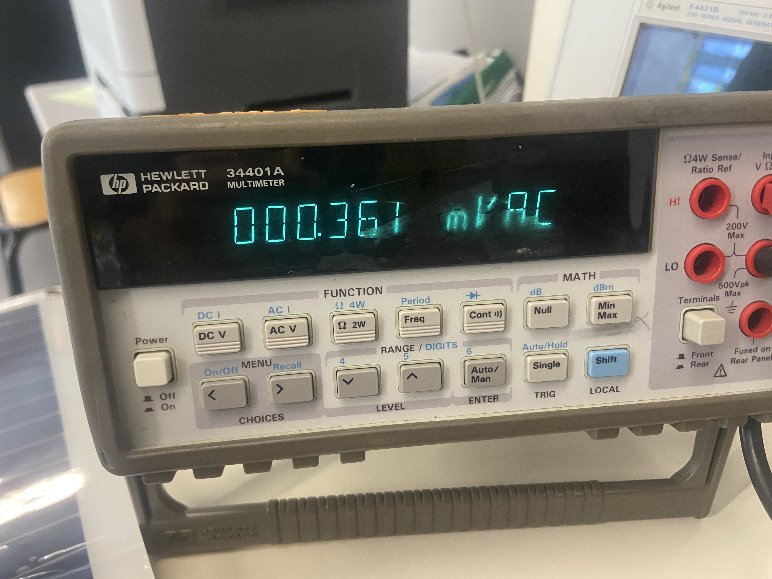
Progress/Photos/IMG_8520.jpeg
