eyazaoun/BeeWarm/Progress/Photos/IMG_8521.jpeg

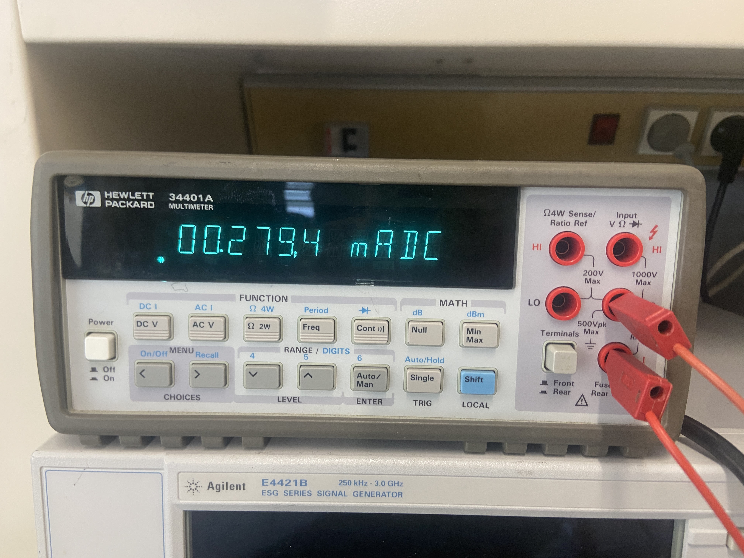
Progress/Photos/IMG_8521.jpeg
