eyazaoun/BeeWarm/Progress/Photos/IMG_8523.jpeg

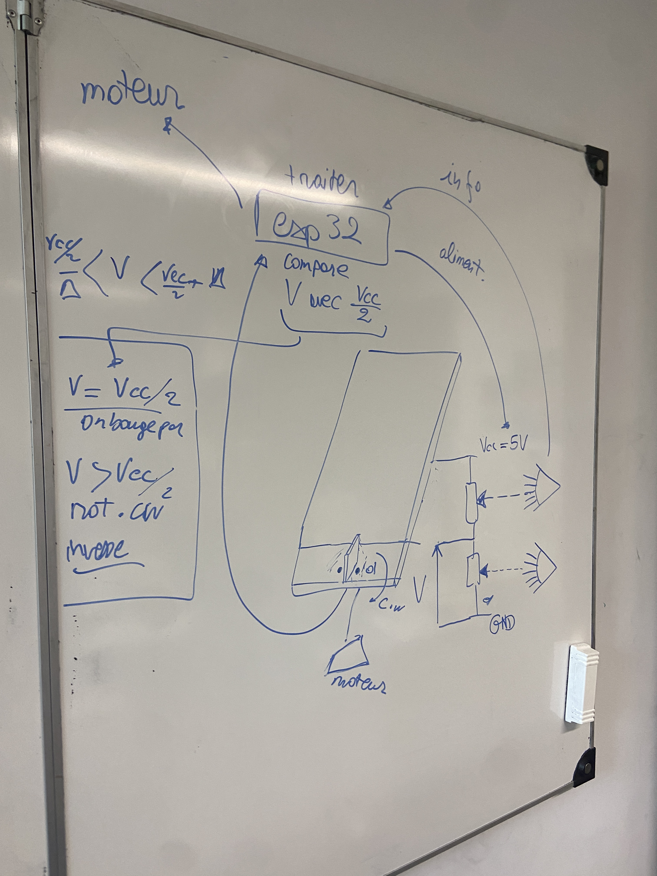
Progress/Photos/IMG_8523.jpeg
