eyazaoun/BeeWarm/Progress/Photos/IMG_9442.jpeg

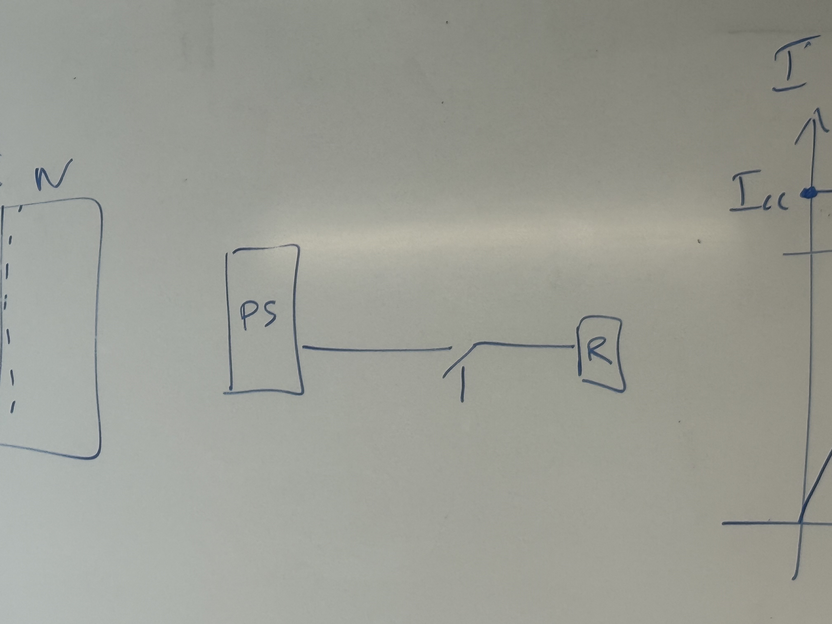
Progress/Photos/IMG_9442.jpeg
