eyazaoun/BeeWarm/Progress/Photos/IMG_9443.jpeg

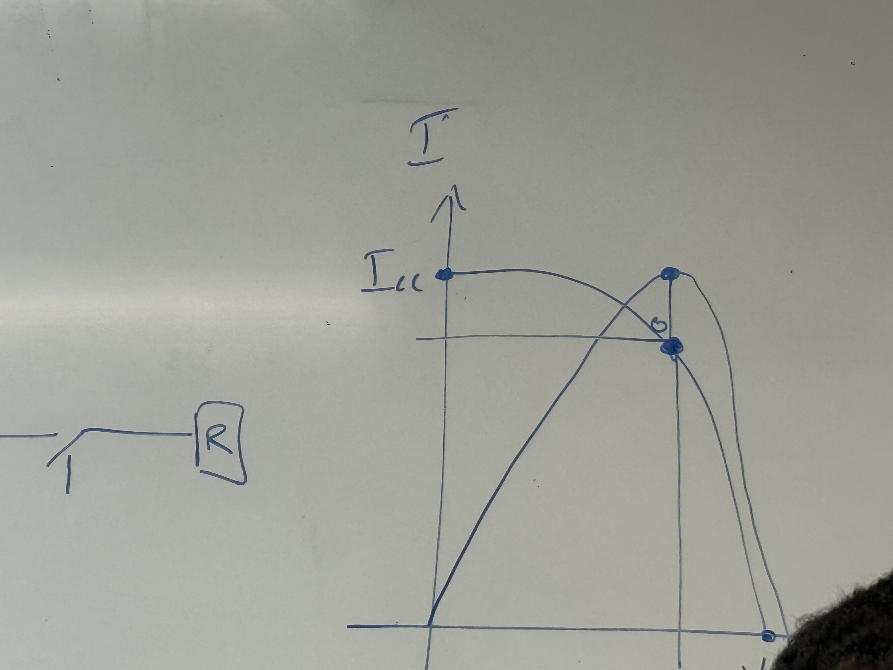
Progress/Photos/IMG_9443.jpeg
