eyazaoun/BeeWarm/ecoconception/BEEWARM_Ecoconception_based_on_BOM.xlsx

Sheet: Vue_blocs
Projet | Carte électronique instrumentée avec alimentation, mesure et communication autour d’un ESP-WROOM-03.
Hypothèse de description | Supervision d’un système basse tension avec INA219, 4x DS18B20, module ESP et étages de commutation/protection.
Source utilisée | Nomenclature exportée du schéma Eagle fourni.
Carte(s) identifiée(s) | 1 carte principale structurée en plusieurs blocs fonctionnels.
Point d’attention | Remplacer les traductions ecoinvent candidates par les libellés exacts du cours.
Bloc fonctionnel | Nombre de composants
Alimentation / protection | 5
Capteurs de température | 4
Commande / communication | 4
Commutation / adaptation | 5
Connectique de sortie | 4
Mesure courant / tension | 1
Passifs / filtrage | 7
Passifs / polarisation | 17

Sheet: Inventaire
Carte | Bloc fonctionnel | RefDes | Qté | Composant / valeur | Boîtier | Catégorie ACV | Fonction supposée | Traduction ecoinvent candidate | Niveau de confiance | Remarques
Carte principale | Passifs / filtrage | C1 | 1 | 100n | C0805 | Condensateur céramique CMS | Découplage / filtrage local | Capacitor, for surface mounting, ceramic (candidate) | Moyen | Passif générique
Carte principale | Passifs / filtrage | C2 | 1 | 47u | C0805 | Condensateur céramique CMS | Découplage / filtrage local | Capacitor, for surface mounting, ceramic (candidate) | Moyen | Passif générique
Carte principale | Passifs / filtrage | C3 | 1 | 100n | C0805 | Condensateur céramique CMS | Découplage / filtrage local | Capacitor, for surface mounting, ceramic (candidate) | Moyen | Passif générique
Carte principale | Passifs / filtrage | C5 | 1 | 0.1µ | C0805 | Condensateur céramique CMS | Découplage / filtrage local | Capacitor, for surface mounting, ceramic (candidate) | Moyen | Passif générique
Carte principale | Passifs / filtrage | C6 | 1 | 0.1µ | C0805 | Condensateur céramique CMS | Découplage / filtrage local | Capacitor, for surface mounting, ceramic (candidate) | Moyen | Passif générique
Carte principale | Passifs / filtrage | C7 | 1 | 100n | C0805 | Condensateur céramique CMS | Découplage / filtrage local | Capacitor, for surface mounting, ceramic (candidate) | Moyen | Passif générique
Carte principale | Passifs / filtrage | C8 | 1 | 10u | C0805 | Condensateur céramique CMS | Découplage / filtrage local | Capacitor, for surface mounting, ceramic (candidate) | Moyen | Passif générique
Carte principale | Alimentation / protection | C9 | 1 | 865080663020 | CAPAE1600X1700N | Condensateur électrolytique | Stockage d'énergie / filtrage | Capacitor, aluminium electrolytic, mounted (candidate) | Moyen | Passif générique
Carte principale | Commande / communication | DOWNLOAD | 1 |  | 1X06S | Connecteur | Interconnexion | Connector / terminal block for PCB (candidate) | Bon | MPN identifié
Carte principale | Alimentation / protection | G1 | 1 | TLS850B0TE_V33 | TO114P998X250-6_5N-1 | Régulateur linéaire 3,3 V | Régulation de tension | Integrated circuit, voltage regulator (candidate) | Bon | MPN identifié
Carte principale | Connectique de sortie | J1 | 1 | 282857-2 | TE_282857-2 | Connecteur | Interconnexion | Connector / terminal block for PCB (candidate) | Moyen | Vérifier sur schéma
Carte principale | Connectique de sortie | J2 | 1 | 282857-2 | TE_282857-2 | Connecteur | Interconnexion | Connector / terminal block for PCB (candidate) | Moyen | Vérifier sur schéma
Carte principale | Connectique de sortie | J3 | 1 | 282857-2 | TE_282857-2 | Connecteur | Interconnexion | Connector / terminal block for PCB (candidate) | Moyen | Vérifier sur schéma
Carte principale | Connectique de sortie | J4 | 1 | 282857-2 | TE_282857-2 | Connecteur | Interconnexion | Connector / terminal block for PCB (candidate) | Moyen | Vérifier sur schéma
Carte principale | Alimentation / protection | J5 | 1 | 282834-3 | TE_282834-3 | Connecteur | Interconnexion | Connector / terminal block for PCB (candidate) | Moyen | Vérifier sur schéma
Carte principale | Alimentation / protection | J6 | 1 | XT60PW-M | AMASS_XT60PW-M | Connecteur | Interconnexion | Connector / terminal block for PCB (candidate) | Moyen | Vérifier sur schéma
Carte principale | Commande / communication | PROG | 1 | B3U-1000PB | SW_B3U-1000PB | Bouton poussoir tactile | Interface utilisateur / programmation | Switch, tactile, surface mounted (candidate) | Bon | MPN identifié
Carte principale | Commutation / adaptation | Q1 | 1 | FQB22P10TM | FQB22P10TM | MOSFET de puissance | Commutation de charge | Transistor, MOSFET, power, mounted on board (candidate) | Bon | MPN identifié
Carte principale | Commutation / adaptation | Q2 | 1 | FQB22P10TM | FQB22P10TM | MOSFET de puissance | Commutation de charge | Transistor, MOSFET, power, mounted on board (candidate) | Bon | MPN identifié
Carte principale | Commutation / adaptation | Q3 | 1 | AP331AWG-7 | SOT95P285X145-5N | Comparateur | Comparaison de seuil | Integrated circuit, analog comparator (candidate) | Bon | MPN identifié
Carte principale | Commutation / adaptation | Q4 | 1 | BSS138 | SOT95P240X111-3N | MOSFET petit signal | Adaptation de niveau / commande | Transistor, MOSFET, small signal, mounted (candidate) | Bon | MPN identifié
Carte principale | Commutation / adaptation | Q5 | 1 | BSS138 | SOT95P240X111-3N | MOSFET petit signal | Adaptation de niveau / commande | Transistor, MOSFET, small signal, mounted (candidate) | Bon | MPN identifié
Carte principale | Passifs / polarisation | R1 | 1 | 100k | R1206 | Résistance CMS | Polarisation / pull-up / pont diviseur | Resistor, chip resistor, surface mounted (candidate) | Moyen | Passif générique
Carte principale | Passifs / polarisation | R2 | 1 | 100k | R1206 | Résistance CMS | Polarisation / pull-up / pont diviseur | Resistor, chip resistor, surface mounted (candidate) | Moyen | Passif générique
Carte principale | Passifs / polarisation | R3 | 1 | 33k | R1206 | Résistance CMS | Polarisation / pull-up / pont diviseur | Resistor, chip resistor, surface mounted (candidate) | Moyen | Passif générique
Carte principale | Passifs / polarisation | R4 | 1 | 4,7k | R1206 | Résistance CMS | Polarisation / pull-up / pont diviseur | Resistor, chip resistor, surface mounted (candidate) | Moyen | Passif générique
Carte principale | Passifs / polarisation | R5 | 1 | 33k | R1206 | Résistance CMS | Polarisation / pull-up / pont diviseur | Resistor, chip resistor, surface mounted (candidate) | Moyen | Passif générique
Carte principale | Passifs / polarisation | R6 | 1 | 3.3k | R1206 | Résistance CMS | Polarisation / pull-up / pont diviseur | Resistor, chip resistor, surface mounted (candidate) | Moyen | Passif générique
Carte principale | Passifs / polarisation | R7 | 1 | 10.2 | R1206 | Résistance CMS | Polarisation / pull-up / pont diviseur | Resistor, chip resistor, surface mounted (candidate) | Moyen | Passif générique
Carte principale | Passifs / polarisation | R8 | 1 | 10.2 | R1206 | Résistance CMS | Polarisation / pull-up / pont diviseur | Resistor, chip resistor, surface mounted (candidate) | Moyen | Passif générique
Carte principale | Passifs / polarisation | R9 | 1 | 3.3k | R1206 | Résistance CMS | Polarisation / pull-up / pont diviseur | Resistor, chip resistor, surface mounted (candidate) | Moyen | Passif générique
Carte principale | Passifs / polarisation | R10 | 1 | 33k | R1206 | Résistance CMS | Polarisation / pull-up / pont diviseur | Resistor, chip resistor, surface mounted (candidate) | Moyen | Passif générique
Carte principale | Passifs / polarisation | R11 | 1 | 33k | R1206 | Résistance CMS | Polarisation / pull-up / pont diviseur | Resistor, chip resistor, surface mounted (candidate) | Moyen | Passif générique
Carte principale | Passifs / polarisation | R12 | 1 | 33k | R1206 | Résistance CMS | Polarisation / pull-up / pont diviseur | Resistor, chip resistor, surface mounted (candidate) | Moyen | Passif générique
Carte principale | Passifs / polarisation | R13 | 1 | 150k | R1206 | Résistance CMS | Polarisation / pull-up / pont diviseur | Resistor, chip resistor, surface mounted (candidate) | Moyen | Passif générique
Carte principale | Passifs / polarisation | R14 | 1 | 4,7k | R1206 | Résistance CMS | Polarisation / pull-up / pont diviseur | Resistor, chip resistor, surface mounted (candidate) | Moyen | Passif générique
Carte principale | Passifs / polarisation | R15 | 1 | 10k | R1206 | Résistance CMS | Polarisation / pull-up / pont diviseur | Resistor, chip resistor, surface mounted (candidate) | Moyen | Passif générique
Carte principale | Passifs / polarisation | R16 | 1 | ERJ-P08J821V | ERJP08_(1206) | Résistance CMS | Polarisation / pull-up / pont diviseur | Resistor, chip resistor, surface mounted (candidate) | Moyen | Passif générique
Carte principale | Passifs / polarisation | R17 | 1 | WSL2512R1000FEA | RESC6432X89N | Résistance shunt de puissance | Mesure de courant | Resistor, shunt / metal strip resistor (candidate) | Moyen | Passif générique
Carte principale | Commande / communication | RST | 1 | B3U-1000PB | SW_B3U-1000PB | Résistance CMS | Polarisation / pull-up / pont diviseur | Resistor, chip resistor, surface mounted (candidate) | Moyen | Passif générique
Carte principale | Commande / communication | U1 | 1 | ESP-WROOM-03 | ESP-WROOM-03 | Module radio / microcontrôleur | Pilotage + communication | Mounted board / communication module with ICs (candidate) | Bon | MPN identifié
Carte principale | Mesure courant / tension | U2 | 1 | INA219AID | SOIC127P599X175-8N | Capteur de courant / tension | Mesure électrique | Integrated circuit, current sensor (candidate) | Bon | MPN identifié
Carte principale | Capteurs de température | U3 | 1 | DS18B20U+T&R | SOP65P490X110-8N | Capteur de température numérique | Mesure de température | Integrated circuit, temperature sensor (candidate) | Bon | MPN identifié
Carte principale | Capteurs de température | U4 | 1 | DS18B20U+T&R | SOP65P490X110-8N | Capteur de température numérique | Mesure de température | Integrated circuit, temperature sensor (candidate) | Bon | MPN identifié
Carte principale | Capteurs de température | U5 | 1 | DS18B20U+T&R | SOP65P490X110-8N | Capteur de température numérique | Mesure de température | Integrated circuit, temperature sensor (candidate) | Bon | MPN identifié
Carte principale | Capteurs de température | U6 | 1 | DS18B20U+T&R | SOP65P490X110-8N | Capteur de température numérique | Mesure de température | Integrated circuit, temperature sensor (candidate) | Bon | MPN identifié
Carte principale | Alimentation / protection | Z1 | 1 | BZX84C6V8LT1G | SOT96P237X111-3N | Diode Zener | Protection surtension | Diode, protection / zener, mounted (candidate) | Bon | MPN identifié

Sheet: Synthese_blocs
Bloc fonctionnel | Catégorie ACV | Nombre | Consignes
Alimentation / protection | Condensateur électrolytique | 1 | 1 | Remplacer les intitulés candidats par les libellés exacts de vos documents de cours.
Alimentation / protection | Connecteur | 2 | 2 | Valider la répartition des passifs par bloc à partir du schéma.
Alimentation / protection | Diode Zener | 1 | 3 | Ajouter une deuxième déclinaison pour la comparaison ACV finale.
Alimentation / protection | Régulateur linéaire 3,3 V | 1
Capteurs de température | Capteur de température numérique | 4
Commande / communication | Bouton poussoir tactile | 1
Commande / communication | Connecteur | 1
Commande / communication | Module radio / microcontrôleur | 1
Commande / communication | Résistance CMS | 1
Commutation / adaptation | Comparateur | 1
Commutation / adaptation | MOSFET de puissance | 2
Commutation / adaptation | MOSFET petit signal | 2
Connectique de sortie | Connecteur | 4
Mesure courant / tension | Capteur de courant / tension | 1
Passifs / filtrage | Condensateur céramique CMS | 7
Passifs / polarisation | Résistance CMS | 16
Passifs / polarisation | Résistance shunt de puissance | 1

Sheet: BOM_brute
Part | Value | Device | Package | Description
C1 | 100n | C | C0805 | CAPACITOR, European symbol
C2 | 47u | C | C0805 | CAPACITOR, European symbol
C3 | 100n | C | C0805 | CAPACITOR, European symbol
C5 | 0.1µ | C | C0805 | CAPACITOR, European symbol
C6 | 0.1µ | C | C0805 | CAPACITOR, European symbol
C7 | 100n | C | C0805 | CAPACITOR, European symbol
C8 | 10u | C | C0805 | CAPACITOR, European symbol
C9 | 865080663020 | 865080663020 | CAPAE1600X1700N | WCAP-ASLI Aluminum Electrolytic Capacitors ASEK170102M050DVCTHE000; SMT V-Chip; 1000 F +/- 20%; 50 V (DC); 5000 h; - 55 C / +105 C; size DxL 16.0 x 17.0; Max. Iripple 1000 mA@ 100 kHz; LC 500 A; DF 12%;
DOWNLOAD |  | PINHD-1X6S | 1X06S | PIN HEADER
G1 | TLS850B0TE_V33 | TLS850B0TE_V33 | TO114P998X250-6_5N-1
J1 | 282857-2 | 282857-2 | TE_282857-2
J2 | 282857-2 | 282857-2 | TE_282857-2
J3 | 282857-2 | 282857-2 | TE_282857-2
J4 | 282857-2 | 282857-2 | TE_282857-2
J5 | 282834-3 | 282834-3 | TE_282834-3
J6 | XT60PW-M | XT60PW-M | AMASS_XT60PW-M
PROG | B3U-1000PB | B3U-1000PB | SW_B3U-1000PB | Switch Tactile N.O. SPST Round Button Gull Wing 0.05A 12VDC 1.5N SMD Embossed T/R
Q1 | FQB22P10TM | FQB22P10TM | FQB22P10TM | 175C maximum junction temperature rating; Low Crss ( Typ. 160pF); -22A, -100V, RDS(on) =125m(Max.) @VGS = -10 V, ID = -11A; Low gate charge ( Typ.40nC); 100% avalanche tested
Q2 | FQB22P10TM | FQB22P10TM | FQB22P10TM | 175C maximum junction temperature rating; Low Crss ( Typ. 160pF); -22A, -100V, RDS(on) =125m(Max.) @VGS = -10 V, ID = -11A; Low gate charge ( Typ.40nC); 100% avalanche tested
Q3 | AP331AWG-7 | AP331AWG-7 | SOT95P285X145-5N | DiodesZetex AP331AWG-7 Comparator, Open Collector O/P, 1.3us 2 36 V 5-Pin SOT-25
Q4 | BSS138 | BSS138 | SOT95P240X111-3N | Check availability
Q5 | BSS138 | BSS138 | SOT95P240X111-3N | Check availability
R1 | 100k | RR1206 | R1206 | RESISTOR, European symbol
R2 | 100k | RR1206 | R1206 | RESISTOR, European symbol
R3 | 33k | RR1206 | R1206 | RESISTOR, European symbol
R4 | 4,7k | RR1206 | R1206 | RESISTOR, European symbol
R5 | 33k | RR1206 | R1206 | RESISTOR, European symbol
R6 | 3.3k | RR1206 | R1206 | RESISTOR, European symbol
R7 | 10.2 | RR1206 | R1206 | RESISTOR, European symbol
R8 | 10.2 | RR1206 | R1206 | RESISTOR, European symbol
R9 | 3.3k | RR1206 | R1206 | RESISTOR, European symbol
R10 | 33k | RR1206 | R1206 | RESISTOR, European symbol
R11 | 33k | RR1206 | R1206 | RESISTOR, European symbol
R12 | 33k | RR1206 | R1206 | RESISTOR, European symbol
R13 | 150k | RR1206 | R1206 | RESISTOR, European symbol
R14 | 4,7k | RR1206 | R1206 | RESISTOR, European symbol
R15 | 10k | RR1206 | R1206 | RESISTOR, European symbol
R16 | ERJ-P08J821V | ERJ-P08J821V | ERJP08_(1206) | Anti-Surge Thick Film Chip Resistor, 1206, 0.66W
R17 | WSL2512R1000FEA | WSL2512R1000FEA | RESC6432X89N | WSL2512 SMD Resistor,1W,1%,R100 Vishay WSL Series Metal Strip Low Ohmic Surface Mount Resistor 2512 Case 100m +/-1% 1W +/-75ppm/C
RST | B3U-1000PB | B3U-1000PB | SW_B3U-1000PB | Switch Tactile N.O. SPST Round Button Gull Wing 0.05A 12VDC 1.5N SMD Embossed T/R
U1 | ESP-WROOM-03 | ESP-WROOM-03 | ESP-WROOM-03
U2 | INA219AID | INA219AID | SOIC127P599X175-8N
U3 | DS18B20U+T&R | DS18B20U+T&R | SOP65P490X110-8N | Check availability
U4 | DS18B20U+T&R | DS18B20U+T&R | SOP65P490X110-8N | Check availability
U5 | DS18B20U+T&R | DS18B20U+T&R | SOP65P490X110-8N | Check availability
U6 | DS18B20U+T&R | DS18B20U+T&R | SOP65P490X110-8N | Check availability
Z1 | BZX84C6V8LT1G | BZX84C6V8LT1G | SOT96P237X111-3N | 250 mW Rating on FR-4 or FR-5 Board; Zener Breakdown Voltage Range - 2.4 V to 75 V; Package Designed for Optimal Automated Board Assembly; Small Package Size for High Density Applications; ESD Rating of Class 3 (>16 KV) per Human Body Model; Mechanical Characteristics:; CASE: Void-free, transfer-molded, thermosetting plastic case; FINISH: Corrosion resistant finish, easily solderable; MAXIMUM CASE TEMPERATURE FOR SOLDERING PURPOSES: 260C for 10 Seconds; POLARITY: Cathode indicated by polarity band; FLAMMAB
