eyazaoun/BeeWarm/ecoconception/ecoconception_inventaire_openlca.xlsx

Sheet: Vue_blocs
Projet | Carte électronique instrumentée avec alimentation, mesure et communication autour d’un ESP-WROOM-03.
Hypothèse de description | Supervision d’un système basse tension avec INA219, 4x DS18B20, module ESP et étages de commutation/protection.
Source utilisée | Nomenclature exportée du schéma Eagle fourni.
Carte(s) identifiée(s) | 1 carte principale structurée en plusieurs blocs fonctionnels.
Point d’attention | Remplacer les traductions ecoinvent candidates par les libellés exacts du cours.
Bloc fonctionnel | Nombre de composants
Alimentation / protection | 5
Capteurs de température | 4
Commande / communication | 4
Commutation / adaptation | 5
Connectique de sortie | 4
Mesure courant / tension | 1
Passifs / filtrage | 7
Passifs / polarisation | 17
Feuille ajoutée | OpenLCA_inputs
But | Regrouper les composants similaires pour réduire le nombre d'inputs OpenLCA
Colonnes clés | Qté + masse unitaire (kg) + Amount (kg)
Ajouts manuels | ESP32, panneau solaire, moteur rotatif, support 3D

Sheet: Inventaire
Carte | Bloc fonctionnel | RefDes | Qté | Composant / valeur | Boîtier | Catégorie ACV | Fonction supposée | Traduction ecoinvent candidate | Niveau de confiance | Remarques
Carte principale | Passifs / filtrage | C1 | 1 | 100n | C0805 | Condensateur céramique CMS | Découplage / filtrage local | Capacitor, for surface mounting, ceramic (candidate) | Moyen | Passif générique
Carte principale | Passifs / filtrage | C2 | 1 | 47u | C0805 | Condensateur céramique CMS | Découplage / filtrage local | Capacitor, for surface mounting, ceramic (candidate) | Moyen | Passif générique
Carte principale | Passifs / filtrage | C3 | 1 | 100n | C0805 | Condensateur céramique CMS | Découplage / filtrage local | Capacitor, for surface mounting, ceramic (candidate) | Moyen | Passif générique
Carte principale | Passifs / filtrage | C5 | 1 | 0.1µ | C0805 | Condensateur céramique CMS | Découplage / filtrage local | Capacitor, for surface mounting, ceramic (candidate) | Moyen | Passif générique
Carte principale | Passifs / filtrage | C6 | 1 | 0.1µ | C0805 | Condensateur céramique CMS | Découplage / filtrage local | Capacitor, for surface mounting, ceramic (candidate) | Moyen | Passif générique
Carte principale | Passifs / filtrage | C7 | 1 | 100n | C0805 | Condensateur céramique CMS | Découplage / filtrage local | Capacitor, for surface mounting, ceramic (candidate) | Moyen | Passif générique
Carte principale | Passifs / filtrage | C8 | 1 | 10u | C0805 | Condensateur céramique CMS | Découplage / filtrage local | Capacitor, for surface mounting, ceramic (candidate) | Moyen | Passif générique
Carte principale | Alimentation / protection | C9 | 1 | 865080663020 | CAPAE1600X1700N | Condensateur électrolytique | Stockage d'énergie / filtrage | Capacitor, aluminium electrolytic, mounted (candidate) | Moyen | Passif générique
Carte principale | Commande / communication | DOWNLOAD | 1 |  | 1X06S | Connecteur | Interconnexion | Connector / terminal block for PCB (candidate) | Bon | MPN identifié
Carte principale | Alimentation / protection | G1 | 1 | TLS850B0TE_V33 | TO114P998X250-6_5N-1 | Régulateur linéaire 3,3 V | Régulation de tension | Integrated circuit, voltage regulator (candidate) | Bon | MPN identifié
Carte principale | Connectique de sortie | J1 | 1 | 282857-2 | TE_282857-2 | Connecteur | Interconnexion | Connector / terminal block for PCB (candidate) | Moyen | Vérifier sur schéma
Carte principale | Connectique de sortie | J2 | 1 | 282857-2 | TE_282857-2 | Connecteur | Interconnexion | Connector / terminal block for PCB (candidate) | Moyen | Vérifier sur schéma
Carte principale | Connectique de sortie | J3 | 1 | 282857-2 | TE_282857-2 | Connecteur | Interconnexion | Connector / terminal block for PCB (candidate) | Moyen | Vérifier sur schéma
Carte principale | Connectique de sortie | J4 | 1 | 282857-2 | TE_282857-2 | Connecteur | Interconnexion | Connector / terminal block for PCB (candidate) | Moyen | Vérifier sur schéma
Carte principale | Alimentation / protection | J5 | 1 | 282834-3 | TE_282834-3 | Connecteur | Interconnexion | Connector / terminal block for PCB (candidate) | Moyen | Vérifier sur schéma
Carte principale | Alimentation / protection | J6 | 1 | XT60PW-M | AMASS_XT60PW-M | Connecteur | Interconnexion | Connector / terminal block for PCB (candidate) | Moyen | Vérifier sur schéma
Carte principale | Commande / communication | PROG | 1 | B3U-1000PB | SW_B3U-1000PB | Bouton poussoir tactile | Interface utilisateur / programmation | Switch, tactile, surface mounted (candidate) | Bon | MPN identifié
Carte principale | Commutation / adaptation | Q1 | 1 | FQB22P10TM | FQB22P10TM | MOSFET de puissance | Commutation de charge | Transistor, MOSFET, power, mounted on board (candidate) | Bon | MPN identifié
Carte principale | Commutation / adaptation | Q2 | 1 | FQB22P10TM | FQB22P10TM | MOSFET de puissance | Commutation de charge | Transistor, MOSFET, power, mounted on board (candidate) | Bon | MPN identifié
Carte principale | Commutation / adaptation | Q3 | 1 | AP331AWG-7 | SOT95P285X145-5N | Comparateur | Comparaison de seuil | Integrated circuit, analog comparator (candidate) | Bon | MPN identifié
Carte principale | Commutation / adaptation | Q4 | 1 | BSS138 | SOT95P240X111-3N | MOSFET petit signal | Adaptation de niveau / commande | Transistor, MOSFET, small signal, mounted (candidate) | Bon | MPN identifié
Carte principale | Commutation / adaptation | Q5 | 1 | BSS138 | SOT95P240X111-3N | MOSFET petit signal | Adaptation de niveau / commande | Transistor, MOSFET, small signal, mounted (candidate) | Bon | MPN identifié
Carte principale | Passifs / polarisation | R1 | 1 | 100k | R1206 | Résistance CMS | Polarisation / pull-up / pont diviseur | Resistor, chip resistor, surface mounted (candidate) | Moyen | Passif générique
Carte principale | Passifs / polarisation | R2 | 1 | 100k | R1206 | Résistance CMS | Polarisation / pull-up / pont diviseur | Resistor, chip resistor, surface mounted (candidate) | Moyen | Passif générique
Carte principale | Passifs / polarisation | R3 | 1 | 33k | R1206 | Résistance CMS | Polarisation / pull-up / pont diviseur | Resistor, chip resistor, surface mounted (candidate) | Moyen | Passif générique
Carte principale | Passifs / polarisation | R4 | 1 | 4,7k | R1206 | Résistance CMS | Polarisation / pull-up / pont diviseur | Resistor, chip resistor, surface mounted (candidate) | Moyen | Passif générique
Carte principale | Passifs / polarisation | R5 | 1 | 33k | R1206 | Résistance CMS | Polarisation / pull-up / pont diviseur | Resistor, chip resistor, surface mounted (candidate) | Moyen | Passif générique
Carte principale | Passifs / polarisation | R6 | 1 | 3.3k | R1206 | Résistance CMS | Polarisation / pull-up / pont diviseur | Resistor, chip resistor, surface mounted (candidate) | Moyen | Passif générique
Carte principale | Passifs / polarisation | R7 | 1 | 2026-02-10 | R1206 | Résistance CMS | Polarisation / pull-up / pont diviseur | Resistor, chip resistor, surface mounted (candidate) | Moyen | Passif générique
Carte principale | Passifs / polarisation | R8 | 1 | 2026-02-10 | R1206 | Résistance CMS | Polarisation / pull-up / pont diviseur | Resistor, chip resistor, surface mounted (candidate) | Moyen | Passif générique
Carte principale | Passifs / polarisation | R9 | 1 | 3.3k | R1206 | Résistance CMS | Polarisation / pull-up / pont diviseur | Resistor, chip resistor, surface mounted (candidate) | Moyen | Passif générique
Carte principale | Passifs / polarisation | R10 | 1 | 33k | R1206 | Résistance CMS | Polarisation / pull-up / pont diviseur | Resistor, chip resistor, surface mounted (candidate) | Moyen | Passif générique
Carte principale | Passifs / polarisation | R11 | 1 | 33k | R1206 | Résistance CMS | Polarisation / pull-up / pont diviseur | Resistor, chip resistor, surface mounted (candidate) | Moyen | Passif générique
Carte principale | Passifs / polarisation | R12 | 1 | 33k | R1206 | Résistance CMS | Polarisation / pull-up / pont diviseur | Resistor, chip resistor, surface mounted (candidate) | Moyen | Passif générique
Carte principale | Passifs / polarisation | R13 | 1 | 150k | R1206 | Résistance CMS | Polarisation / pull-up / pont diviseur | Resistor, chip resistor, surface mounted (candidate) | Moyen | Passif générique
Carte principale | Passifs / polarisation | R14 | 1 | 4,7k | R1206 | Résistance CMS | Polarisation / pull-up / pont diviseur | Resistor, chip resistor, surface mounted (candidate) | Moyen | Passif générique
Carte principale | Passifs / polarisation | R15 | 1 | 10k | R1206 | Résistance CMS | Polarisation / pull-up / pont diviseur | Resistor, chip resistor, surface mounted (candidate) | Moyen | Passif générique
Carte principale | Passifs / polarisation | R16 | 1 | ERJ-P08J821V | ERJP08_(1206) | Résistance CMS | Polarisation / pull-up / pont diviseur | Resistor, chip resistor, surface mounted (candidate) | Moyen | Passif générique
Carte principale | Passifs / polarisation | R17 | 1 | WSL2512R1000FEA | RESC6432X89N | Résistance shunt de puissance | Mesure de courant | Resistor, shunt / metal strip resistor (candidate) | Moyen | Passif générique
Carte principale | Commande / communication | RST | 1 | B3U-1000PB | SW_B3U-1000PB | Résistance CMS | Polarisation / pull-up / pont diviseur | Resistor, chip resistor, surface mounted (candidate) | Moyen | Passif générique
Carte principale | Commande / communication | U1 | 1 | ESP-WROOM-03 | ESP-WROOM-03 | Module radio / microcontrôleur | Pilotage + communication | Mounted board / communication module with ICs (candidate) | Bon | MPN identifié
Carte principale | Mesure courant / tension | U2 | 1 | INA219AID | SOIC127P599X175-8N | Capteur de courant / tension | Mesure électrique | Integrated circuit, current sensor (candidate) | Bon | MPN identifié
Carte principale | Capteurs de température | U3 | 1 | DS18B20U+T&R | SOP65P490X110-8N | Capteur de température numérique | Mesure de température | Integrated circuit, temperature sensor (candidate) | Bon | MPN identifié
Carte principale | Capteurs de température | U4 | 1 | DS18B20U+T&R | SOP65P490X110-8N | Capteur de température numérique | Mesure de température | Integrated circuit, temperature sensor (candidate) | Bon | MPN identifié
Carte principale | Capteurs de température | U5 | 1 | DS18B20U+T&R | SOP65P490X110-8N | Capteur de température numérique | Mesure de température | Integrated circuit, temperature sensor (candidate) | Bon | MPN identifié
Carte principale | Capteurs de température | U6 | 1 | DS18B20U+T&R | SOP65P490X110-8N | Capteur de température numérique | Mesure de température | Integrated circuit, temperature sensor (candidate) | Bon | MPN identifié
Carte principale | Alimentation / protection | Z1 | 1 | BZX84C6V8LT1G | SOT96P237X111-3N | Diode Zener | Protection surtension | Diode, protection / zener, mounted (candidate) | Bon | MPN identifié

Sheet: Synthese_blocs
Bloc fonctionnel | Catégorie ACV | Nombre | Consignes
Alimentation / protection | Condensateur électrolytique | 1 | 1 | Remplacer les intitulés candidats par les libellés exacts de vos documents de cours.
Alimentation / protection | Connecteur | 2 | 2 | Valider la répartition des passifs par bloc à partir du schéma.
Alimentation / protection | Diode Zener | 1 | 3 | Ajouter une deuxième déclinaison pour la comparaison ACV finale.
Alimentation / protection | Régulateur linéaire 3,3 V | 1
Capteurs de température | Capteur de température numérique | 4
Commande / communication | Bouton poussoir tactile | 1
Commande / communication | Connecteur | 1
Commande / communication | Module radio / microcontrôleur | 1
Commande / communication | Résistance CMS | 1
Commutation / adaptation | Comparateur | 1
Commutation / adaptation | MOSFET de puissance | 2
Commutation / adaptation | MOSFET petit signal | 2
Connectique de sortie | Connecteur | 4
Mesure courant / tension | Capteur de courant / tension | 1
Passifs / filtrage | Condensateur céramique CMS | 7
Passifs / polarisation | Résistance CMS | 16
Passifs / polarisation | Résistance shunt de puissance | 1

Sheet: BOM_brute
Part | Value | Device | Package | Description
C1 | 100n | C | C0805 | CAPACITOR, European symbol
C2 | 47u | C | C0805 | CAPACITOR, European symbol
C3 | 100n | C | C0805 | CAPACITOR, European symbol
C5 | 0.1µ | C | C0805 | CAPACITOR, European symbol
C6 | 0.1µ | C | C0805 | CAPACITOR, European symbol
C7 | 100n | C | C0805 | CAPACITOR, European symbol
C8 | 10u | C | C0805 | CAPACITOR, European symbol
C9 | 865080663020 | 865080663020 | CAPAE1600X1700N | WCAP-ASLI Aluminum Electrolytic Capacitors ASEK170102M050DVCTHE000; SMT V-Chip; 1000 F +/- 20%; 50 V (DC); 5000 h; - 55 C / +105 C; size DxL 16.0 x 17.0; Max. Iripple 1000 mA@ 100 kHz; LC 500 A; DF 12%;
DOWNLOAD |  | PINHD-1X6S | 1X06S | PIN HEADER
G1 | TLS850B0TE_V33 | TLS850B0TE_V33 | TO114P998X250-6_5N-1
J1 | 282857-2 | 282857-2 | TE_282857-2
J2 | 282857-2 | 282857-2 | TE_282857-2
J3 | 282857-2 | 282857-2 | TE_282857-2
J4 | 282857-2 | 282857-2 | TE_282857-2
J5 | 282834-3 | 282834-3 | TE_282834-3
J6 | XT60PW-M | XT60PW-M | AMASS_XT60PW-M
PROG | B3U-1000PB | B3U-1000PB | SW_B3U-1000PB | Switch Tactile N.O. SPST Round Button Gull Wing 0.05A 12VDC 1.5N SMD Embossed T/R
Q1 | FQB22P10TM | FQB22P10TM | FQB22P10TM | 175C maximum junction temperature rating; Low Crss ( Typ. 160pF); -22A, -100V, RDS(on) =125m(Max.) @VGS = -10 V, ID = -11A; Low gate charge ( Typ.40nC); 100% avalanche tested
Q2 | FQB22P10TM | FQB22P10TM | FQB22P10TM | 175C maximum junction temperature rating; Low Crss ( Typ. 160pF); -22A, -100V, RDS(on) =125m(Max.) @VGS = -10 V, ID = -11A; Low gate charge ( Typ.40nC); 100% avalanche tested
Q3 | AP331AWG-7 | AP331AWG-7 | SOT95P285X145-5N | DiodesZetex AP331AWG-7 Comparator, Open Collector O/P, 1.3us 2 36 V 5-Pin SOT-25
Q4 | BSS138 | BSS138 | SOT95P240X111-3N | Check availability
Q5 | BSS138 | BSS138 | SOT95P240X111-3N | Check availability
R1 | 100k | RR1206 | R1206 | RESISTOR, European symbol
R2 | 100k | RR1206 | R1206 | RESISTOR, European symbol
R3 | 33k | RR1206 | R1206 | RESISTOR, European symbol
R4 | 4,7k | RR1206 | R1206 | RESISTOR, European symbol
R5 | 33k | RR1206 | R1206 | RESISTOR, European symbol
R6 | 3.3k | RR1206 | R1206 | RESISTOR, European symbol
R7 | 2026-02-10 | RR1206 | R1206 | RESISTOR, European symbol
R8 | 2026-02-10 | RR1206 | R1206 | RESISTOR, European symbol
R9 | 3.3k | RR1206 | R1206 | RESISTOR, European symbol
R10 | 33k | RR1206 | R1206 | RESISTOR, European symbol
R11 | 33k | RR1206 | R1206 | RESISTOR, European symbol
R12 | 33k | RR1206 | R1206 | RESISTOR, European symbol
R13 | 150k | RR1206 | R1206 | RESISTOR, European symbol
R14 | 4,7k | RR1206 | R1206 | RESISTOR, European symbol
R15 | 10k | RR1206 | R1206 | RESISTOR, European symbol
R16 | ERJ-P08J821V | ERJ-P08J821V | ERJP08_(1206) | Anti-Surge Thick Film Chip Resistor, 1206, 0.66W
R17 | WSL2512R1000FEA | WSL2512R1000FEA | RESC6432X89N | WSL2512 SMD Resistor,1W,1%,R100 Vishay WSL Series Metal Strip Low Ohmic Surface Mount Resistor 2512 Case 100m +/-1% 1W +/-75ppm/C
RST | B3U-1000PB | B3U-1000PB | SW_B3U-1000PB | Switch Tactile N.O. SPST Round Button Gull Wing 0.05A 12VDC 1.5N SMD Embossed T/R
U1 | ESP-WROOM-03 | ESP-WROOM-03 | ESP-WROOM-03
U2 | INA219AID | INA219AID | SOIC127P599X175-8N
U3 | DS18B20U+T&R | DS18B20U+T&R | SOP65P490X110-8N | Check availability
U4 | DS18B20U+T&R | DS18B20U+T&R | SOP65P490X110-8N | Check availability
U5 | DS18B20U+T&R | DS18B20U+T&R | SOP65P490X110-8N | Check availability
U6 | DS18B20U+T&R | DS18B20U+T&R | SOP65P490X110-8N | Check availability
Z1 | BZX84C6V8LT1G | BZX84C6V8LT1G | SOT96P237X111-3N | 250 mW Rating on FR-4 or FR-5 Board; Zener Breakdown Voltage Range - 2.4 V to 75 V; Package Designed for Optimal Automated Board Assembly; Small Package Size for High Density Applications; ESD Rating of Class 3 (>16 KV) per Human Body Model; Mechanical Characteristics:; CASE: Void-free, transfer-molded, thermosetting plastic case; FINISH: Corrosion resistant finish, easily solderable; MAXIMUM CASE TEMPERATURE FOR SOLDERING PURPOSES: 260C for 10 Seconds; POLARITY: Cathode indicated by polarity band; FLAMMAB

Sheet: V2
Origine | Bloc fonctionnel | Élément groupé | Références groupées | Qté | Masse unitaire (g) | Amount (g) | Unit | Caractéristiques pour l'input | Catégorie ACV | Traduction ecoinvent candidate | Présence dans BOM | Remarques | Masse unitaire (g) copie | Amount (g) copie | Type de source masse | Source(s) masse | Fiabilité | Note méthode
BOM carte principale | Passifs / filtrage | Condensateurs céramiques CMS C0805 | C1,C2,C3,C5,C6,C7,C8 | 7 | 0.008 | 0.056 | g | Capaciteurs céramiques CMS, boîtier 0805, découplage/filtrage | Condensateur céramique CMS | Capacitor, for surface mounting, ceramic (candidate) | Oui | Masse à compléter; regroupement volontaire pour réduire le nombre d'inputs | 0.008 | 0.056 | source web générique 0805 | https://ifuturetech.org/product/0-1uf-0805-package/ | Moyenne | Valeur générique de composant 0805; bonne base si vous gardez le regroupement
BOM carte principale | Alimentation / protection | Condensateur électrolytique CMS | C9 | 1 | 5.359 | 5.359 | g | Condensateur aluminium électrolytique CMS, 16x17 mm env. | Condensateur électrolytique | Capacitor, aluminium electrolytic, mounted (candidate) | Oui |  | 5.359 | 5.359 | Mouser unit weight exact | https://www.mouser.com/ProductDetail/Wurth-Elektronik/865080663020 | Élevée | Référence exacte 865080663020
BOM carte principale | Passifs / polarisation | Résistances CMS 1206 | R1,R2,R3,R4,R5,R6,R7,R8,R9,R10,R11,R12,R13,R14,R15,R16 | 16 | 0.0084 | 0.1344 | g | Résistances chip 1206 standard/anti-surge | Résistance CMS | Resistor, chip resistor, surface mounted (candidate) | Oui | Possibilité de séparer R16 si vous voulez une granularité plus fine | 0.0084 | 0.1344 | datasheet 1206 | https://www.resistor.com/assets/pdf/1206std.pdf | Moyenne | Valeur typique 1206; R16 anti-surge reste inclus dans le groupe
BOM carte principale | Passifs / mesure | Résistance shunt de puissance 2512 | R17 | 1 | 0.0405 | 0.0405 | g | Shunt métal faible ohm, boîtier 2512, 1 W | Résistance shunt | Resistor, shunt / metal strip resistor (candidate) | Oui |  | 0.0405 | 0.0405 | Mouser unit weight exact | https://www.mouser.co.uk/ProductDetail/Vishay-Dale/WSL2512R1000FEA | Élevée | Référence exacte WSL2512R1000FEA
BOM carte principale | Commande / communication | Boutons poussoirs tactiles | PROG,RST | 2 | 0.022 | 0.044 | g | Interrupteurs tactiles CMS SPST | Bouton / switch tactile | Switch, tactile, surface mounted (candidate) | Oui | RST a été reclassé ici | 0.022 | 0.044 | Mouser unit weight exact | https://www.mouser.com/ProductDetail/Omron-Electronics/B3U-1000P-B | Élevée | Alias B3U1000PB
BOM carte principale | Connectique | Connecteurs bornier 2 voies | J1,J2,J3,J4 | 4 | 9.515 | 38.06 | g | Borniers PCB 2 positions | Connecteur | Connector / terminal block for PCB (candidate) | Oui |  | 9.515 | 38.06 | Mouser unit weight exact | https://www.mouser.com/ProductDetail/TE-Connectivity/1-282857-2 | Élevée | Réf. proche/équivalente 1-282857-2 pour 282857-2
BOM carte principale | Connectique | Connecteur bornier 3 voies | J5 | 1 | 1.012 | 1.012 | g | Bornier PCB 3 positions | Connecteur | Connector / terminal block for PCB (candidate) | Oui |  | 1.012 | 1.012 | Mouser unit weight exact | https://www.mouser.com/ProductDetail/TE-Connectivity/282834-3 | Élevée | Référence exacte 282834-3
BOM carte principale | Connectique | Connecteur header 1x6 | DOWNLOAD | 1 | 0.4 | 0.4 | g | Pin header 1x6 | Connecteur | Connector / pin header for PCB (candidate) | Oui |  | 0.4 | 0.4 | source web distributeur | https://digipurk.ee/en/product/pin-single-row-1x6-2-54-mm | Faible | Header générique 1x6; à remplacer si vous avez la réf. exacte
BOM carte principale | Connectique / puissance | Connecteur XT60 | J6 | 1 | 4.104 | 4.104 | g | Connecteur puissance XT60 montage PCB | Connecteur puissance | Connector, high-current, mounted on board (candidate) | Oui |  | 4.104 | 4.104 | source web distributeur | https://www.tme.eu/en/details/xt60pw-m/dc-power-connectors/amass/ | Moyenne | Poids brut affiché; bon ordre de grandeur
BOM carte principale | Alimentation / protection | Régulateur linéaire 3,3 V | G1 | 1 | 0.3 | 0.3 | g | Régulateur LDO 3.3 V boîtier SMD | Circuit intégré - régulateur | Integrated circuit, voltage regulator (candidate) | Oui |  | 0.3 | 0.3 | poids package | https://www.infineon.com/assets/row/public/documents/10/49/infineon-tls850b0te-v33-datasheet-en.pdf | https://fscdn.rohm.com/en/techdata_basic/ic/package/Jisso_TO252-5-1-2_Rev004s_E2%28MSL1%29.pdf | Moyenne | PG-TO252-5 confirmé par Infineon, masse prise sur package TO252-5
BOM carte principale | Commutation / adaptation | MOSFET de puissance | Q1,Q2 | 2 | 3.9499 | 7.8998 | g | MOSFET puissance board-mounted | Transistor MOSFET puissance | Transistor, MOSFET, power, mounted on board (candidate) | Oui |  | 3.9499 | 7.8998 | Mouser unit weight exact | https://www.mouser.com/ProductDetail/onsemi/FQB22P10TM | Élevée | Référence exacte FQB22P10TM
BOM carte principale | Commutation / adaptation | Comparateur analogique | Q3 | 1 | 0.0506 | 0.0506 | g | Comparateur analogique SOT-25 | Circuit intégré analogique | Integrated circuit, analog comparator (candidate) | Oui |  | 0.0506 | 0.0506 | Mouser unit weight exact | https://www.mouser.com/ProductDetail/Diodes-Incorporated/AP331AWG-7 | Élevée | Référence exacte AP331AWG-7
BOM carte principale | Commutation / adaptation | MOSFET petit signal | Q4,Q5 | 2 | 0.008 | 0.016 | g | MOSFET petits signaux SOT-23 | Transistor MOSFET petit signal | Transistor, MOSFET, small signal, mounted (candidate) | Oui |  | 0.008 | 0.016 | datasheet / Mouser | https://www.mouser.com/datasheet/2/115/ds30144-1164515.pdf | Élevée | Datasheet BSS138: 0.008 g approx
BOM carte principale | Commande / communication | Module ESP-WROOM-03 | U1 | 1 | 3 | 3 | g | Module radio + microcontrôleur monté | Module de communication / MCU | Mounted board / communication module with ICs (candidate) | Oui | Présent dans la BOM fournie | 3 | 3 | valeur fournie utilisateur / capture Excel | https://maldives.desertcart.com/products/49543933-esp-wroom-32-esp32-wifi-bt-ble-module | Faible | ESP-WROOM-03 historique, source exacte de masse non trouvée
Ajout manuel | Commande / communication | ESP32-WROOM-32E Development Kit |  | 1 | 25.292 | 25.292 | g | Carte de développement ESP32 avec module ESP32-WROOM-32E | Module de communication / MCU | Mounted board / development kit with ICs (candidate) | Non (ajout manuel) | Remplace l'ancien module ESP32 ajouté manuellement | 25.292 | 25.292 | Mouser unit weight exact | https://eu.mouser.com/ProductDetail/Espressif-Systems/ESP32-DevKitC-32E | Élevée | Référence de carte de développement complète, pas module nu
BOM carte principale | Mesure courant / tension | Capteur INA219 | U2 | 1 | 0.1 | 0.1 | g | Capteur courant/tension boîtier SOIC-8 | Circuit intégré de mesure | Integrated circuit, current sensor (candidate) | Oui |  | 0.1 | 0.1 | valeur fournie utilisateur / capture Excel | https://www.mouser.com/ProductDetail/Texas-Instruments/INA219AID | Élevée | Référence exacte INA219AID
BOM carte principale | Capteurs de température | Capteurs DS18B20 | U3,U4,U5,U6 | 4 | 0.2 | 0.8 | g | Capteurs de température numériques | Capteur de température | Integrated circuit, temperature sensor (candidate) | Oui |  | 0.2 | 0.8 | valeur fournie utilisateur / capture Excel | https://nz.mouser.com/ProductDetail/Analog-Devices-Maxim-Integrated/DS18B20%2BTR | Élevée | Série DS18B20, 200 mg unitaire
BOM carte principale | Alimentation / protection | Diode Zener | Z1 | 1 | 0.02 | 0.02 | g | Diode Zener SMD SOT-23 | Diode de protection | Diode, protection / zener, mounted (candidate) | Oui |  | 0.02 | 0.02 | valeur fournie utilisateur / capture Excel | https://eu.mouser.com/ProductDetail/onsemi/BZX84C6V8LT1G | Élevée | Référence exacte BZX84C6V8LT1G
Ajout manuel | Système externe | Panneau solaire |  | 1 | 250 | 250 | g | Panneau solaire - masse fournie, technologie à préciser | Sous-système énergie | Photovoltaic panel / module (candidate) | Non (ajout manuel) | Valeur ajoutée depuis votre capture Excel | 2250 | 2250 | valeur fournie utilisateur / capture Excel |  | N/A | Impossible d'être précis sans référence exacte
Ajout manuel | Actionnement | ULN2003 |  | 1 | 12 | 12 | g | Driver ULN2003 pour petit moteur pas-à-pas | Actionneur / moteur | Integrated circuit, driver / actuator control (candidate) | Non | Ajout demandé depuis votre capture Excel | 12 | 12 | valeur fournie utilisateur / capture Excel |  | N/A | Impossible d'être précis sans référence exacte
Ajout manuel | Actionnement | Step motor 28BYJ-48 |  | 1 | 34 | 34 | g | Moteur pas-à-pas 28BYJ-48 | Actionneur / moteur | Electric motor, small / mounted assembly (candidate) | Non (ajout manuel) | Valeur ajoutée depuis votre capture Excel | 34 | 34 | valeur fournie utilisateur / capture Excel |  | N/A | Impossible d'être précis sans données matériau/masse
Ajout manuel | Capteurs de lumière | Photoresistor GL5506 |  | 2 | 0.57 | 1.14 | g | Photorésistances GL5506 | Capteur de lumière | Light sensor / photoresistor (candidate) | Non | Ajout demandé depuis votre capture Excel | 0.57 | 1.14 | valeur fournie utilisateur / capture Excel
Ajout manuel | Mécanique | Support 3D |  | 1 | 165 | 165 | g | Pièce imprimée 3D - masse fournie ; matériau et remplissage à préciser | Support mécanique | Plastic part, 3D printed / thermoplastic part (candidate) | Non (ajout manuel) | Valeur ajoutée depuis votre capture Excel | 165 | 165 | valeur fournie utilisateur / capture Excel
Ajout manuel | Capteurs de température | Capteurs externes LM35 |  | 2 | 0.15 | 0.3 | g | Capteurs de température analogiques LM35 | Capteur de température | Integrated circuit, temperature sensor (candidate) | Non | Ajout demandé depuis votre capture Excel | 0.15 | 0.3 | valeur fournie utilisateur / capture Excel
Ajout manuel | Actionnement | Câbles |  | 15 | 0.22 | 3.4 | g
Ajout manuel | Commande / communication | PCB |  | 1 | 30 | 30 | g |  |  |  |  |  |  | 2526.8363
 |  |  |  |  | Total masse saisie (g) | 582.5283 |  |  |  |  |  |  | Total masse saisie (g)
Notes d'utilisation OpenLCA
1 | Renseigner d'abord la masse unitaire de chaque ligne en kg ; la colonne Amount se calcule automatiquement.
2 | Conserver les lignes ajout manuel uniquement si elles font partie de la variante analysée.
3 | Les traductions ecoinvent sont des candidats à valider avec vos documents de cours.
3 | Les traductions ecoinvent sont des candidats à valider avec vos documents de cours.

Sheet: OpenLCA_inputs
Origine | Bloc fonctionnel | Élément groupé | Références groupées | Qté | Masse unitaire (g) | Amount | Unit | Caractéristiques pour l'input | Catégorie ACV | Traduction ecoinvent candidate | Présence dans BOM | Remarques
BOM carte principale | Passifs / filtrage | Condensateurs céramiques CMS C0805 | C1,C2,C3,C5,C6,C7,C8 | 7 | 0.002 | 0.014 | g | Capaciteurs céramiques CMS, boîtier 0805, découplage/filtrage | Condensateur céramique CMS | Capacitor, for surface mounting, ceramic (candidate) | Oui | Masse à compléter; regroupement volontaire pour réduire le nombre d'inputs
BOM carte principale | Alimentation / protection | Condensateur électrolytique CMS | C9 | 1 | 5.000000 | 5.000000 | g | Condensateur aluminium électrolytique CMS, 16x17 mm env. | Condensateur électrolytique | Capacitor, aluminium electrolytic, mounted (candidate) | Oui
BOM carte principale | Passifs / polarisation | Résistances CMS 1206 | R1,R2,R3,R4,R5,R6,R7,R8,R9,R10,R11,R12,R13,R14,R15,R16 | 16 | 0.01 | 0.16 | g | Résistances chip 1206 standard/anti-surge | Résistance CMS | Resistor, chip resistor, surface mounted (candidate) | Oui | Possibilité de séparer R16 si vous voulez une granularité plus fine
BOM carte principale | Passifs / mesure | Résistance shunt de puissance 2512 | R17 | 1 | 0.1 | 0.1 | g | Shunt métal faible ohm, boîtier 2512, 1 W | Résistance shunt | Resistor, shunt / metal strip resistor (candidate) | Oui
BOM carte principale | Commande / communication | Boutons poussoirs tactiles | PROG,RST | 2 | 0.2 | 0.4 | g | Interrupteurs tactiles CMS SPST | Bouton / switch tactile | Switch, tactile, surface mounted (candidate) | Oui | RST a été reclassé ici
BOM carte principale | Connectique | Connecteurs bornier 2 voies | J1,J2,J3,J4 | 4 | 2026-05-01 | 6.000000 | g | Borniers PCB 2 positions | Connecteur | Connector / terminal block for PCB (candidate) | Oui
BOM carte principale | Connectique | Connecteur bornier 3 voies | J5 | 1 | 2026-02-02 | 2026-02-02 | g | Bornier PCB 3 positions | Connecteur | Connector / terminal block for PCB (candidate) | Oui
BOM carte principale | Connectique | Connecteur header 1x6 | DOWNLOAD | 1 | 0.5 | 0.5 | g | Pin header 1x6 | Connecteur | Connector / pin header for PCB (candidate) | Oui
BOM carte principale | Connectique / puissance | Connecteur XT60 | J6 | 1 | 2026-05-07 | 2026-05-07 | g | Connecteur puissance XT60 montage PCB | Connecteur puissance | Connector, high-current, mounted on board (candidate) | Oui
BOM carte principale | Alimentation / protection | Régulateur linéaire 3,3 V | G1 | 1 | 0.05 | 0.05 | g | Régulateur LDO 3.3 V boîtier SMD | Circuit intégré - régulateur | Integrated circuit, voltage regulator (candidate) | Oui
BOM carte principale | Commutation / adaptation | MOSFET de puissance | Q1,Q2 | 2 | 2026-05-01 | 3.000000 | g | MOSFET puissance board-mounted | Transistor MOSFET puissance | Transistor, MOSFET, power, mounted on board (candidate) | Oui
BOM carte principale | Commutation / adaptation | Comparateur analogique | Q3 | 1 | 0.01 | 0.01 | g | Comparateur analogique SOT-25 | Circuit intégré analogique | Integrated circuit, analog comparator (candidate) | Oui
BOM carte principale | Commutation / adaptation | MOSFET petit signal | Q4,Q5 | 2 | 0.006 | 0.0012 | g | MOSFET petits signaux SOT-23 | Transistor MOSFET petit signal | Transistor, MOSFET, small signal, mounted (candidate) | Oui
BOM carte principale | Commande / communication | Module ESP-WROOM-03 | U1 | 1 | 3.000000 | 3.000000 | g | Module radio + microcontrôleur monté | Module de communication / MCU | Mounted board / communication module with ICs (candidate) | Oui | Présent dans la BOM fournie
Ajout manuel | Commande / communication | ESP32 |  | 1 | 3.000000 | 3.000000 | g | Module ESP32 à renseigner précisément selon la référence finale | Module de communication / MCU | Mounted board / communication module with ICs (candidate) | Non (ajout manuel) | À conserver seulement si votre variante finale utilise bien un ESP32
BOM carte principale | Mesure courant / tension | Capteur INA219 | U2 | 1 | 0.100000 | 0.100000 | g | Capteur courant/tension boîtier SOIC-8 | Circuit intégré de mesure | Integrated circuit, current sensor (candidate) | Oui
BOM carte principale | Capteurs de température | Capteurs DS18B20 | U3,U4,U5,U6 | 4 | 0.200000 | 0.800000 | g | Capteurs de température numériques | Capteur de température | Integrated circuit, temperature sensor (candidate) | Oui
BOM carte principale | Alimentation / protection | Diode Zener | Z1 | 1 | 0.020000 | 0.020000 | g | Diode Zener SMD SOT-23 | Diode de protection | Diode, protection / zener, mounted (candidate) | Oui
Ajout manuel | Système externe | Panneau solaire |  | 1 | 2250.000000 | 2250.000000 | g | Panneau solaire - préciser technologie, puissance, dimensions, masse | Sous-système énergie | Photovoltaic panel / module (candidate) | Non (ajout manuel) | Prévu pour comparaison ACV / système complet
Ajout manuel | Actionnement | ULN2003 |  |  | 12 | 12 | g |  | Actionneur / moteur |  | Non, pas encore | allows low power devices to control heavier loads
Ajout manuel | Actionnement | Step motor 28BYJ-48 |  | 1 | 34.000000 | 34.000000 | g | Moteur rotatif - préciser type, tension, puissance, masse | Actionneur / moteur | Electric motor, small / mounted assembly (candidate) | Non (ajout manuel) | Prévu pour comparaison ACV / système complet
Ajout manuel | Capteurs de lumière | Photoresistor GL5506 |  | 2 | 0.57 | 1.14 | g |  | Capteur de lumière |  | Non
Ajout manuel | Microcontrolleur |  |  |  | 25 | 25 | g |  | mcu
Ajout manuel | Mécanique | Support 3D |  | 1 | 165.000000 | 165.000000 | g | Pièce imprimée 3D - matériau, taux de remplissage, dimensions et masse à préciser | Support mécanique | Plastic part, 3D printed / thermoplastic part (candidate) | Non (ajout manuel) | À compléter avec tes données exactes plus tard
Ajout manuel | Capteurs de température | Capteurs externes LM35 |  | 2 | 0.150000 | 0.300000 | g | Capteurs de température numériques | Capteur de température
Ajout manuel | Resistances Chauffantes
 |  |  |  |  | Total masse saisie | 94712.060000 | g
Notes d'utilisation OpenLCA
1 | Renseigner d'abord la masse unitaire de chaque ligne en kg ; la colonne Amount se calcule automatiquement.
2 | Conserver les lignes ajout manuel uniquement si elles font partie de la variante analysée.
3 | Les traductions ecoinvent sont des candidats à valider avec vos documents de cours.
