eyazaoun/BeeWarm/ecoconception/BeeWarm_Ecoconception.xlsx

Sheet: BeeWarm System
Database | ELSE4-BeeWarm
format | Excel spreadsheet
Activity | BeeWarm System
code | BeeWarm-System
Exchanges
name | alt-name | amount | unit | database | categories | location | type | uncertainty type | loc | scale | shape | minimum | maximum
BeeWarm System |  | 1 | unit | ELSE4-BeeWarm |  | GLO | production | 0 | (Unknown) | (Unknown) | (Unknown) | (Unknown) | (Unknown)
Control PCB production | PCB ESP32 | 1 | unit | ELSE4-BeeWarm |  | GLO | technosphere | 0 | (Unknown) | (Unknown) | (Unknown) | (Unknown) | (Unknown)
Orientation System production | Motor+LDR | 1 | unit | ELSE4-BeeWarm |  | GLO | technosphere | 0 | (Unknown) | (Unknown) | (Unknown) | (Unknown) | (Unknown)
photovoltaic panel production, single-Si | Solar panel 10W | 0.28 | kilogram | ecoinvent-391-cutoff |  | GLO | technosphere | 0 | (Unknown) | (Unknown) | (Unknown) | (Unknown) | (Unknown)
market for resistance wire, for heating | Heating resistors cadre | 0.04 | kilogram | ecoinvent-391-cutoff |  | GLO | technosphere | 0 | (Unknown) | (Unknown) | (Unknown) | (Unknown) | (Unknown)
market for vegetable oil, for technical applications | Vegetaline (thermal storage) | 0.5 | kilogram | ecoinvent-391-cutoff |  | GLO | technosphere | 0 | (Unknown) | (Unknown) | (Unknown) | (Unknown) | (Unknown)

Sheet: Control PCB production
Activity | Control PCB production
code | Control-PCB-production
Exchanges
name | alt-name | amount | unit | database | categories | location | type | uncertainty type | loc | scale | shape | minimum | maximum
Control PCB production |  | 1 | unit | ELSE4-BeeWarm |  | GLO | production | 0 | (Unknown) | (Unknown) | (Unknown) | (Unknown) | (Unknown)
market for printed wiring board, for surface mounting, Pb free surface | PCB 2 layers | 0.009 | square meter | ecoinvent-391-cutoff | pcb | GLO | technosphere | 0 | (Unknown) | (Unknown) | (Unknown) | (Unknown) | (Unknown)
market for mounting, surface mount technology, Pb-free solder | PCB mounting | 0.009 | square meter | ecoinvent-391-cutoff | pcb | GLO | technosphere | 0 | (Unknown) | (Unknown) | (Unknown) | (Unknown) | (Unknown)
market for capacitor, for surface-mounting | capacitors 0805 ceramic (C2-C8, x7) | 7e-05 | kilogram | ecoinvent-391-cutoff | passive-component | GLO | technosphere | 0 | (Unknown) | (Unknown) | (Unknown) | (Unknown) | (Unknown)
market for capacitor, tantalum-, for through-hole mounting | capacitor electrolytic 1mF 50V (C1) | 0.003 | kilogram | ecoinvent-391-cutoff | passive-component | GLO | technosphere | 0 | (Unknown) | (Unknown) | (Unknown) | (Unknown) | (Unknown)
market for resistor, surface-mounted | resistors 1206 SMD (x14) | 0.00021 | kilogram | ecoinvent-391-cutoff | passive-component | GLO | technosphere | 0 | (Unknown) | (Unknown) | (Unknown) | (Unknown) | (Unknown)
market for resistor, surface-mounted | shunt resistor 2512 (R_shunt1) | 0.0002 | kilogram | ecoinvent-391-cutoff | passive-component | GLO | technosphere | 0 | (Unknown) | (Unknown) | (Unknown) | (Unknown) | (Unknown)
market for diode, glass-, for surface-mounting | Zener diode SOT-23 6.8V (D1) | 1.5e-05 | kilogram | ecoinvent-391-cutoff | passive-component | GLO | technosphere | 0 | (Unknown) | (Unknown) | (Unknown) | (Unknown) | (Unknown)
market for transistor, surface-mounted | N-MOSFET BSS138 SOT-23 (QN1,QN2 x2) | 3e-05 | kilogram | ecoinvent-391-cutoff | passive-component | GLO | technosphere | 0 | (Unknown) | (Unknown) | (Unknown) | (Unknown) | (Unknown)
market for transistor, surface-mounted | P-MOSFET FQB22P10 TO-263 (QP1,QP2 x2) | 0.003 | kilogram | ecoinvent-391-cutoff | passive-component | GLO | technosphere | 0 | (Unknown) | (Unknown) | (Unknown) | (Unknown) | (Unknown)
market for integrated circuit, logic type | ESP32-WROOM-32E WiFi+BT module (U2) | 0.0032 | kilogram | ecoinvent-391-cutoff | ic | GLO | technosphere | 0 | (Unknown) | (Unknown) | (Unknown) | (Unknown) | (Unknown)
market for integrated circuit, logic type | INA219 power monitor SOT23-8 (U3) | 2e-05 | kilogram | ecoinvent-391-cutoff | ic | GLO | technosphere | 0 | (Unknown) | (Unknown) | (Unknown) | (Unknown) | (Unknown)
market for integrated circuit, logic type | AP331A comparator SOT-25 (U1) | 1.5e-05 | kilogram | ecoinvent-391-cutoff | ic | GLO | technosphere | 0 | (Unknown) | (Unknown) | (Unknown) | (Unknown) | (Unknown)
market for integrated circuit, logic type | LDO 3.3V TLS850B0 SOT-223 (ULR1) | 0.0001 | kilogram | ecoinvent-391-cutoff | ic | GLO | technosphere | 0 | (Unknown) | (Unknown) | (Unknown) | (Unknown) | (Unknown)
market for integrated circuit, logic type | DS18B20 temp sensor SO-8 (UT1-4 x4) | 0.00028 | kilogram | ecoinvent-391-cutoff | ic | GLO | technosphere | 0 | (Unknown) | (Unknown) | (Unknown) | (Unknown) | (Unknown)
market for electric connector, peripheral type buss | XT60 power connector male (J1) | 0.007 | kilogram | ecoinvent-391-cutoff | peripheral | GLO | technosphere | 0 | (Unknown) | (Unknown) | (Unknown) | (Unknown) | (Unknown)
market for electric connector, peripheral component interconnect buss | 6-pin header right-angle (J2) | 0.0015 | kilogram | ecoinvent-391-cutoff | peripheral | GLO | technosphere | 0 | (Unknown) | (Unknown) | (Unknown) | (Unknown) | (Unknown)
market for electric connector, peripheral component interconnect buss | 2-pin headers (PR11,PR12,PR21,PR22 x4) | 0.0012 | kilogram | ecoinvent-391-cutoff | peripheral | GLO | technosphere | 0 | (Unknown) | (Unknown) | (Unknown) | (Unknown) | (Unknown)
market for electric connector, peripheral component interconnect buss | 3-pin header (PT1) | 0.0004 | kilogram | ecoinvent-391-cutoff | peripheral | GLO | technosphere | 0 | (Unknown) | (Unknown) | (Unknown) | (Unknown) | (Unknown)

Sheet: Orientation System
Activity | Orientation System production
code | Orientation-System-production
Exchanges
name | alt-name | amount | unit | database | categories | location | type | uncertainty type | loc | scale | shape | minimum | maximum
Orientation System production |  | 1 | unit | ELSE4-BeeWarm |  | GLO | production | 0 | (Unknown) | (Unknown) | (Unknown) | (Unknown) | (Unknown)
market for electric motor, small power | stepper motor 28BYJ-48 | 0.03 | kilogram | ecoinvent-391-cutoff |  | GLO | technosphere | 0 | (Unknown) | (Unknown) | (Unknown) | (Unknown) | (Unknown)
market for integrated circuit, logic type | ULN2003 stepper driver IC (DIP-16) | 0.001 | kilogram | ecoinvent-391-cutoff | ic | GLO | technosphere | 0 | (Unknown) | (Unknown) | (Unknown) | (Unknown) | (Unknown)
market for printed wiring board, for surface mounting, Pb free surface | ULN2003 driver PCB | 0.0005 | square meter | ecoinvent-391-cutoff | pcb | GLO | technosphere | 0 | (Unknown) | (Unknown) | (Unknown) | (Unknown) | (Unknown)
market for resistor, surface-mounted | photoresistors LDR (x2) | 0.001 | kilogram | ecoinvent-391-cutoff | passive-component | GLO | technosphere | 0 | (Unknown) | (Unknown) | (Unknown) | (Unknown) | (Unknown)
market for polylactic acid, ingots | 3D printed PLA support structure (orientation) | 0.05 | kilogram | ecoinvent-391-cutoff |  | GLO | technosphere | 0 | (Unknown) | (Unknown) | (Unknown) | (Unknown) | (Unknown)
