eyazaoun/BeeWarm/(commit log)

2025-10-08 Create AnasESSALIMI.md
    cahier de suivi ESSALIMI Anas
2025-10-28 Add files via upload
    Seance 2 : Diagrammes MBSE pour clarifier les exigences et les buts du projet BEEWARM
2026-04-19 Add files via upload
    Voici mon justificatif d'absence pour la séance 11 19/02/2026 . merci pour votre compréhension
