eyazaoun/BeeWarm/Progress/Photos/20260505_100146.jpg

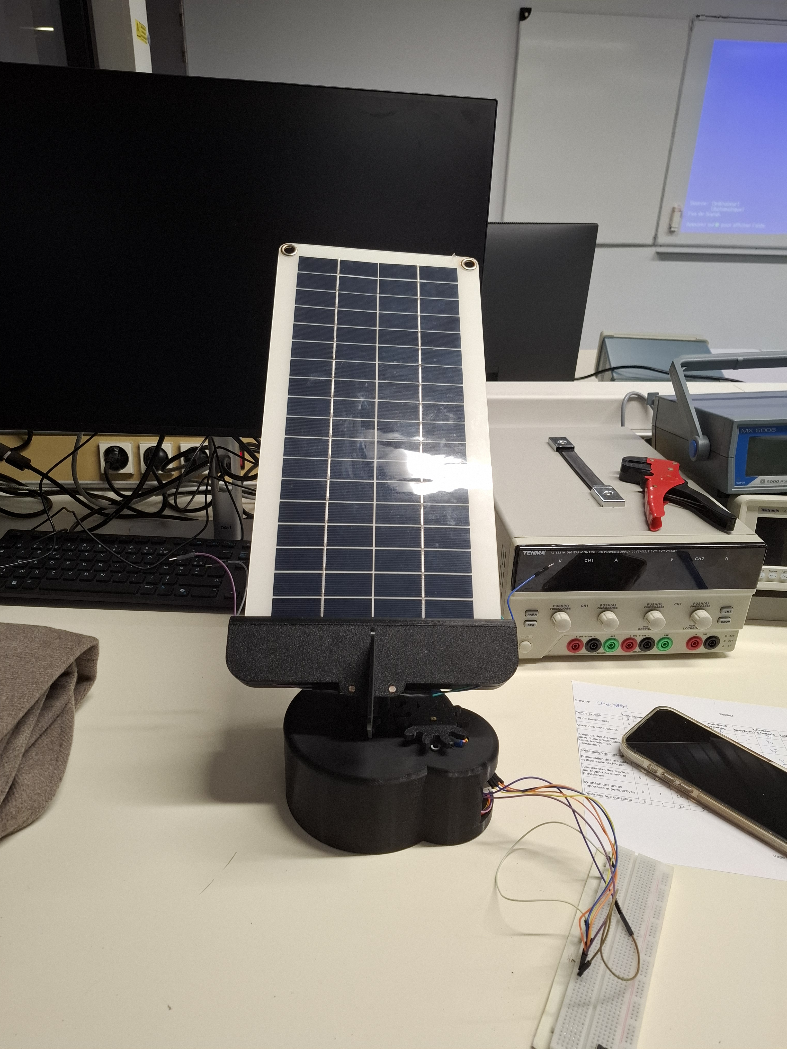
Progress/Photos/20260505_100146.jpg
