eyazaoun/BeeWarm/Progress/Photos/20260505_100150.jpg

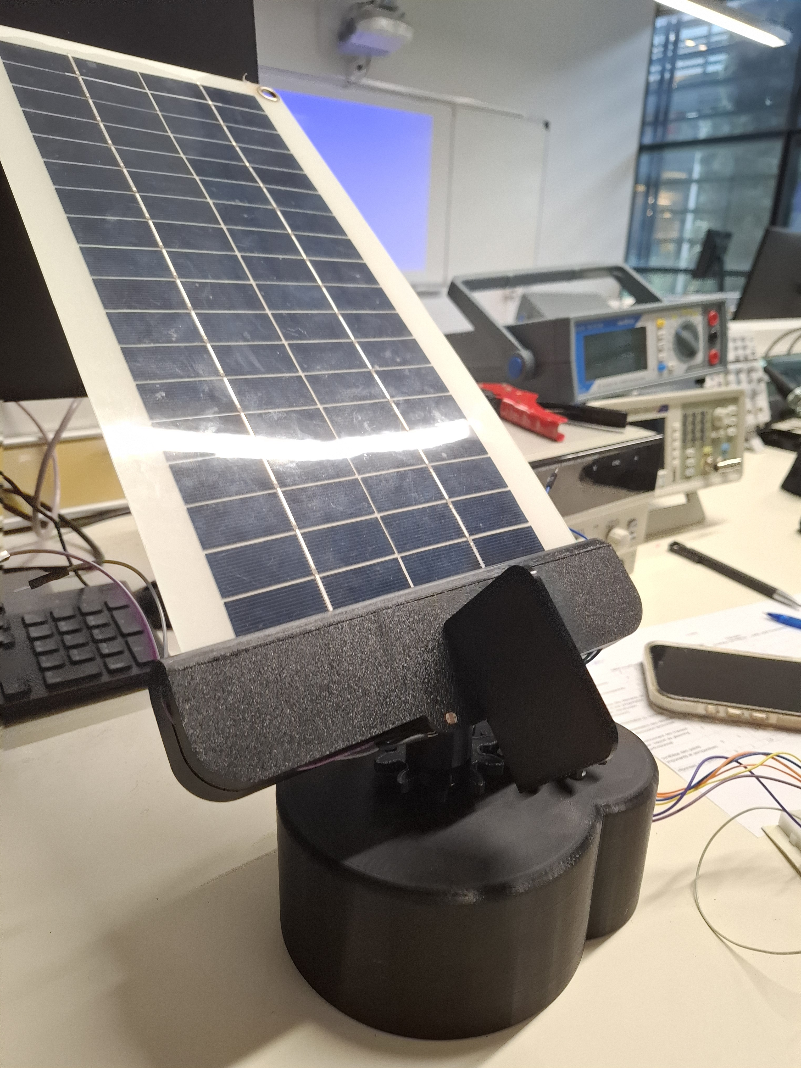
Progress/Photos/20260505_100150.jpg
