eyazaoun/BeeWarm/Progress/Photos/20260505_113555.jpg

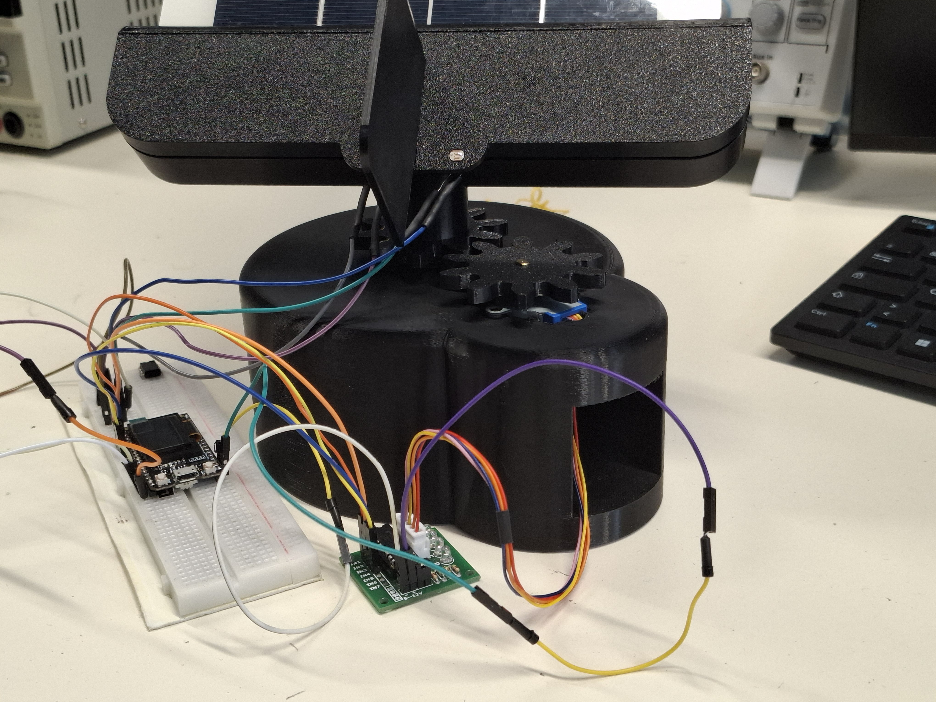
Progress/Photos/20260505_113555.jpg
