eyazaoun/BeeWarm/Progress/Photos/20260505_113600.jpg

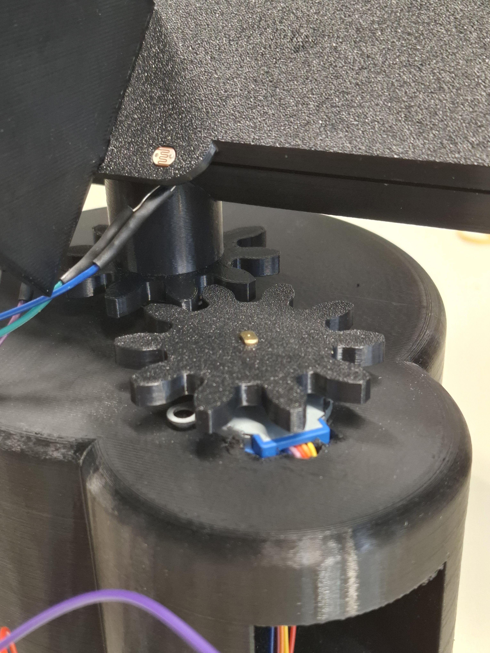
Progress/Photos/20260505_113600.jpg
